EclipseETS/E10-BMS-HW/Master_Board/E10/V3/Documentation/BMS_MasterBoard_E10_3DRender_V2.pdf.jpg

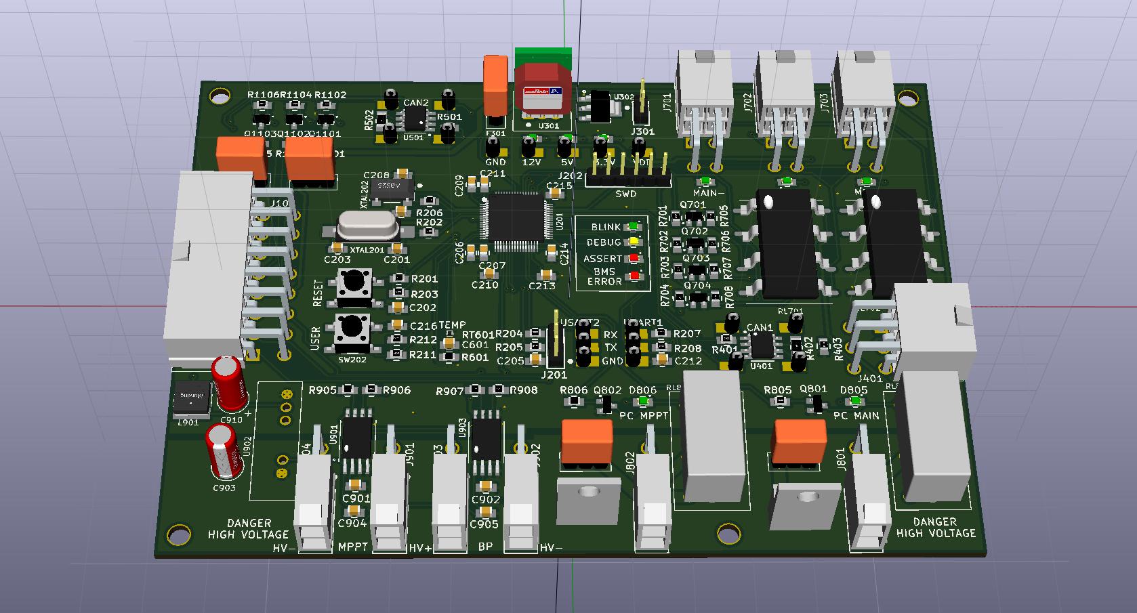
Master_Board/E10/V3/Documentation/BMS_MasterBoard_E10_3DRender_V2.pdf.jpg
