EclipseETS/E10-BMS-HW/Master_Board/E10/V3/Documentation/BMS_MasterBoard_E10_Layout_V2.pdf.JPG

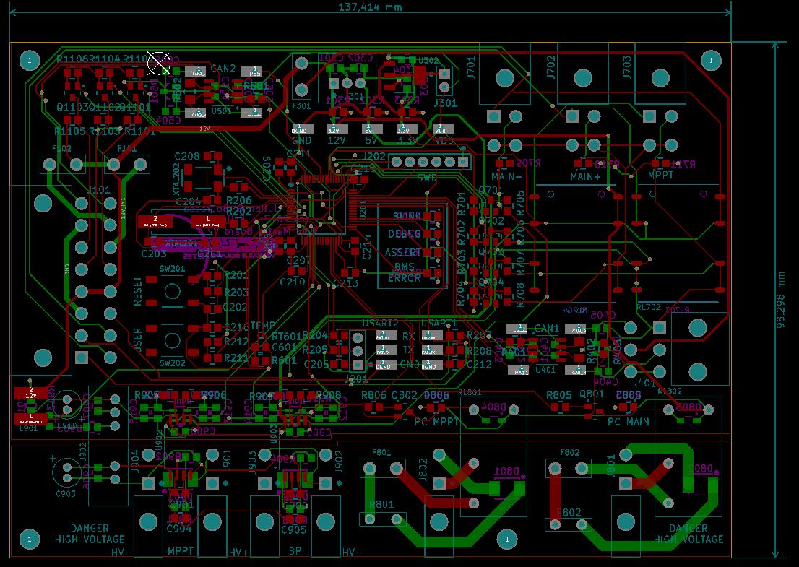
Master_Board/E10/V3/Documentation/BMS_MasterBoard_E10_Layout_V2.pdf.JPG
