EclipseETS/E10-BMS-HW/Master_Board/E10.1/V3/Documentation/bms master block diagram.pdf

## Battery Management System Block Diagram

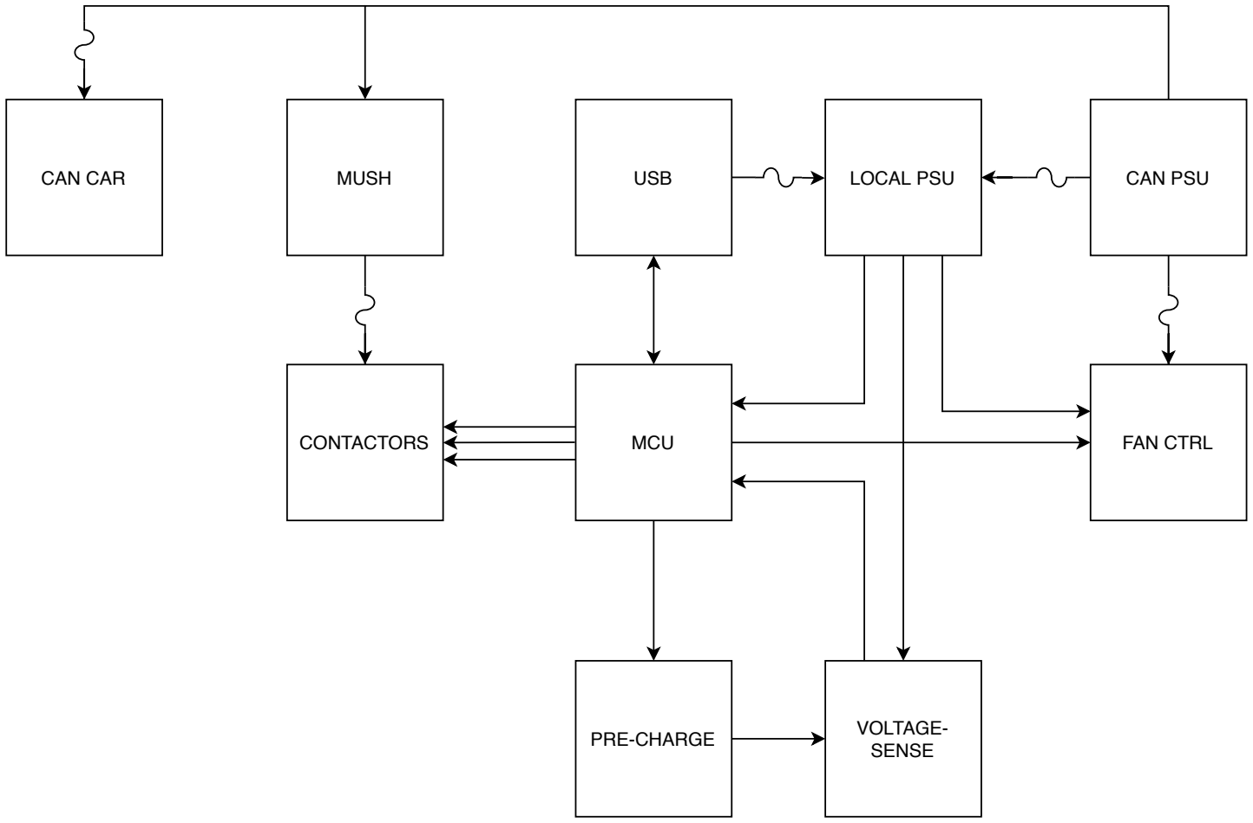
[picture p3: figure]
MCU; FAN CTRL; CAN CAR; MUSH; PRE-CHARGE; LOCAL PSU; CAN PSU; VOLTAGE- SENSE; CONTACTORS; USB
