EclipseETS/E10-BMS-HW/Current_Sense/V1/Current_sense_TOP.png

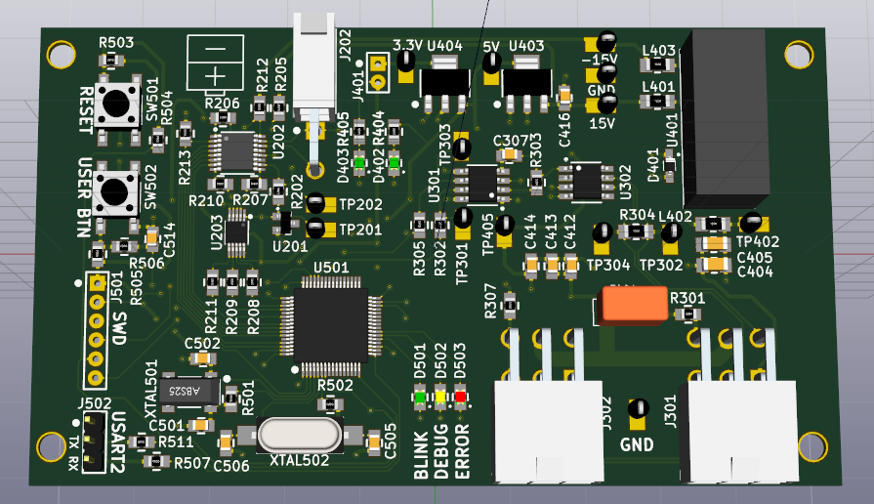
Current_Sense/V1/Current_sense_TOP.png
