EclipseETS/E10-BMS-HW/Current_Sense/V1/BOM/BMS_CurrentSense_BOM.xlsx

Digikey Part Number | Manufacturer | Manufacturer Part Number | Costumer Reference | Project | Qty | Unit Price | Total
732-7826-1-ND | Wurth Electronics Inc. | 885012007027 | Christian | BMS_CurrentSense | 2
732-7848-1-ND | Wurth Electronics Inc. | 885012007053 | Christian | BMS_CurrentSense | 3
732-7624-1-ND | Wurth Electronics Inc. | 885012007027 | Christian | BMS_CurrentSense | 3
732-7625-1-ND | Wurth Electronics Inc. | 885012107015 | Christian | BMS_CurrentSense | 3
732-7628-1-ND | Wurth Electronics Inc. | 885012107018 | Christian | BMS_CurrentSense | 8
732-8062-1-ND | Wurth Electronics Inc. | 885012207080 | Christian | BMS_CurrentSense | 4
732-8074-1-ND | Wurth Electronics Inc. | 885012207092 | Christian | BMS_CurrentSense | 1
732-8080-1-ND | Wurth Electronics Inc. | 885012207098 | Christian | BMS_CurrentSense | 13
732-7677-1-ND | Wurth Electronics Inc. | 885012207102 | Christian | BMS_CurrentSense | 3
445-8046-1-ND | TDK Corporation | C3216X5R1E336M160AC | Christian | BMS_CurrentSense | 10
732-4984-1-ND | Wurth Electronics Inc. | 150080RS75000 | Christian | BMS_CurrentSense | 1
732-4986-1-ND | Wurth Electronics Inc. | 150080VS75000 | Christian | BMS_CurrentSense | 3
732-4987-1-ND | Wurth Electronics Inc. | 150080YS75000 | Christian | BMS_CurrentSense | 1
D1213A-02SOL-7DICT-ND | Diodes Incorporated | D1213A-02SOL-7 | Christian | BMS_CurrentSense | 2
NSR0530HT1GOSCT-ND | ON Semiconductor | NSR0530HT1G | Christian | BMS_CurrentSense | 1
WK0009-ND | Littelfuse Inc. | 56200001009 | Christian | BMS_CurrentSense | 1
732-1937-ND | Wurth Electronics Inc. | 649002227222 | Christian | BMS_CurrentSense | 1
732-1939-ND | Wurth Electronics Inc. | 649006227222 | Christian | BMS_CurrentSense | 2
490-6706-1-ND | Murata Electronics North America | LQM31PN4R7M00L | Christian | BMS_CurrentSense | 3
311-0.0ARCT-ND | Yageo | RC0805JR-070RL | Christian | BMS_CurrentSense | 4
311-100ARCT-ND | Yageo | RC0805JR-07100RL | Christian | BMS_CurrentSense | 9
311-1.0KARCT-ND | Yageo | RC0805JR-071KL | Christian | BMS_CurrentSense | 2
311-22ARCT-ND | Yageo | RC0805JR-0722RL | Christian | BMS_CurrentSense | 3
311-2.2KARCT-ND | Yageo | RC0805JR-072K2L | Christian | BMS_CurrentSense | 1
311-470ARCT-ND | Yageo | RC0805JR-07470RL | Christian | BMS_CurrentSense | 5
311-47KARCT-ND | Yageo | RC0805JR-0747KL | Christian | BMS_CurrentSense | 3
311-4.7KARCT-ND | Yageo | RC0805JR-074K7L | Christian | BMS_CurrentSense | 3
311-120ERCT-ND | Yageo | RC1206JR-07120RL | Christian | BMS_CurrentSense | 1
CKN9112CT-ND | C&K | PTS645SM43SMTR92 LFS | Christian | BMS_CurrentSense | 2
ADC141S626CIMM/NOPBCT-ND | Texas Instruments | ADC141S626CIMM/NOPB | Christian | BMS_CurrentSense | 1
576-2568-1-ND | Microchip Technology | LM4040CYM3-4.1-TR | Christian | BMS_CurrentSense | 1
NCP1117LPST33T3GOSCT-ND | ON Semiconductor | NCP1117LPST33T3G | Christian | BMS_CurrentSense | 2
NCP1117ST50T3GOSCT-ND | ON Semiconductor | NCP1117ST50T3G | Christian | BMS_CurrentSense | 1
296-40483-1-ND | Texas Instruments | PGA281AIPWR | Christian | BMS_CurrentSense | 1
102-2825-ND | CUI Inc. | PQMC3-D12-D15-S | Christian | BMS_CurrentSense | 1
SI8422AB-D-IS-ND | Silicon Labs | SI8422AB-D-IS | Christian | BMS_CurrentSense | 1
296-26344-1-ND | Texas Instruments | SN65HVD232DR | Christian | BMS_CurrentSense | 1
497-15376-ND | STMicroelectronics | STM32F446RET6 | Christian | BMS_CurrentSense | 1
535-13445-2-ND | Abracon LLC | ABLS-8.000MHZ-D-T | Christian | BMS_CurrentSense | 1
535-10240-1-ND | Abracon LLC | ABS25-32.768KHZ-6-T | Christian | BMS_CurrentSense | 1
