EclipseETS/E10-BMS-HW/Slave/V1/BOM/Slave_Digikey.xlsx

Digikey Part Number | Manufacturer Name | Manufacturer Part Number | Costumer Reference | QTY | Circuit | Unit Price | Total | Grand Total
732-7826-1-ND | Wurth Electronics Inc. | 885012007027 | Christian | 2 | BMS_Slave | 0.15 | 0.3 | 331.151
732-7848-1-ND | Wurth Electronics Inc. | 885012007053 | Christian | 7 | BMS_Slave | 0.15 | 1.05
732-7616-1-ND | Wurth Electronics Inc. | 885012107005 | Christian | 1 | BMS_Slave | 0.44 | 0.44
732-7624-1-ND | Wurth Electronics Inc. | 885012007027 | Christian | 41 | BMS_Slave | 0.38 | 15.58
732-7625-1-ND | Wurth Electronics Inc. | 885012107015 | Christian | 13 | BMS_Slave | 0.22 | 2.86
732-7628-1-ND | Wurth Electronics Inc. | 885012107018 | Christian | 3 | BMS_Slave | 0.41 | 1.23
732-7660-1-ND | Wurth Electronics Inc. | 885012207047 | Christian | 8 | BMS_Slave | 0.25 | 2
732-8062-1-ND | Wurth Electronics Inc. | 885012207080 | Christian | 9 | BMS_Slave | 0.15 | 1.35
732-8074-1-ND | Wurth Electronics Inc. | 885012207092 | Christian | 1 | BMS_Slave | 0.15 | 0.15
732-8080-1-ND | Wurth Electronics Inc. | 885012207098 | Christian | 50 | BMS_Slave | 0.09 | 4.5
732-4984-1-ND | Wurth Electronics Inc. | 150080RS75000 | Christian | 10 | BMS_Slave | 0.1991 | 1.991
732-4986-1-ND | Wurth Electronics Inc. | 150080VS75000 | Christian | 12 | BMS_Slave | 0.25 | 3
732-4987-1-ND | Wurth Electronics Inc. | 150080YS75000 | Christian | 1 | BMS_Slave | 0.25 | 0.25
D1213A-02SOL-7DICT-ND | Diodes Incorporated | D1213A-02SOL-7 | Christian | 2 | BMS_Slave | 0.6 | 1.2
MMBZ12VALT1GOSCT-ND | ON Semiconductor | MMBZ12VALT1G | Christian | 10 | BMS_Slave | 0.283 | 2.83
NSR0530HT1GOSCT-ND | ON Semiconductor | NSR0530HT1G | Christian | 16 | BMS_Slave | 0.25 | 4
732-1937-ND | Wurth Electronics Inc. | 649002227222 | Christian | 10 | BMS_Slave | 2.24 | 22.4
732-1939-ND | Wurth Electronics Inc. | 649006227222 | Christian | 2 | BMS_Slave | 1.37 | 2.74
445-9496-1-ND | TDK Corporation | MLZ2012N101LT000 | Christian | 8 | BMS_Slave | 0.2 | 1.6
1727-4692-1-ND | Nexperia USA Inc. | 2N7002P,215 | Christian | 1 | BMS_Slave | 0.22 | 0.22
BSS806NH6327XTSA1CT-ND | Infineon Technologies | BSS806NH6327XTSA1 | Christian | 8 | BMS_Slave | 0.67 | 5.36
CPH6347-TL-WOSCT-ND | ON Semiconductor | MOSFET P-CH 20V 6A CPH6 | Christian | 24 | BMS_Slave | 0.67 | 16.08
A121124CT-ND | TE Connectivity Passive Product | 352210RJT | Christian | 8 | BMS_Slave | 1.22 | 9.76
311-12.1KCRCT-ND | Yageo | RC0805FR-0712K1L | Christian | 10 | BMS_Slave | 0.029 | 0.29
311-324KCRCT-ND | Yageo | RC0805FR-07324KL | Christian | 10 | BMS_Slave | 0.029 | 0.29
311-0.0ARCT-ND | Yageo | RC0805JR-070RL | Christian | 10 | BMS_Slave | 0.029 | 0.29
311-100KARCT-ND | Yageo | RC0805JR-07100KL | Christian | 10 | BMS_Slave | 0.029 | 0.29
311-100ARCT-ND | Yageo | RC0805JR-07100RL | Christian | 60 | BMS_Slave | 0.029 | 1.74
311-1.0KARCT-ND | Yageo | RC0805JR-071KL | Christian | 18 | BMS_Slave | 0.15 | 2.7
311-1.0MARCT-ND | Yageo | RC0805JR-071ML | Christian | 10 | BMS_Slave | 0.029 | 0.29
311-330ARCT-ND | Yageo | RC0805JR-07330RL | Christian | 10 | BMS_Slave | 0.029 | 0.29
311-33KARCT-ND | Yageo | RC0805JR-0733KL | Christian | 10 | BMS_Slave | 0.029 | 0.29
311-470KARCT-ND | Yageo | RC0805JR-07470KL | Christian | 30 | BMS_Slave | 0.029 | 0.87
311-470ARCT-ND | Yageo | RC0805JR-07470RL | Christian | 10 | BMS_Slave | 0.029 | 0.29
311-4.7KARCT-ND | Yageo | RC0805JR-074K7L | Christian | 50 | BMS_Slave | 0.029 | 1.45
311-560KARCT-ND | Yageo | RC0805JR-07560KL | Christian | 10 | BMS_Slave | 0.029 | 0.29
311-6.8KARCT-ND | Yageo | RC0805JR-076K8L | Christian | 10 | BMS_Slave | 0.029 | 0.29
311-120ERCT-ND | Yageo | RC1206JR-07120RL | Christian | 1 | BMS_Slave | 0.15 | 0.15
CKN9112CT-ND | C&K | PTS645SM43SMTR92 LFS | Christian | 2 | BMS_Slave | 0.23 | 0.46
ADC121S021CIMF/NOPBCT-ND | Texas Instruments | ADC121S021CIMF/NOPB | Christian | 8 | BMS_Slave | 4.41 | 35.28
ADCMP350YKSZ-REEL7CT-ND | Analog Devices Inc. | ADCMP350YKSZ-REEL7 | Christian | 8 | BMS_Slave | 1.69 | 13.52
AP2202K-ADJTRG1DICT-ND | Diodes Incorporated | AP2202K-ADJTRG1 | Christian | 8 | BMS_Slave | 0.65 | 5.2
AP3015KTR-G1 | Diodes Incorporated | AP3015KTR-G1 | Christian | 8 | BMS_Slave | 1.13 | 9.04
AZ1117IH-3.3TRG1DICT-ND | Diodes Incorporated | AZ1117IH-3.3TRG1 | Christian | 1 | BMS_Slave | 0.57 | 0.57
160-1361-5-ND | Lite-On Inc. | LTV-816S | Christian | 8 | BMS_Slave | 0.62 | 4.96
811-2196-5-ND | Murata Power Solutions Inc. | OKI-78SR-5/1.5-W36H-C | Christian | 1 | BMS_Slave | 6.25 | 6.25
SI8641AB-B-IS1-ND | Silicon Labs | SI8641AB-B-IS1 | Christian | 8 | BMS_Slave | 2.65 | 21.2
296-26344-1-ND | Texas Instruments | SN65HVD232DR | Christian | 1 | BMS_Slave | 2.78 | 2.78
497-15376-ND | STMicroelectronics | STM32F446RET6 | Christian | 10 | BMS_Slave | 12.01 | 120.1
535-13445-1-ND | Abracon LLC | ABLS-8.000MHZ-D-T | Christian | 1 | BMS_Slave | 0.46 | 0.46
535-10240-1-ND | Abracon LLC | ABS25-32.768KHZ-6-T | Christian | 1 | BMS_Slave | 0.63 | 0.63
