EclipseETS/E10-BMS-HW/Master_Board/E10/V3/BOM/Master_BOM.xlsx

Component | Description | References | Manufacturer | Manufacturer Part Number | Supplier | Supplier Part Number | Footprint | Quantity Per PCB
1 | CAP ALUM 47UF 20% 25V RADIAL | C903 C910 | Wurth Electronics Inc. | 860020472006 | Digikey | 732-8823-1-ND | Radial-Can-5_11_2 | 2
2 | CAP CER 6.8PF 25V C0G/NP0 0805 | C204 C208 | Wurth Electronics Inc. | 885012007027 | Digikey | 732-7826-1-ND | C0805 | 2
3 | CAP CER 22PF 50V C0G/NP0 0805 | C201 C203 C205 C212 C404 C405 C504 C505 | Wurth Electronics Inc. | 885012007053 | Digikey | 732-7848-1-ND | C0805 | 8
4 | CAP CER 22UF 6.3V X5R 0805 | C304 | Wurth Electronics Inc. | 885012107005 | Digikey | 732-7616-1-ND | C0805 | 1
5 | CAP CER 10UF 16V X5R 0805 | C303 | Wurth Electronics Inc. | 885012007027 | Digikey | 732-7624-1-ND | C0805 | 1
6 | CAP CER 1UF 25V X5R 0805 | C206 C209 C402 C502 C601 | Wurth Electronics Inc. | 885012107015 | Digikey | 732-7625-1-ND | C0805 | 5
7 | CAP CER 4.7UF 25V X5R 0805 | C213 C301 C302 | Wurth Electronics Inc. | 885012107018 | Digikey | 732-7628-1-ND | C0805 | 3
8 | CAP CER 0.33UF 25V X7R 0805 | C911 | Wurth Electronics Inc. | 885012207075 | Digikey | 732-7669-1-ND | C0805 | 1
9 | CAP CER 100PF 50V X7R 0805 | C401 C501 C901 C902 C912 C913 C914 C915 | Wurth Electronics Inc. | 885012207080 | Digikey | 732-8062-1-ND | C0805 | 8
10 | CAP CER 10000PF 50V X7R 0805 | C207 | Wurth Electronics Inc. | 885012207092 | Digikey | 732-8074-1-ND | C0805 | 1
11 | CAP CER 0.1UF 50V X7R 0805 | C202 C210 C211 C214 C215 C216 C403 C503 C904 C905 C906 C907 C908 C909 | Wurth Electronics Inc. | 885012207098 | Digikey | 732-8080-1-ND | C0805 | 14
12 | LED RED CLEAR 0805 SMD | D203 D1001 | Wurth Electronics Inc. | 150080RS75000 | Digikey | 732-4984-1-ND | LED_0805_RED | 2
13 | LED GREEN CLEAR 0805 SMD | D201 | Wurth Electronics Inc. | 150080VS75000 | Digikey | 732-4986-1-ND | LED_0805_GREEN | 1
14 | LED GREEN CLEAR 0805 SMD | D301 D302 D303 D701 D702 D703 D805 D806 | Wurth Electronics Inc. | 150080VS75000 | Digikey | 732-4986-1-ND | LED_0805_GREEN | 8
15 | LED YELLOW CLEAR 0805 SMD | D202 | Wurth Electronics Inc. | 150080YS75000 | Digikey | 732-4987-1-ND | LED_0805_YELLOW | 1
16 | TVS DIODE 3.3VWM 10VC SOT23 | D401 D501 | Diodes Incorporated | D1213A-02SOL-7 | Digikey | D1213A-02SOL-7DICT-ND | SOT-23-3 | 2
17 | DIODE SCHOTTKY 200V 3A SMB | D801 D802 D901 D902 | ON Semiconductor | NRVBS3200T3G | Digikey | NRVBS3200T3GOSCT-ND | DO-214AA_SMB | 4
18 | DIODE SCHOTTKY 30V 500MA SOD323 | D803 D804 | ON Semiconductor | NSR0530HT1G | Digikey | NSR0530HT1GOSCT-ND | SOD-323 | 2
19 | DIODE SCHOTTKY 20V 1A 0805 | D903 | AVX Corporation | SD0805S020S1R0 | Digikey | 478-7800-1-ND | Diode_0805 | 1
20 | FUSE BOARD MNT 1A 125VAC RADIAL | F101 F102 | Littelfuse Inc. | 39505000440 | Digikey | WK4341BK-ND | TE5_395 | 2
21 | FUSE HOLDER RADIAL 250V 6.3A PCB | F301 | Littelfuse Inc. | 56200001009 | Digikey | WK0009-ND | TE5_395 | 1
22 | FUSE BOARD MNT 2A 250VAC 450VDC | F801 F802 | Littelfuse Inc. | 80812000440 | Digikey | WK6289-ND | TE5_395 | 2
23 | HEADER MALE DUAL ANGLE W/MNT 2P | J801 J802 J901 J902 J903 J904 | Wurth Electronics Inc. | 649002227222 | Digikey | 732-1937-ND | 649002227222 | 6
24 | HEADER MALE DUAL ANGLE W/MNT 4P | J701 J702 J703 | Wurth Electronics Inc. | 649004227222 | Digikey | 732-1938-ND | 649004227222 | 3
25 | HEADER MALE DUAL ANGLE W/MNT 6P | J401 | Wurth Electronics Inc. | 649006227222 | Digikey | 732-1939-ND | 649006227222 | 1
26 | HEADER MALE DUAL ANGLE W/MNT 16P | J101 | Wurth Electronics Inc. | 649022227222 | Digikey | 732-4777-ND | 649016227222 | 1
27 | Pin Male Single Row Pin Header Strip | J301 | Manufacturer | Manufacturer Part Number | Ebay | Pin Male Single Row Pin Header Strip | Headers_2.54mm_1X2 | 1
28 | Pin Male Single Row Pin Header Strip | J201 | Manufacturer | Manufacturer Part Number | Ebay | Pin Male Single Row Pin Header Strip | Headers_2.54mm_1X3 | 1
29 | Pin Male Single Row Pin Header Strip | J202 | Manufacturer | Manufacturer Part Number | Ebay | Pin Male Single Row Pin Header Strip | Headers_2.54mm_1X6 | 1
30 | FIXED IND 470UH 140MA 5.5 OHM | L901 | Wurth Electronics Inc. | 744052471 | Digikey | 732-3668-1-ND | WE-TPC-SMD | 1
31 | TRANS NPN 30V 0.1A SOT-23 | Q701 Q702 Q703 Q704 Q801 Q802 | ON Semiconductor | BC849BLT1G | Digikey | BC849BLT1GOSCT-ND | SOT-23-3 | 6
32 | MOSFET N-CH 20V 2.3A SOT23 | Q1101 Q1102 Q1103 | Infineon Technologies | BSS806NH6327XTSA1 | Digikey | BSS806NH6327XTSA1CT-ND | SOT-23-3 | 3
33 | RES SMD 0.0 OHM JUMPER 1/8W 0805 | R202 R206 R403 | Yageo | RC0805JR-070RL | Digikey | 311-0.0ARCT-ND | R0805 | 3
34 | RES SMD 100K OHM 5% 1/8W 0805 | R1102 R1104 R1106 | Yageo | RC0805JR-07100KL | Digikey | 311-100KARCT-ND | R0805 | 3
35 | RES SMD 100 OHM 5% 1/8W 0805 | R203 R211 R401 R501 | Yageo | RC0805JR-07100RL | Digikey | 311-100ARCT-ND | R0805 | 4
36 | RES SMD 10K OHM 5% 1/8W 0805 | R701 R702 R703 R704 R805 R806 R902 R904 R905 R906 R907 R908 | Yageo | RC0805JR-0710KL | Digikey | 311-10KARCT-ND | R0805 | 12
37 | RES SMD 15K OHM 5% 1/8W 0805 | R909 R910 R911 R912 | Yageo | RC0805JR-0715KL | Digikey | 311-15KARTR-ND | R0805 | 4
38 | RES SMD 1K OHM 5% 1/8W 0805 | R205 R208 R302 R709 R710 R711 R803 R804 | Yageo | RC0805JR-071KL | Digikey | 311-1.0KARCT-ND | R0805 | 8
39 | RES SMD 1M OHM 5% 1/8W 0805 | R901 R903 | Yageo | RC0805JR-071ML | Digikey | 311-1.0MARCT-ND | R0805 | 2
40 | RES SMD 2.2K OHM 5% 1/8W 0805 | R705 R706 R707 R708 | Yageo | RC0805JR-072K2L | Digikey | 311-2.2KARCT-ND | R0805 | 4
41 | RES SMD 330 OHM 5% 1/8W 0805 | R1001 | Yageo | RC0805JR-07330RL | Digikey | 311-330ARCT-ND | R0805 | 1
42 | RES SMD 33K OHM 5% 1/8W 0805 | R601 | Yageo | RC0805JR-0733KL | Digikey | 311-33KARCT-ND | R0805 | 1
43 | RES SMD 470 OHM 5% 1/8W 0805 | R209 R210 R213 R303 R913 | Yageo | RC0805JR-07470RL | Digikey | 311-470ARCT-ND | R0805 | 5
44 | RES SMD 4.7K OHM 5% 1/8W 0805 | R201 R204 R207 R212 R301 R1101 R1103 R1105 | Yageo | RC0805JR-074K7L | Digikey | 311-4.7KARCT-ND | R0805 | 8
45 | RES SMD 120 OHM 5% 1/4W 1206 | R402 R502 | Yageo | RC1206JR-07120RL | Digikey | 311-120ERCT-ND | R1206 | 2
46 | RES 100 OHM 50W 5% TO220 | R801 R802 | Stackpole Electronics Inc. | TR50JBC100R | Digikey | TR50JBC100R-ND | TR50 | 2
47 | RELAY GEN PURPOSE SPST 10A 12V | RL801 RL802 | Panasonic Electric Works | ALQ312 | Digikey | 255-3556-ND | ALQ312 | 2
48 | RELAY OPTOMOS SP-NO 6A 8-SOP | RL701 RL702 RL703 RL704 | IXYS Integrated Circuits Division | CPC1907B | Digikey | CLA394-ND | CPC1907B | 4
49 | NTC THERMISTOR 47K OHM 1% 0402 | RT601 | Murata Electronics North America | NCP15WB473F03RC | Digikey | 490-4802-1-ND | R0402 | 1
50 | SWITCH TACTILE SPST-NO 0.05A 12V | SW201 SW202 | C&K | PTS645SM43SMTR92 LFS | Digikey | CKN9112CT-ND | PTS645_6X6X4_SMD | 2
51 | Precision Optically Isolated Voltage Sensor | U901 U903 | Broadcom Limited | ACPL-C87A-500E | Digikey | 516-3140-1-ND | SSO-8 | 2
52 | IC REG LDO 3.3V 0.8A SOT223 | U302 | Diodes Incorporated | AZ1117IH-3.3TRG1 | Digikey | AZ1117IH-3.3TRG1DICT-ND | SOT-223-3 | 1
53 | IC OPAMP GP 1.3MHZ RRO SOT23-5 | U904 U905 | STMicroelectronics | LMV321RILT | Digikey | 497-4942-1-ND | SOT-23-5 | 2
54 | DC/DC CONVERTER 5V 1W | U902 | Murata Power Solutions Inc. | NCS1S2405SC | Digikey | 811-2948-ND | NCS1S2405SC | 1
55 | DC/DC CONVERTER 5V 8W | U301 | Murata Power Solutions Inc. | OKI-78SR-5/1.5-W36H-C | Digikey | 811-2196-5-ND | OKI-78SR_Vertical | 1
56 | IC CAN TRANSCEIVER 3.3V 8-SOIC | U401 U501 | Texas Instruments | SN65HVD232DR | Digikey | 296-26344-1-ND | SOIC-8 | 2
57 | IC MCU 32BIT 512KB FLASH 64LQFP | U201 | STMicroelectronics | STM32F446RET6 | Digikey | 497-15376-ND | LQFP-64 | 1
58 | CRYSTAL 8.0000MHZ 18PF SMD | XTAL201 | Abracon LLC | ABLS-8.000MHZ-D-T | Digikey | 535-13445-2-ND | HC49_US | 1
59 | CRYSTAL 32.7680KHZ 6PF SMD | XTAL202 | Abracon LLC | ABS25-32.768KHZ-6-T | Digikey | 535-10240-1-ND | ABS25 | 1
Component Groups: | 59
Component Count: | 176
Fitted Components: | 176
Number of PCBs: | 1
Total components: | 176
Schematic Version: | V2
Schematic Date: | 2017-06-25
BoM Date: | 02/11/2017 12:07:21 AM
Schematic Source: | C:/git/E10-BMS-HW/Master_Board/V2/Master_Board.sch
KiCad Version: | Eeschema 4.0.6
