EclipseETS/E10-BMS-HW/Slave/V1/Slave_bom_montage.pdf

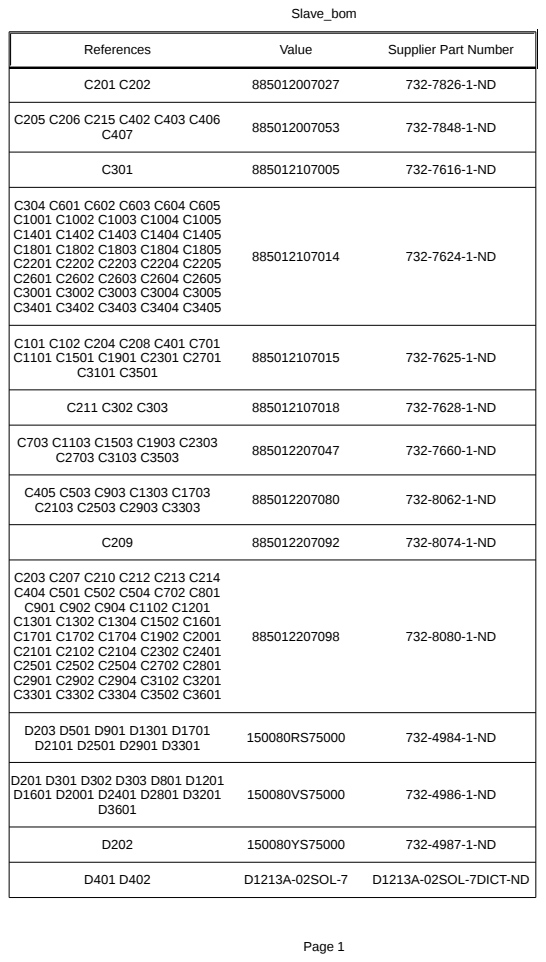
[picture p5: page 1]

MMBZ12VALT1G | MMBZ12VALT1GOSCT-ND
NSR0530HT1G | NSR0530HT1GOSCT-ND
| 39511000440 | WK0009-ND
| 649002227222 | 732-1937-ND
J401 J402 | 649006227222 | 732-1939-ND

J300

J202

J201

| MLZ2012N101LT000 | 445-9496-1-ND
Q101 | 2N7002P,215 | 1727-4692-1-ND
CPH6347-TL-W | CPH6347-TL-WOSCT-ND
| 352210RJT | A121124CT-ND
| RC0805FR-0712K1L | 311-12.1KCRCT-ND
| RC0805FR-07324KL | 311-324KCRCT-ND
R201 R202 R403 R404 | RC0805JR-070RL | 311-0.0ARCT-ND

D802 D1202 D1602 D2002 D2402 D2802 D3202 D3602

D502 D601 D902 D1001 D1302 D1401 D1702 D1801 D2102 D2201 D2502 D2601 D2902 D3001 D3302 D3401

F301 F501 F901 F1301 F1701 F2101 F2501 F2901 F3301

J101 J102 J501 J901 J1301 J1701 J2101 J2501 J2901 J3301

Header_Male_Pin_2.5
4mm_1X2_,_Unshroud
ed

Pin Male Single Row Pin
Header Strip

Header_Male_Pin_2.5
4mm_1X3_,_Unshroud
ed

Pin Male Single Row Pin
Header Strip

Header_Male_Pin_2.5
4mm_1X6_,_Unshroud
ed

Pin Male Single Row Pin
Header Strip

L601 L1001 L1401 L1801 L2201 L2601 L3001 L3401

Q802 Q1202 Q1602 Q2002 Q2402 Q2802 Q3202 Q3602

BSS806NH6327XTSA
1

BSS806NH6327XTSA1CT-ND

Q501 Q502 Q801 Q901 Q902
Q1201 Q1301 Q1302 Q1601 Q1701 Q1702 Q2001 Q2101 Q2102 Q2401 Q2501 Q2502 Q2801 Q2901 Q2902 Q3201 Q3301 Q3302 Q3601

R804 R1204 R1604 R2004 R2404 R2804 R3204 R3604

R604 R1004 R1404 R1804 R2204 R2604 R3004 R3404

R602 R1002 R1402 R1802 R2202 R2602 R3002 R3402

RC0805JR-07100KL | 311-100KARCT-ND
RC0805JR-07100RL | 311-100ARCT-ND
RC0805JR-071KL | 311-1.0KARCT-ND
| RC0805JR-071ML | 311-1.0MARCT-ND
| RC0805JR-07330RL | 311-330ARCT-ND
R102 R103 | RC0805JR-0733KL | 311-33KARCT-ND
RC0805JR-07470KL | 311-470KARCT-ND
R101 R208 R209 R210 R303 | RC0805JR-07470RL | 311-470ARCT-ND
RC0805JR-074K7L | 311-4.7KARCT-ND
| RC0805JR-07560KL | 311-560KARCT-ND
| RC0805JR-076K8L | 311-6.8KARCT-ND
R402 | RC1206JR-07120RL | 311-120ERCT-ND

R805 R1205 R1605 R2005 R2405 R2805 R3205 R3605

R204 R206 R401 R405 R504 R505 R506 R507 R508 R509 R701 R904 R905 R906 R907 R908 R909 R1101 R1304 R1305 R1306 R1307 R1308 R1309 R1501 R1704 R1705 R1706 R1707 R1708 R1709 R1901 R2104 R2105 R2106 R2107 R2108 R2109 R2301 R2504 R2505 R2506 R2507 R2508 R2509 R2701 R2904 R2905 R2906 R2907 R2908 R2909 R3101 R3304 R3305 R3306 R3307 R3308 R3309 R3501

R211 R302 R501 R802 R901 R1202 R1301 R1602 R1701 R2002 R2101 R2402 R2501 R2802 R2901 R3202 R3301 R3602

R601 R1001 R1401 R1801 R2201 R2601 R3001 R3401

R503 R903 R1303 R1703 R2103 R2503 R2903 R3303

R502 R514 R801 R902 R914 R1201 R1302 R1314 R1601 R1702 R1714 R2001 R2102 R2114 R2401 R2502 R2514 R2801 R2902 R2914 R3201 R3302 R3314 R3601

R203 R205 R207 R301 R510 R511 R512 R513 R603 R910 R911 R912 R913 R1003 R1310 R1311 R1312 R1313 R1403 R1710 R1711 R1712 R1713 R1803 R2110 R2111 R2112 R2113 R2203 R2510 R2511 R2512 R2513 R2603 R2910 R2911 R2912 R2913 R3003 R3310 R3311 R3312 R3313 R3403

R803 R1203 R1603 R2003 R2403 R2803 R3203 R3603

R806 R1206 R1606 R2006 R2406 R2806 R3206 R3606

SW201 SW202 | PTS645SM43SMTR92 | CKN9112CT-ND

AP2202K-ADJTRG1

| AP3015KTR-G1 | AP3015KTR-G1
U302 | AZ1117IH-3.3TRG1
| LTV-816S | 160-1361-5-ND
U301 | | 811-2196-5-ND
| SI8641AB-B-IS1 | SI8641AB-B-IS1-ND
U401 | SN65HVD232DR | 296-26344-1-ND
U201 | STM32F446RE | 497-15376-ND
XTAL202 | ABLS-8.000MHZ-D-T | 535-13445-2-ND
XTAL201 | ABS25-32.768KHZ-6-T | 535-10240-1-ND

U701 U1101 U1501 U1901 U2301 U2701 U3101 U3501

ADC121S021CIMF/NO
PB

ADC121S021CIMF/NOPBC
T-ND

U801 U1201 U1601 U2001 U2401 U2801 U3201 U3601

ADCMP350YKSZ-REEL7

ADCMP350YKSZ-REEL7CT-ND

U602 U1002 U1402 U1802 U2202 U2602 U3002 U3402

AP2202K-ADJTRG1DICT-ND

U601 U1001 U1401 U1801 U2201 U2601 U3001 U3401

AZ1117IH-3.3TRG1DICT-ND

U501 U901 U1301 U1701 U2101 U2501 U2901 U3301

OKI-78SR-5/1.5-W36-
C

U502 U902 U1302 U1702 U2102 U2502 U2902 U3302
