EclipseETS/E10-BMS-HW/(threads)

Thread 1 (2017-08-22):

Simuler les filtres pour le Slave

chrisdsa, 2017-08-22:
Low Pass : fc = 5Hz   BP = A determiner

Low Pass => Pour detecter les erreurs

Band pass => Pour obtenir l'impédance des modules en temps réel.

Simuler le tout dans Matlab Simulink

chrisdsa, 2017-08-22:
Moved to E10-BMS-Slave

Closed 2017-08-22.

Thread 3 (2017-11-03):

Souder la quantité minimale de boards du BMS

oclarocque, 2017-11-03:
Une 2e version des boards (master, slave et current sense) a été fabriquée. On devra souder minimalement 1 master, 4 slaves et 1 current sense étant donné la configuration de 13p32s du battery pack d'Éclipse 10.

- [x] Master

- [x] Slave 1

- [x] Slave 2

- [x] Slave 3

- [x] Slave 4

- [x] Current Sense

chrisdsa, 2017-11-15:
Voir la commande Digikey : http://www.digikey.com/short/q3q1j3
Trouver des alternatives aux pieces out of stock

chrisdsa, 2017-11-15:
Reste a modifier la commande

Closed 2019-05-10.

Thread 4 (2017-12-15):

Mush sur le master

jfchenier, 2017-12-15:
Dans la révision B des règlement de la ASC, un nouveau règlement est apparu

8.6.C.4 Operation: To operate the external actuator, it must require only a single simple action such as
‘push’, ‘pull’ or ‘twist’ etc. External actuator must also illuminate the BPS Fault indication including BPS
Fault Dash Indicator.

Cela veux dire que le mush ne peut pas killer la voiture au complet. Christian et moi avons conclu qu'étant donné que nous devons faire une révision 3 du Master nous devripons mettre le mush directement sur l'alimentation des relais. Dans le cas d'un appuie sur le mush les relais s'ouvernt et le power supply switch automatiquement l'allimentation sur la batterie auxiliaire.

P-OMeilleur, 2019-05-10:
Features implémenté sur la V3 du master E10

Closed 2019-05-10.
