EclipseETS/E10-BMS-HW/Master_Board/E10/V3/Documentation/BMS_MasterBoard_E10_Schematic_V2.pdf

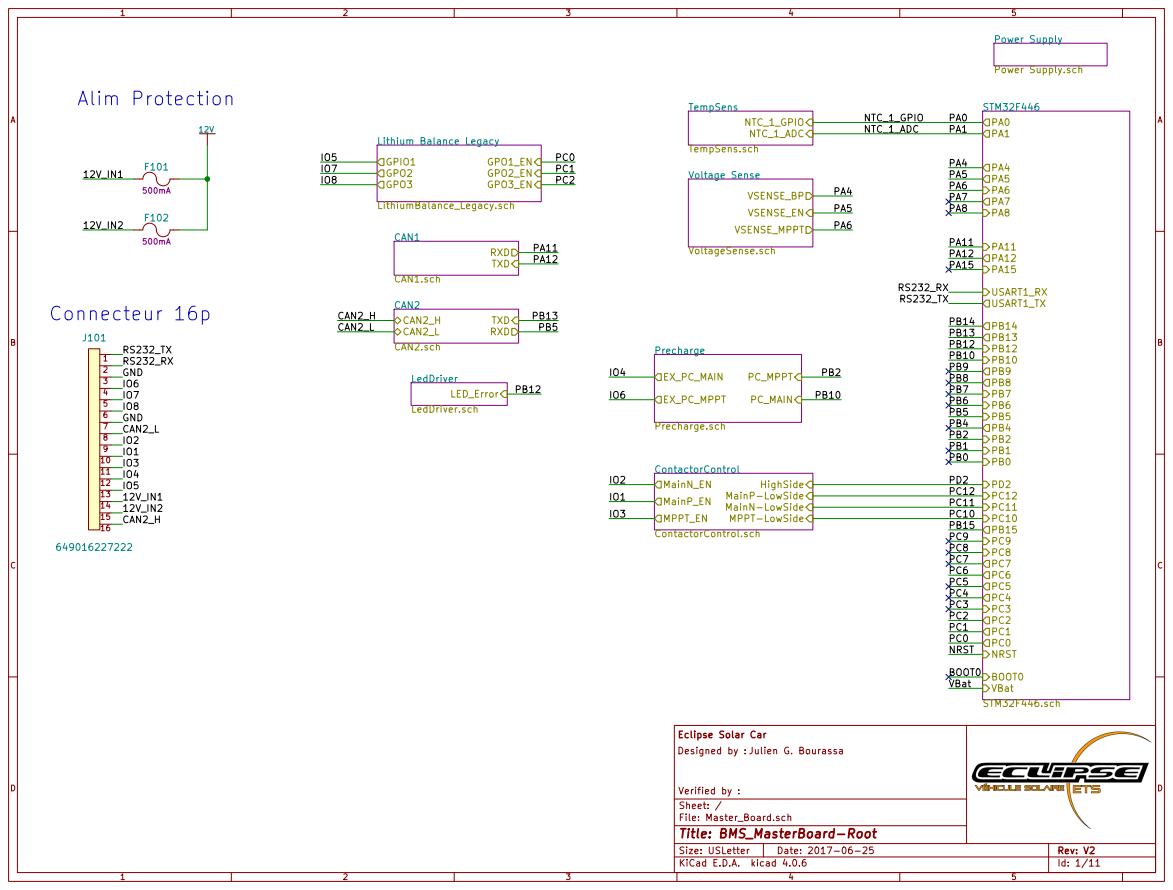
[picture p6: page 1]

File: Master_Board.sch Sheet: / Eclipse Solar Car

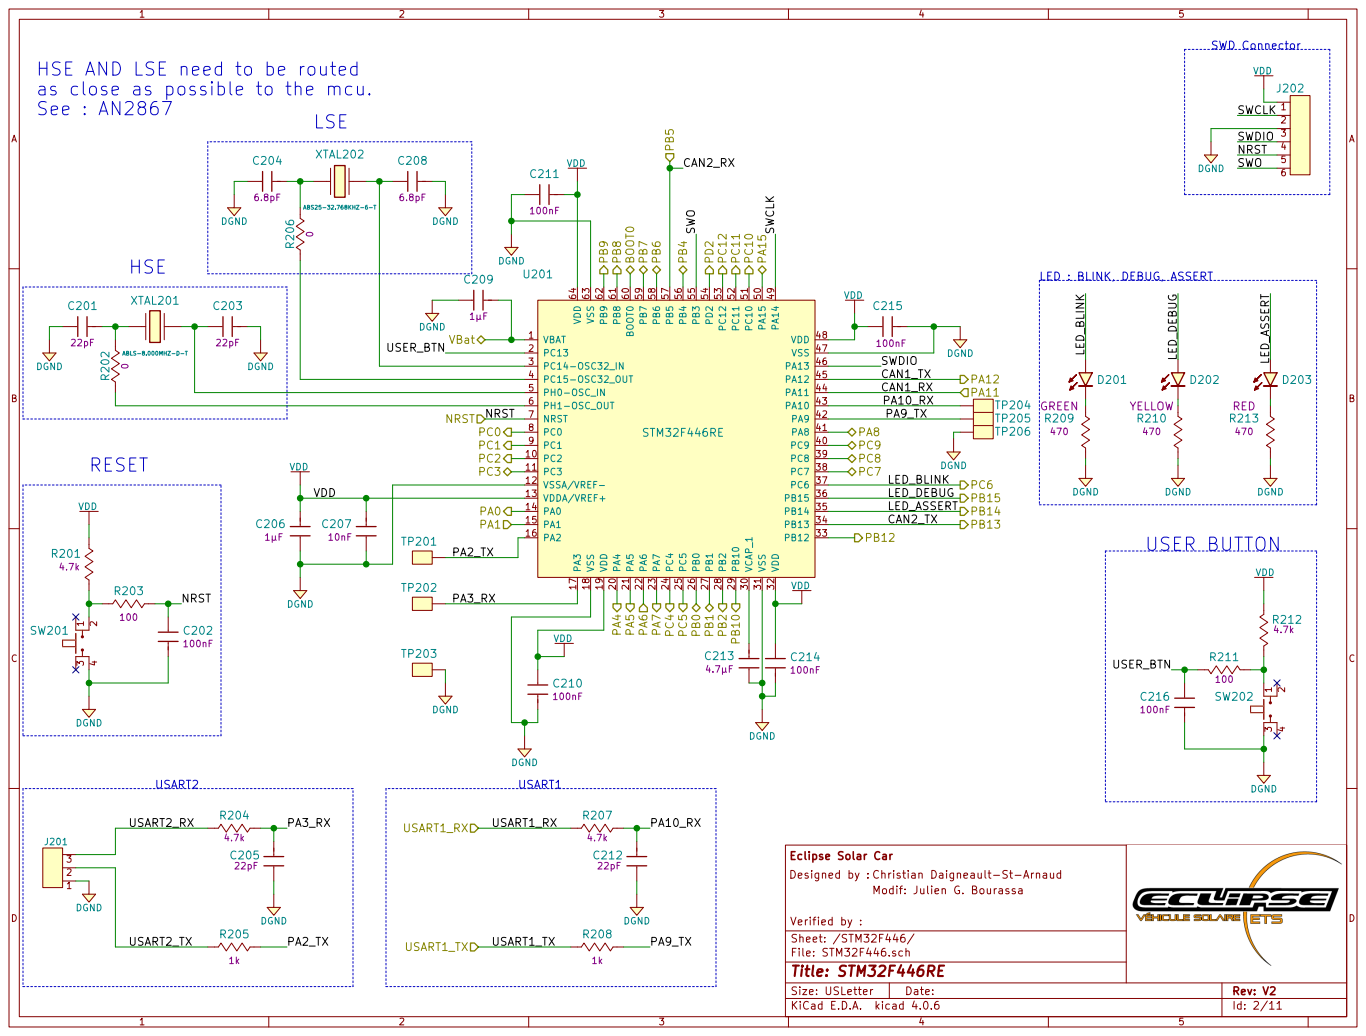
[picture p7: page 2]

HSE AND LSE need to be routed
as close as possible to the mcu.
See : AN2867

LED : BLINK, DEBUG, ASSERT
470 LED_DEBUG

File: STM32F446.sch Sheet: /STM32F446/ Eclipse Solar Car
Christian Daigneault-St-Arnaud Modif: Julien G. Bourassa Designed by :

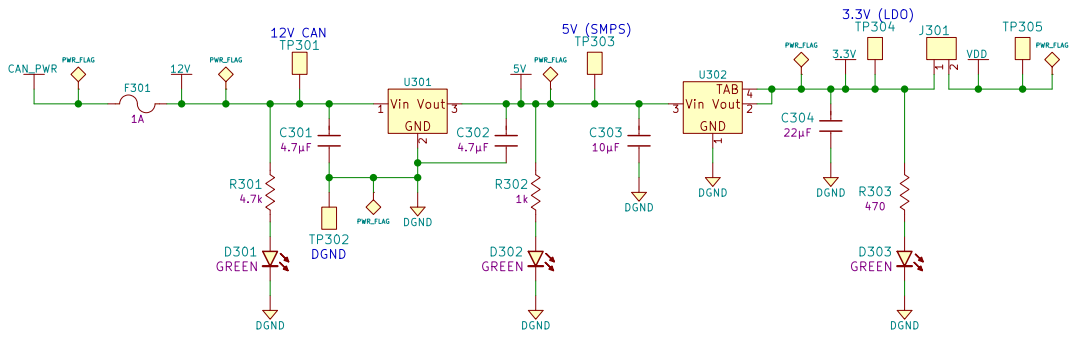
[picture p8: page 3]

Verified by : | Rev: V2

D Date: KiCad E.D.A. kicad 4.0.6 Size: USLetter

Sheet: /Power Supply/
File: Power Supply.sch
Id: 3/11 Title: Power Supply

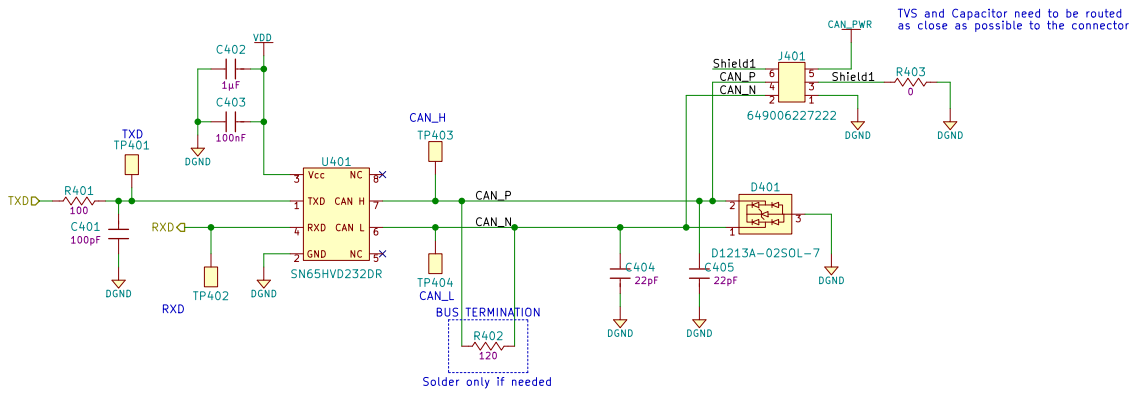
[picture p9: page 4]

TVS and Capacitor need to be routed

as close as possible to the connector TP403 TP404 CAN_L

120 CAN_P

7 | CAN_N | | 2

Solder only if needed

File: CAN1.sch Sheet: /CAN1/ Eclipse Solar Car
Christian Daigneault-St-Arnaud Modif: Julien G. Bourassa Designed by :

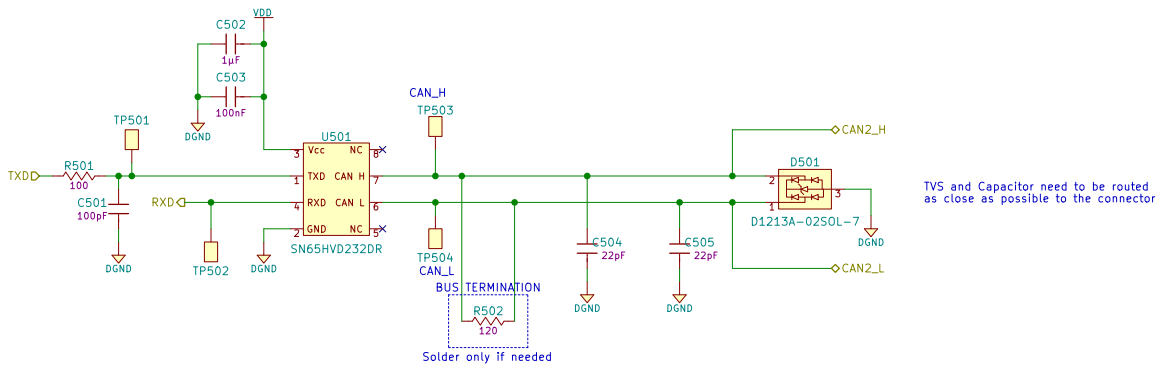
[picture p10: page 5]

CAN_H
as close as possible to the connector TP503 TP504 CAN_L

TVS and Capacitor need to be routed

Solder only if needed

File: CAN2.sch Sheet: /CAN2/ Eclipse Solar Car
Christian Daigneault-St-Arnaud Modif: Julien G. Bourassa Designed by :

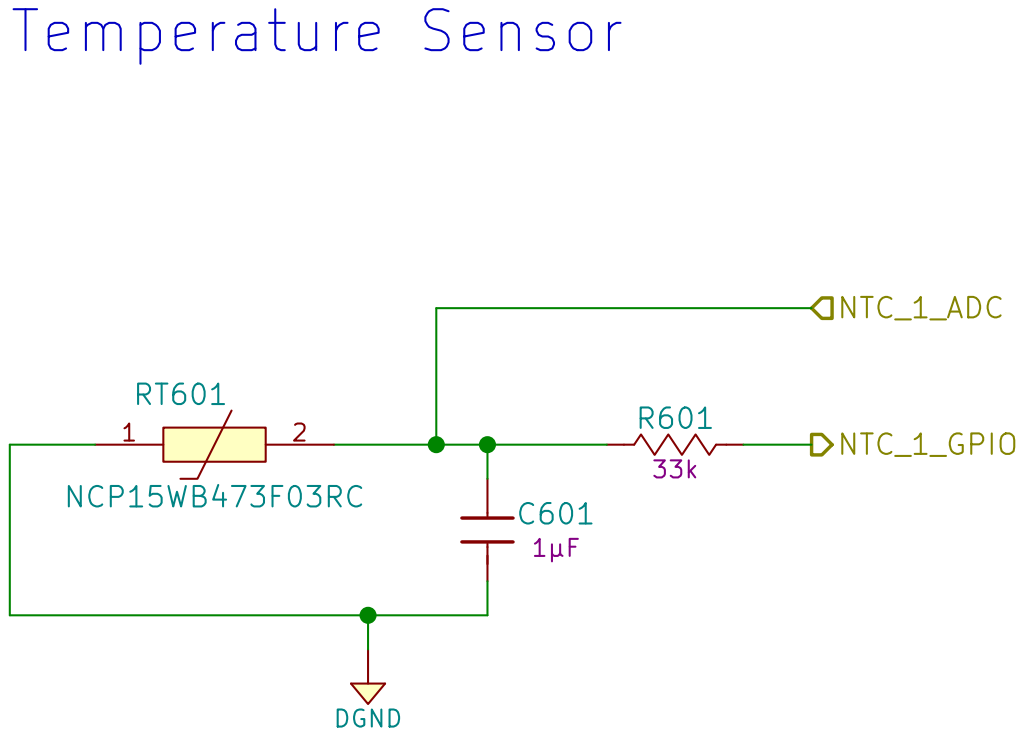
[picture p11: page 6]

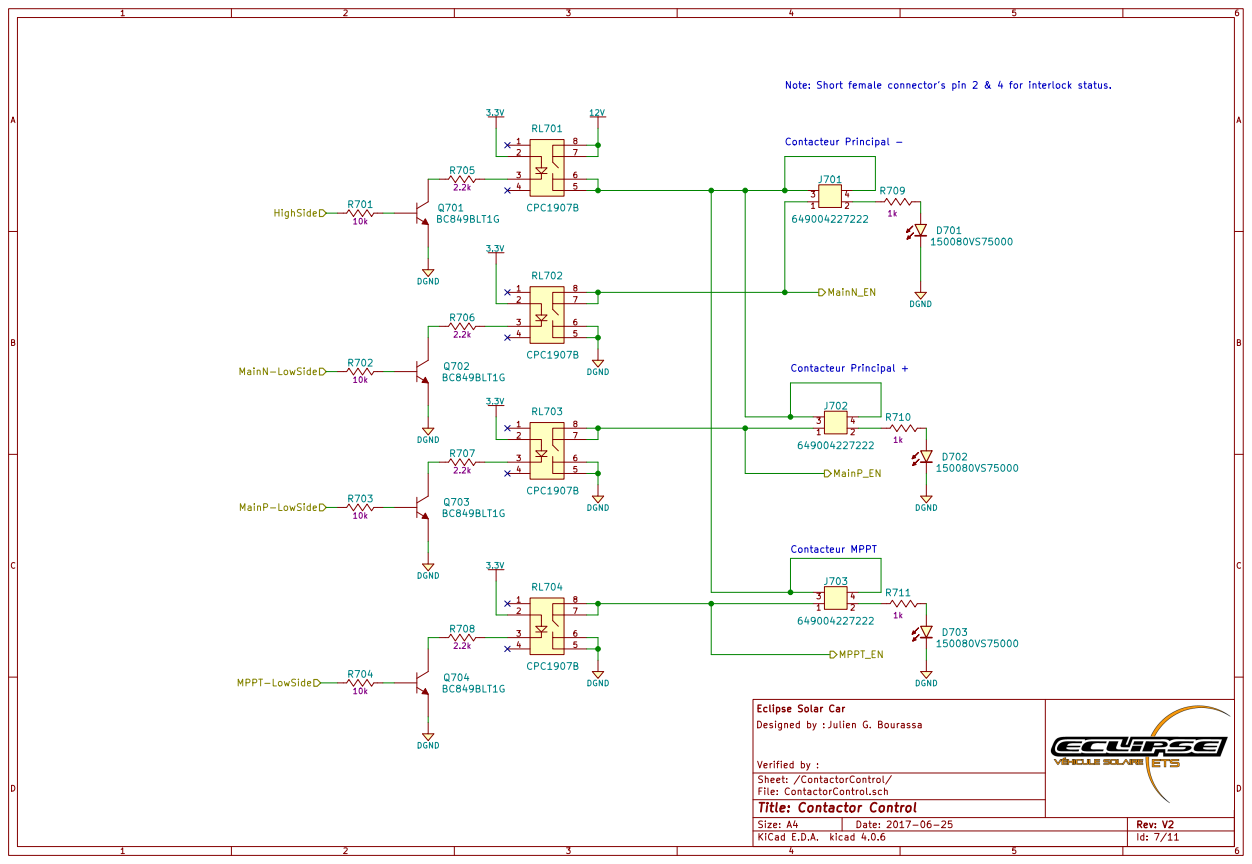
[picture p12: page 7]

Note: Short female connector's pin 2 & 4 for interlock status. 3.3V

Id: 7/11 Title: Contactor Control File: ContactorControl.sch Sheet: /ContactorControl/ Eclipse Solar Car

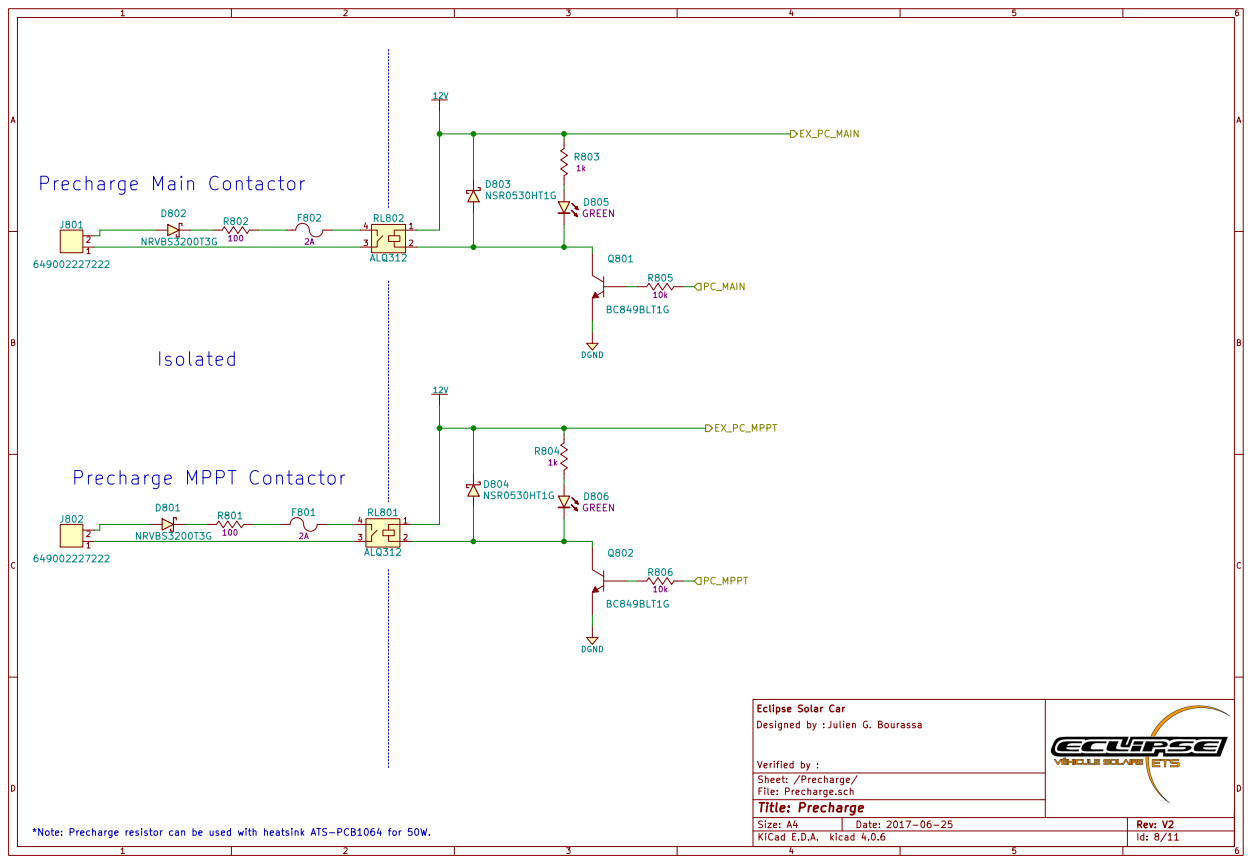
[picture p13: page 8]

*Note: Precharge resistor can be used with heatsink ATS-PCB1064 for 50W.

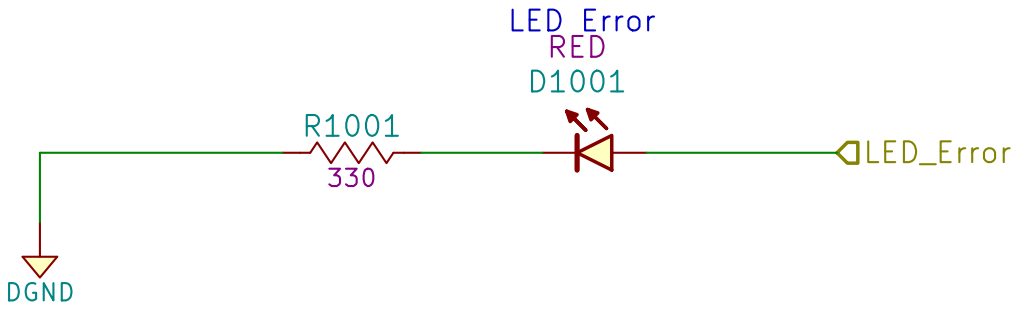
[picture p14: page 9]

Id: 9/11 Title: LED Driver File: LedDriver.sch Sheet: /LedDriver/ Eclipse Solar Car

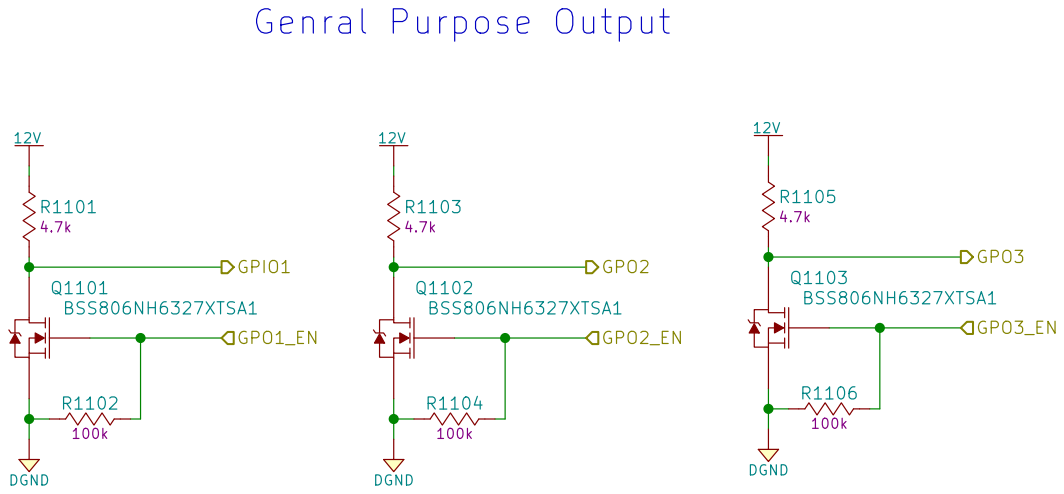
[picture p15: page 10]

Sheet: /Lithium Balance Legacy/
File: LithiumBalance_Legacy.sch
Id: 10/11 Title: BMS_MasterBoard-Root

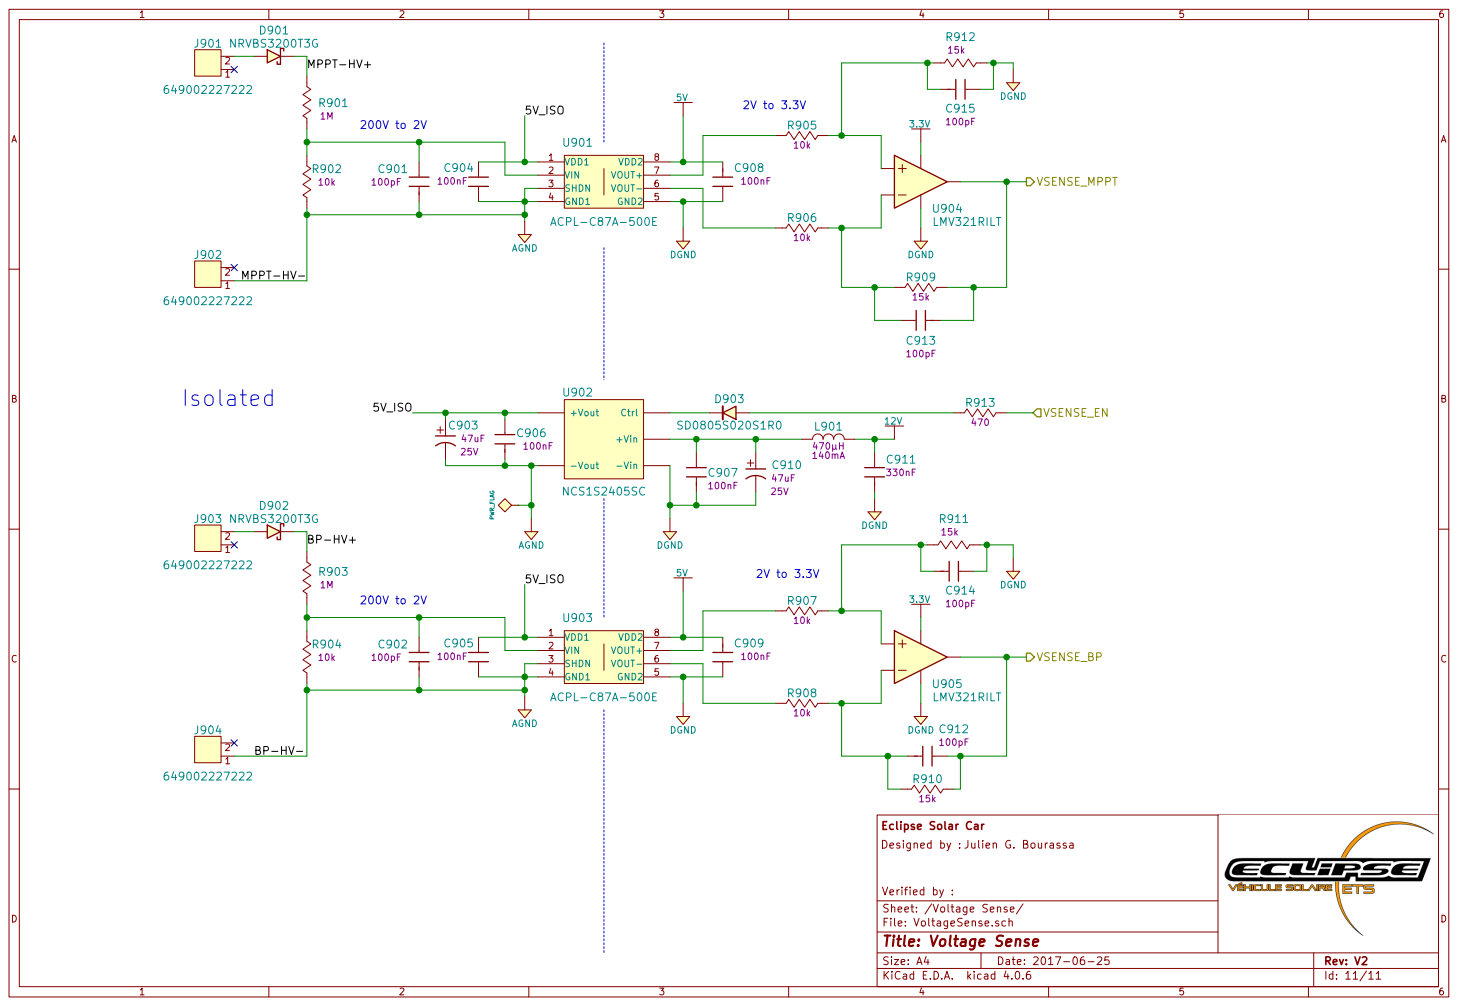
[picture p16: page 11]

Sheet: /Voltage Sense/
File: VoltageSense.sch
Id: 11/11 Title: Voltage Sense
