EclipseETS/E10-BMS-HW/Current_Sense/V1/Isolated_BMS_Slave_Current_Sense.pdf

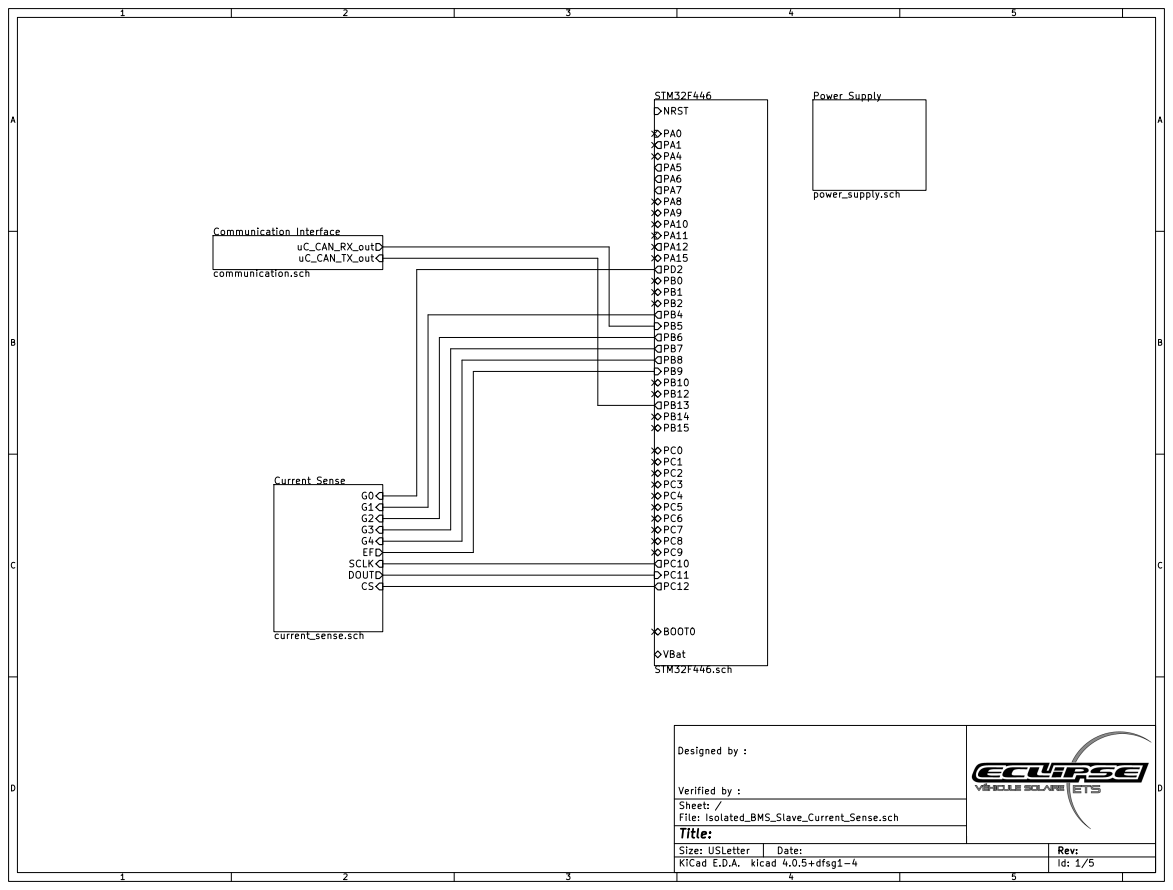
[picture p17: page 1]

File: Isolated_BMS_Slave_Current_Sense.sch Sheet: / Designed by :

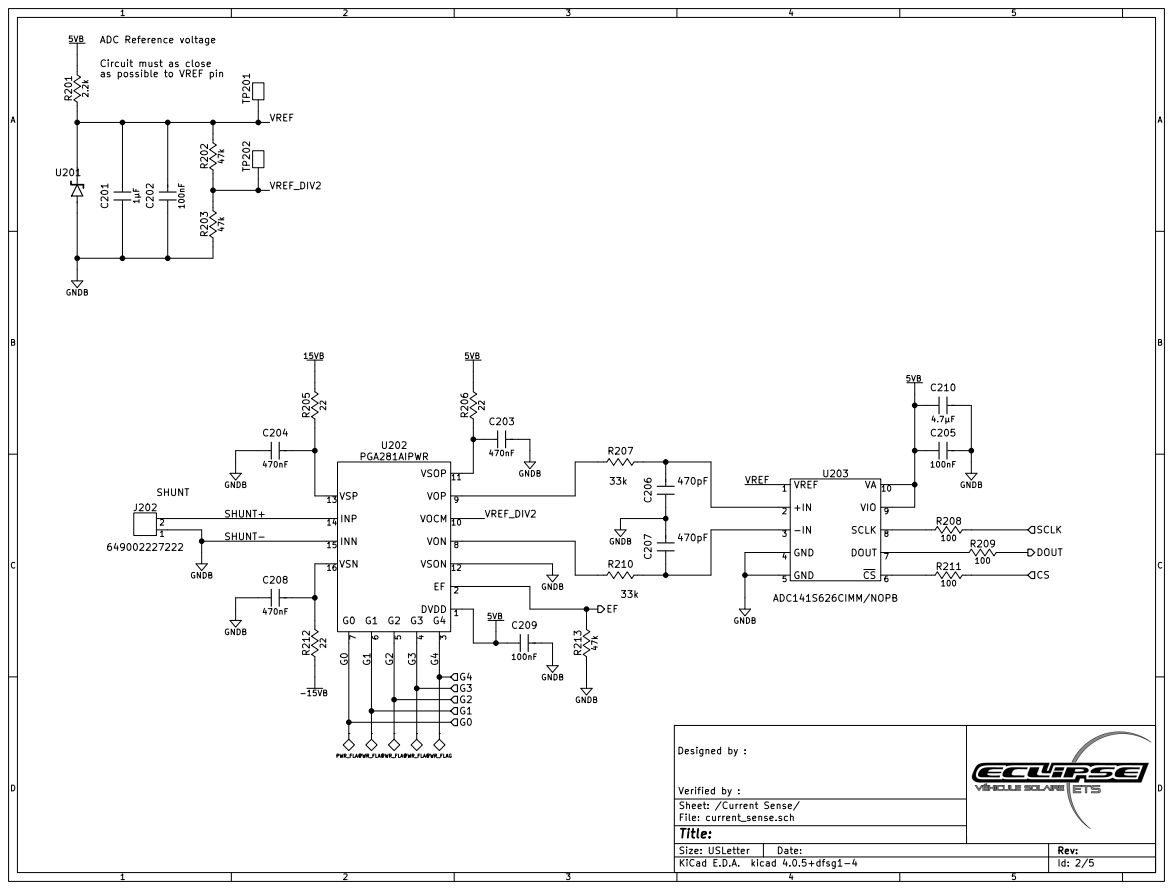
[picture p18: page 2]

Circuit must as close

File: current_sense.sch Sheet: /Current Sense/ Designed by :

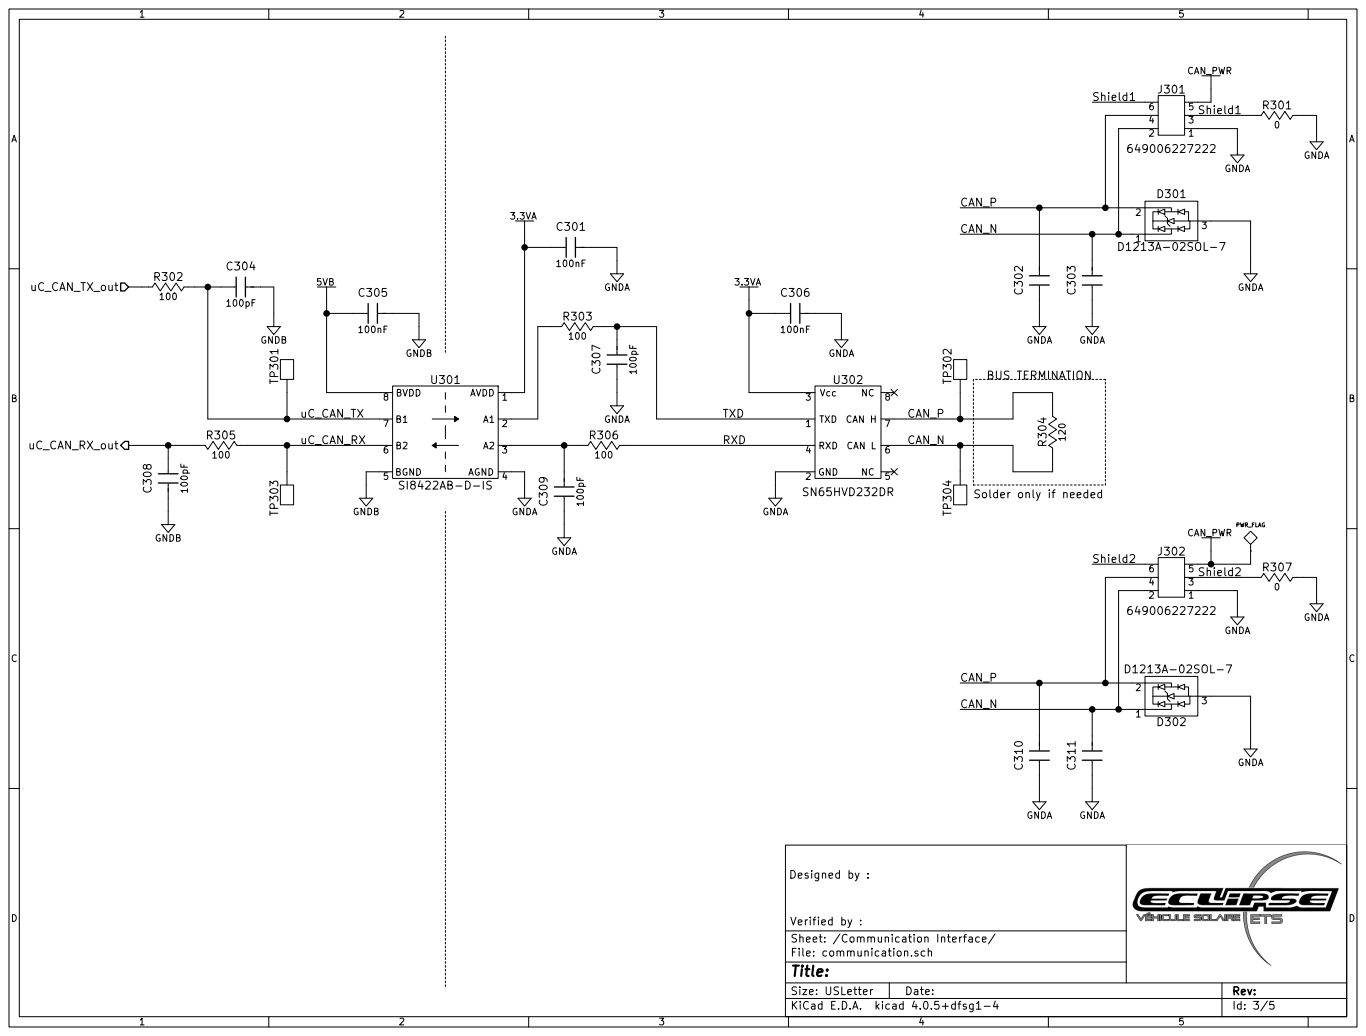
[picture p19: page 3]

Solder only if needed TP302 TP304 TXD

Id: 3/5 Title: File: communication.sch Sheet: /Communication Interface/ Designed by :

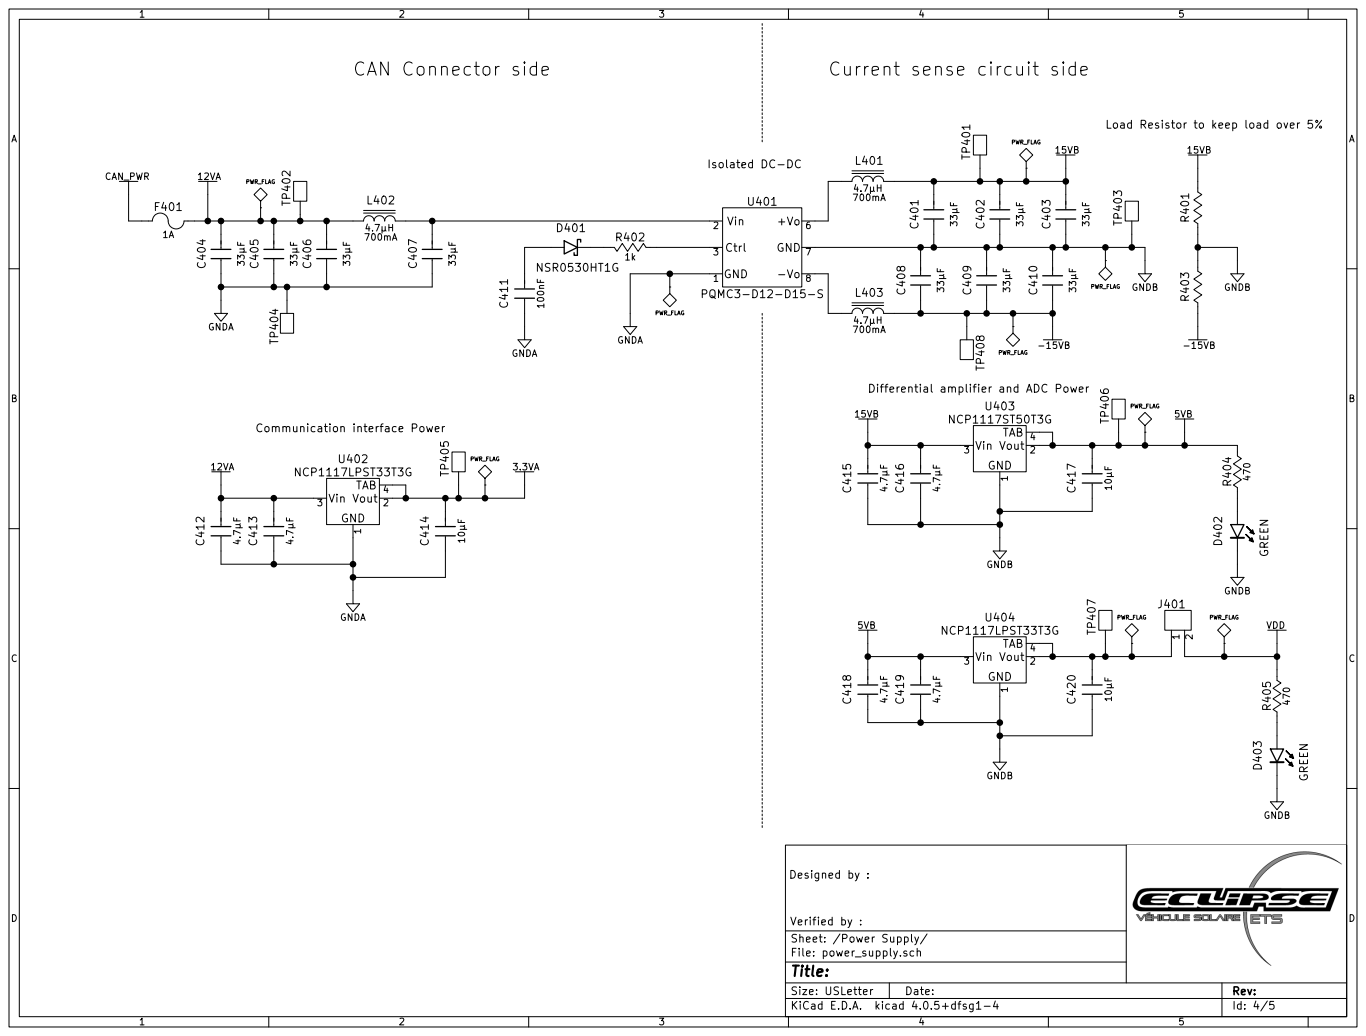
[picture p20: page 4]

-15VB GNDB Load Resistor to keep load over 5% TP401 TP402

Designed by : Verified by : | Rev:

D Date: KiCad E.D.A. kicad 4.0.5+dfsg1-4 Size: USLetter

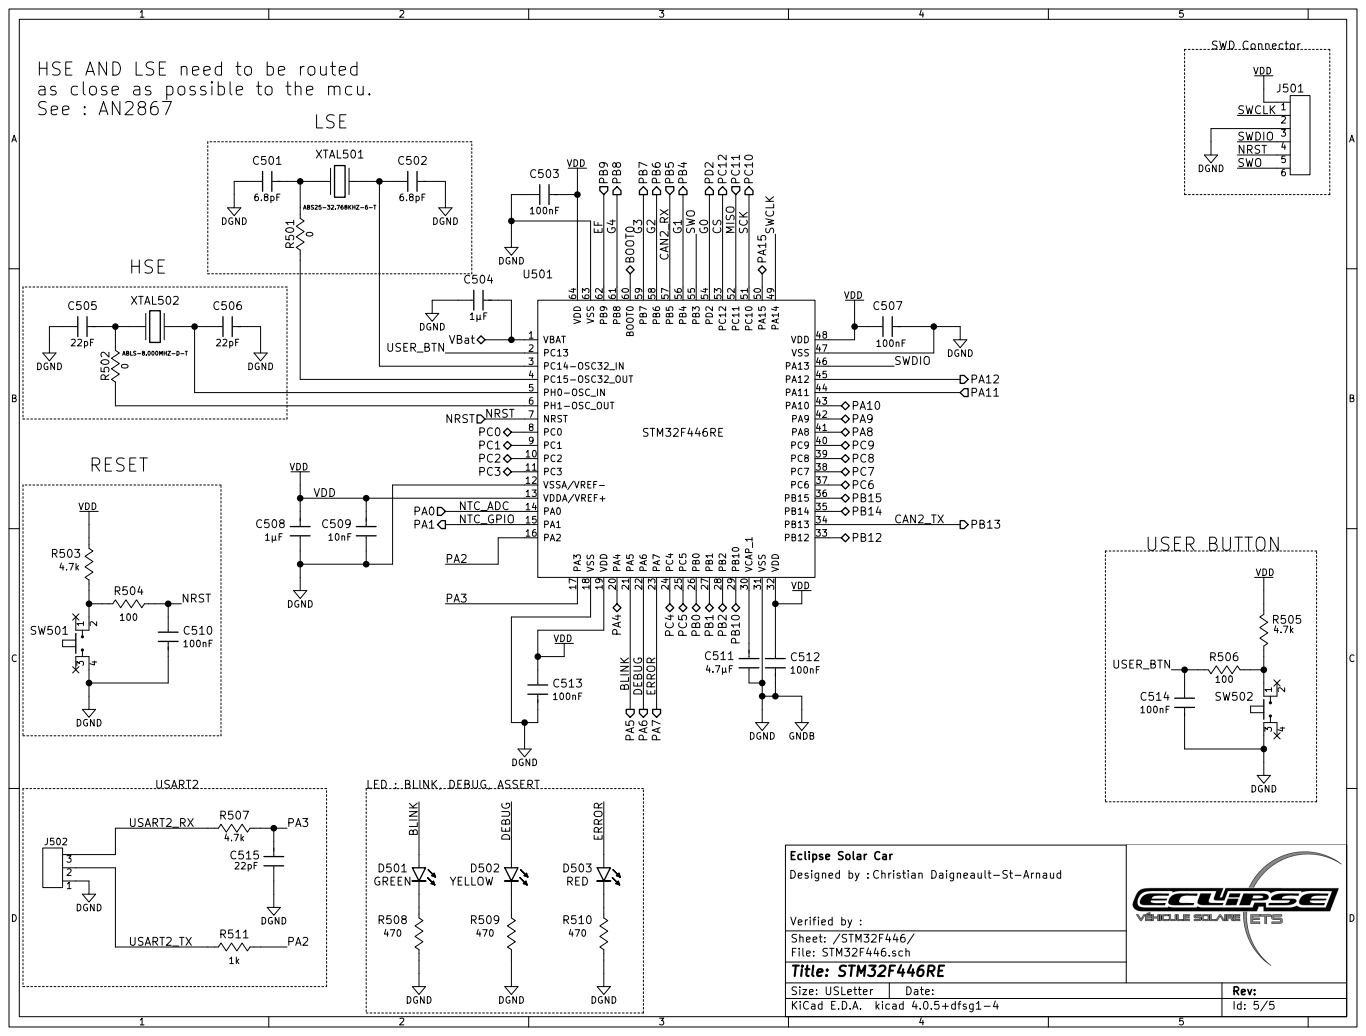
[picture p21: page 5]

HSE AND LSE need to be routed
as close as possible to the mcu.
See : AN2867

LED : BLINK, DEBUG, ASSERT

File: STM32F446.sch Sheet: /STM32F446/ Eclipse Solar Car
