EclipseETS/E10-BMS-HW/Master_Board/E10.1/V3/Documentation/Master_Board.pdf

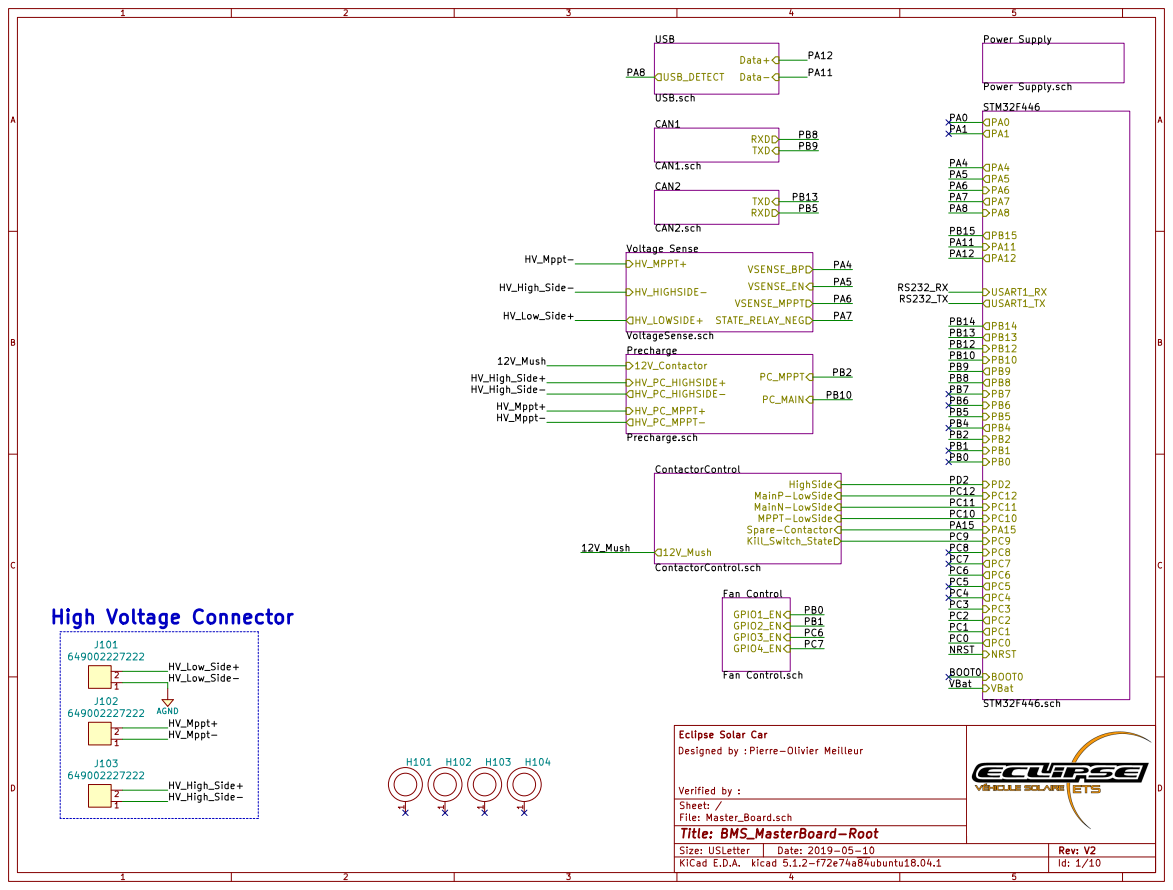
[picture p22: page 1]

File: Master_Board.sch Sheet: / Eclipse Solar Car

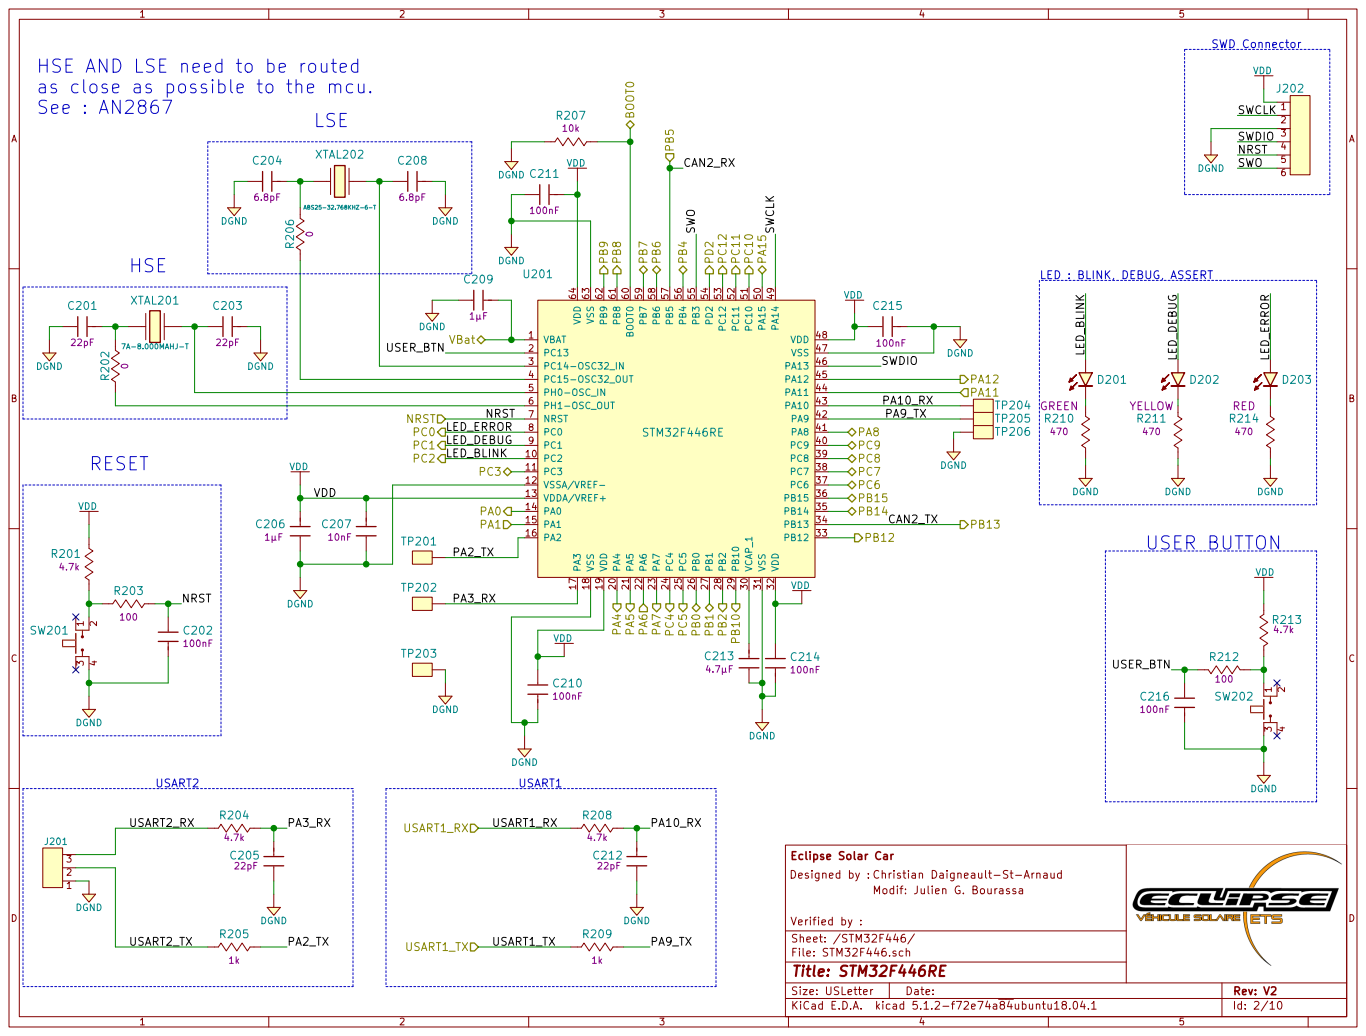
[picture p23: page 2]

HSE AND LSE need to be routed
as close as possible to the mcu.
See : AN2867

LED_ERROR
LED_DEBUG

File: STM32F446.sch Sheet: /STM32F446/ Eclipse Solar Car
Christian Daigneault-St-Arnaud Modif: Julien G. Bourassa Designed by :

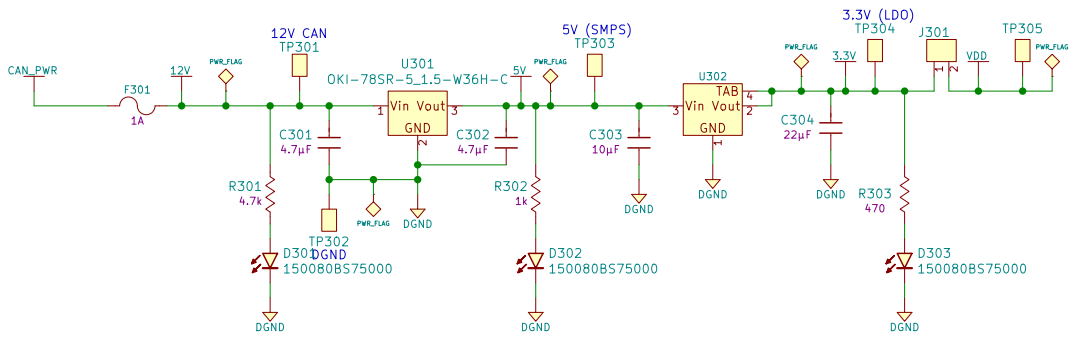
[picture p24: page 3]

Verified by : | Rev: V2

D Date: KiCad E.D.A. kicad 5.1.2-f72e74a84ubuntu18.04.1 Size: USLetter

Sheet: /Power Supply/
File: Power Supply.sch
Id: 3/10 Title: Power Supply

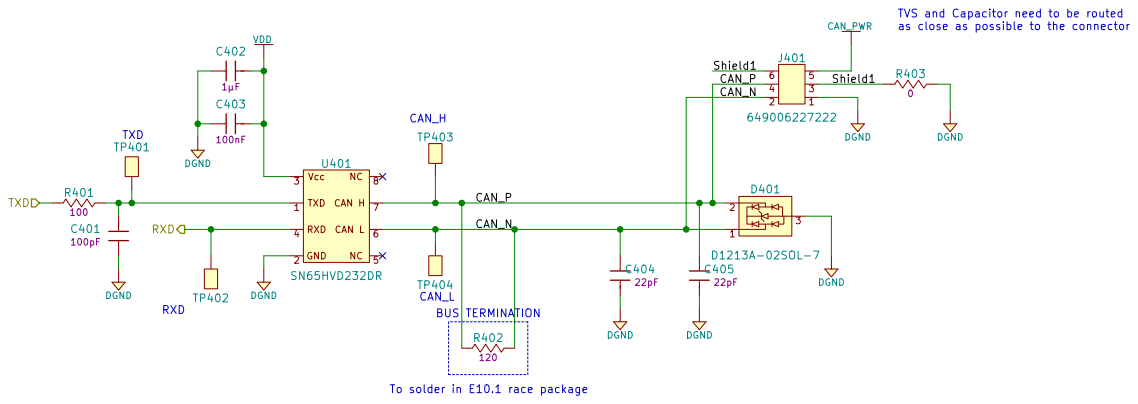
[picture p25: page 4]

as close as possible to the connector TP403 TP404 CAN_L

TVS and Capacitor need to be routed

120 CAN_P

7 | CAN_N | | 2

To solder in E10.1 race package

File: CAN1.sch Sheet: /CAN1/ Eclipse Solar Car
Christian Daigneault-St-Arnaud Modif: Julien G. Bourassa Designed by :

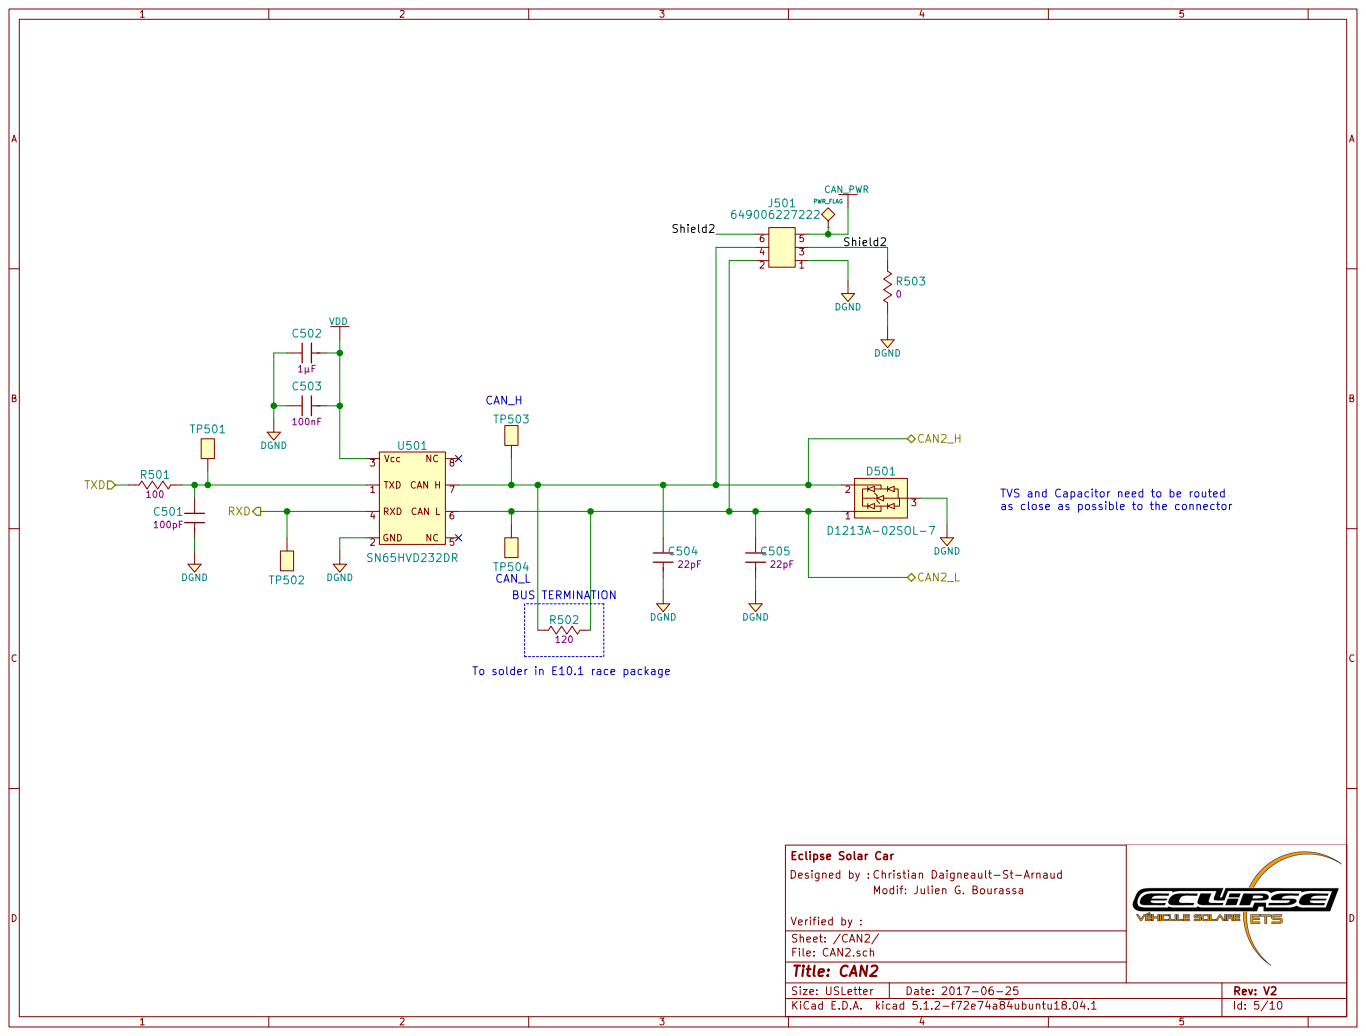
[picture p26: page 5]

CAN_H
as close as possible to the connector TP503 TP504 CAN_L

TVS and Capacitor need to be routed

To solder in E10.1 race package

File: CAN2.sch Sheet: /CAN2/ Eclipse Solar Car
Christian Daigneault-St-Arnaud Modif: Julien G. Bourassa Designed by :

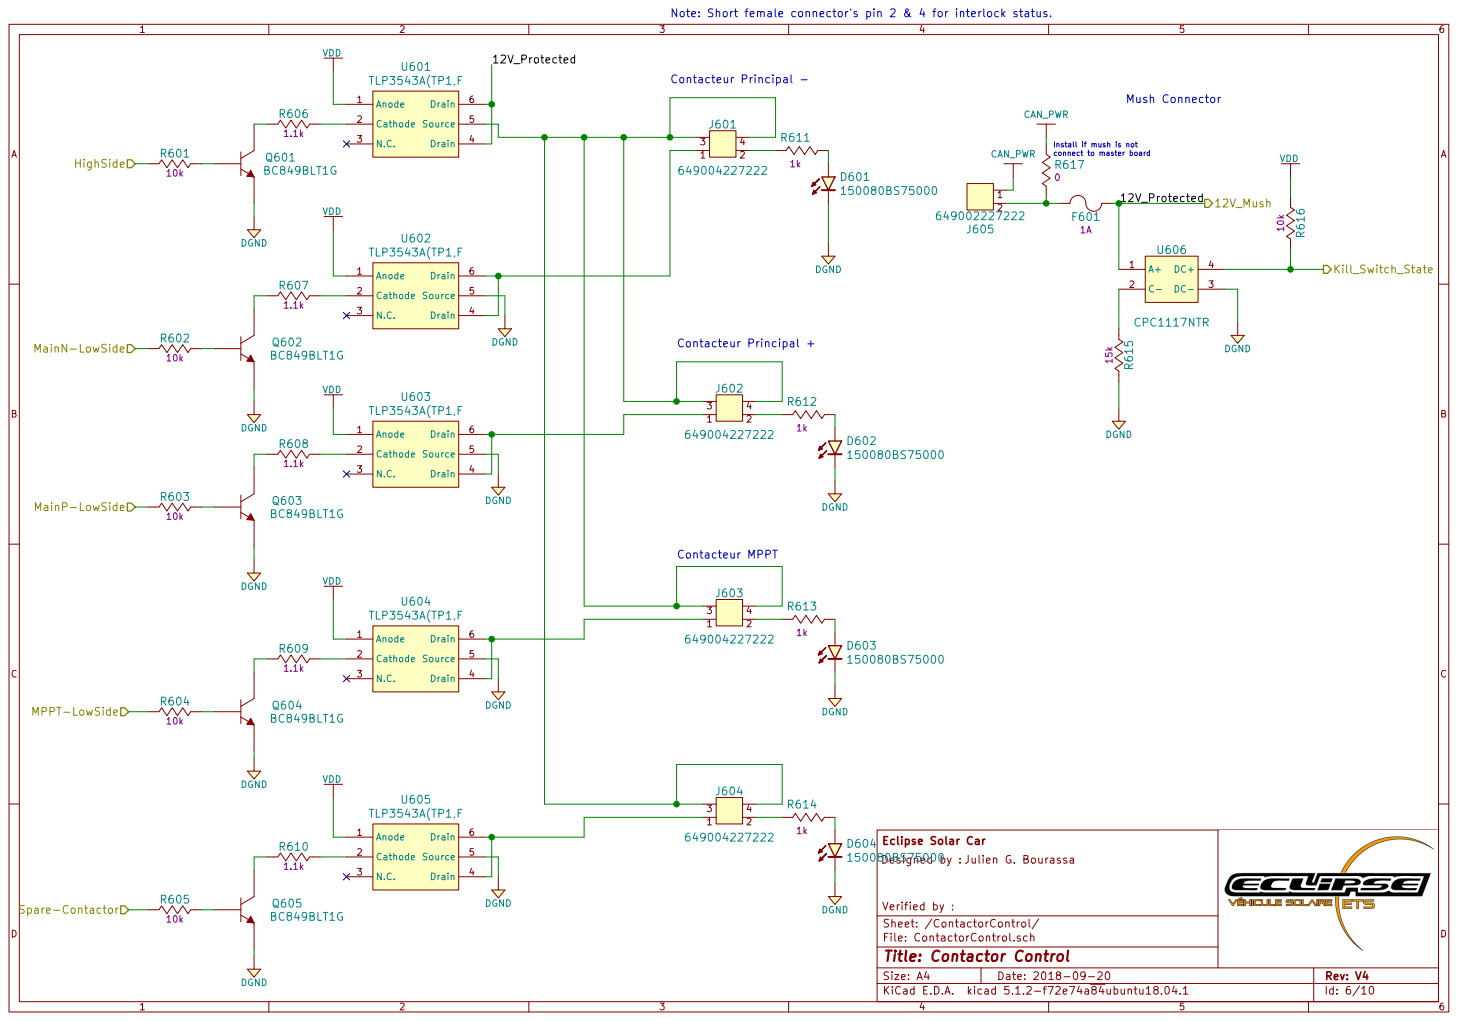
[picture p27: page 6]

Install if mush is not connect to master board

Id: 6/10 Title: Contactor Control File: ContactorControl.sch Sheet: /ContactorControl/ Eclipse Solar Car

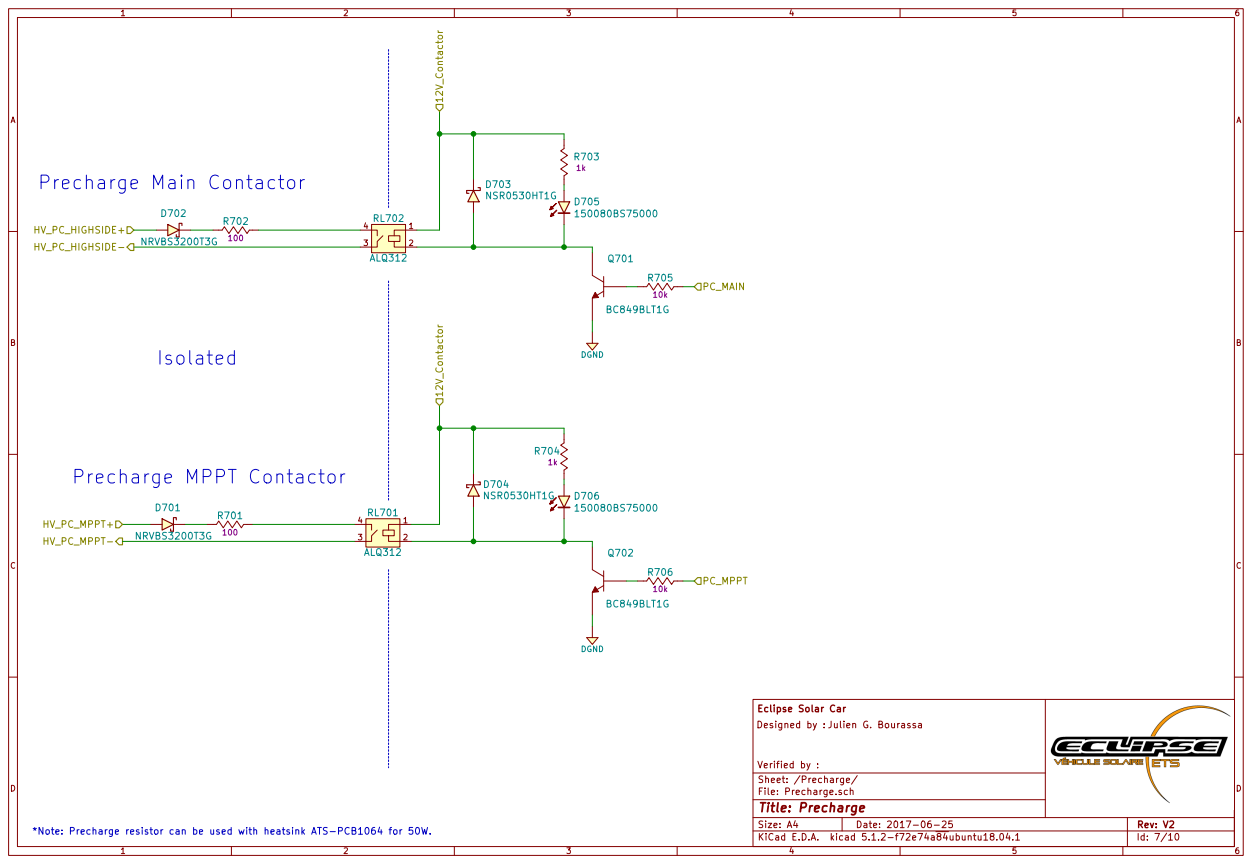
[picture p28: page 7]

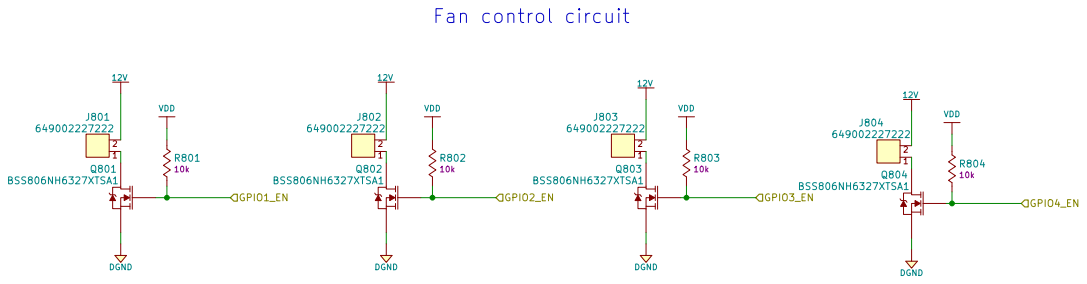
[picture p29: page 8]

Id: 8/10 Title: BMS_MasterBoard_Fan_Control File: Fan Control.sch Sheet: /Fan Control/ Eclipse Solar Car

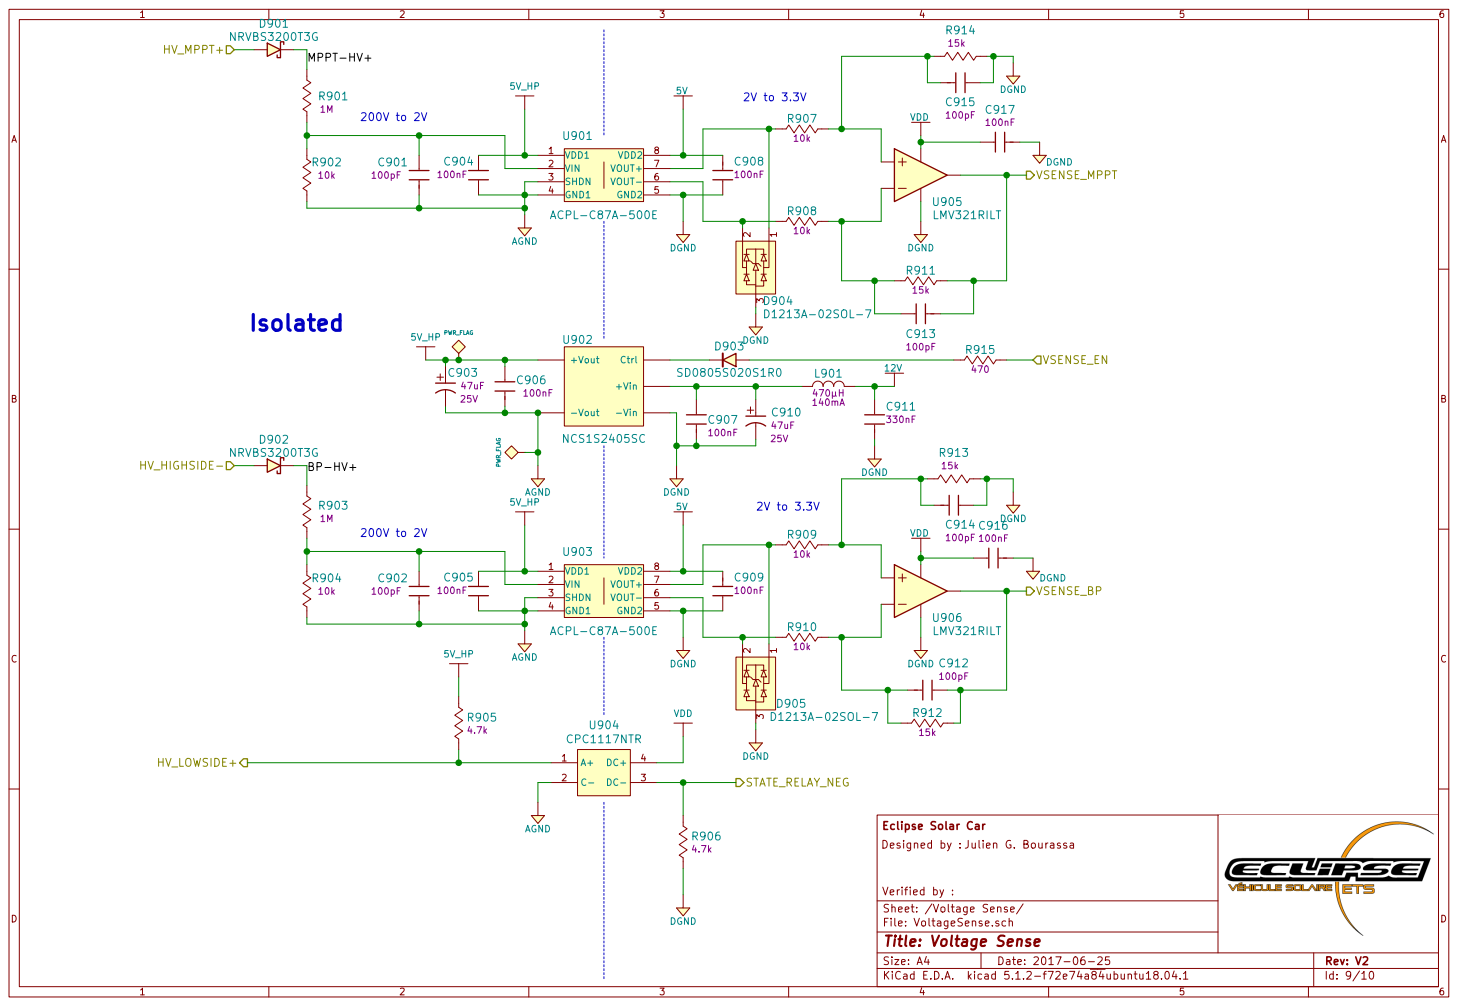
[picture p30: page 9]

Sheet: /Voltage Sense/
File: VoltageSense.sch
Id: 9/10 Title: Voltage Sense

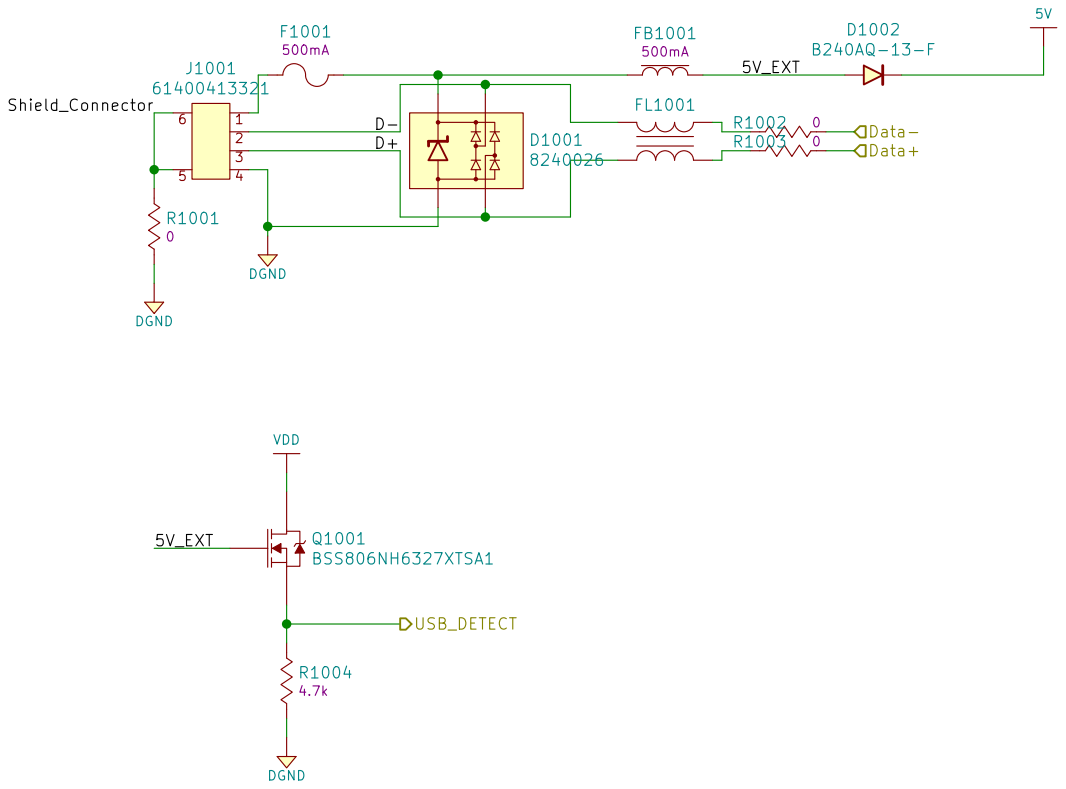
[picture p31: page 10]

Id: 10/10 Title: File: USB.sch Sheet: /USB/ Designed by :
