EclipseETS/E10-BMS-HW/Master_Board/E10/V1/Documentation/BMS_MasterBoard_Schematic_V1.pdf

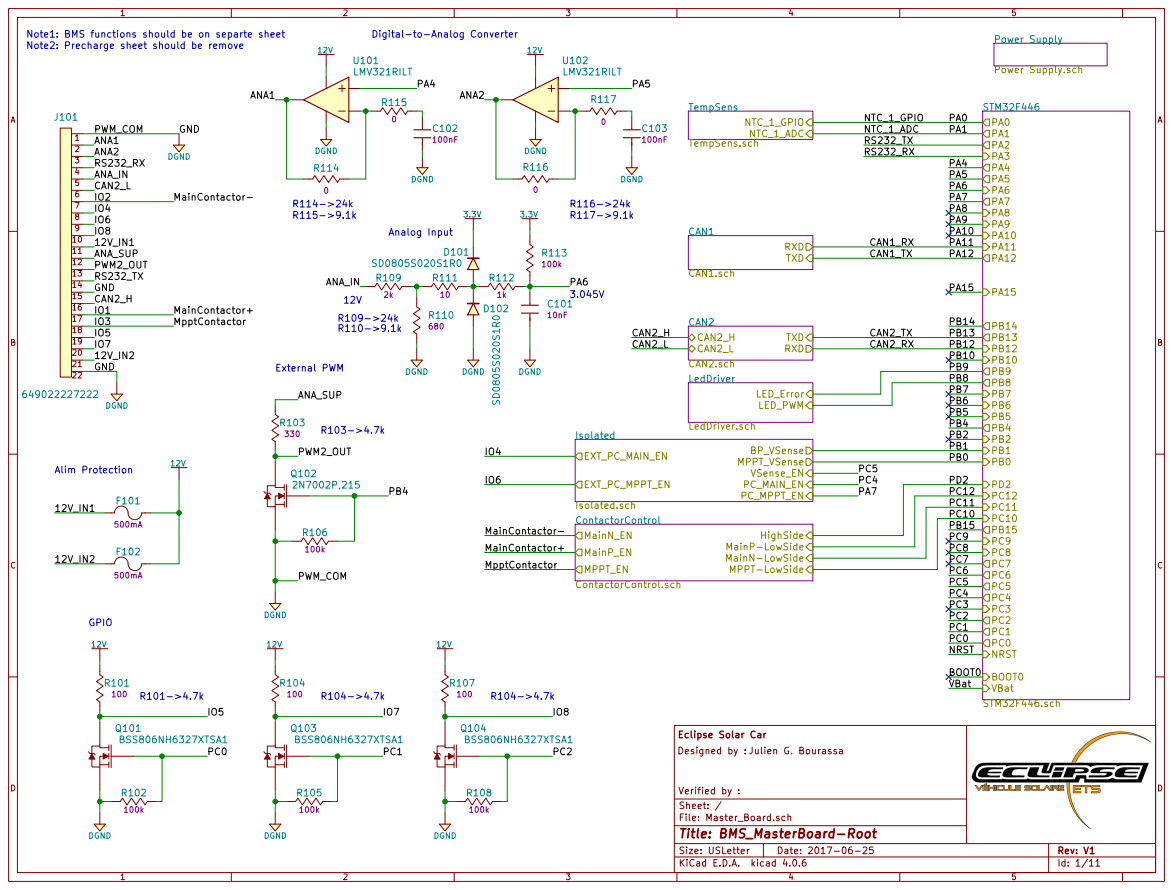
[picture p32: page 1]

Digital-to-Analog Converter

File: Master_Board.sch Sheet: / Eclipse Solar Car

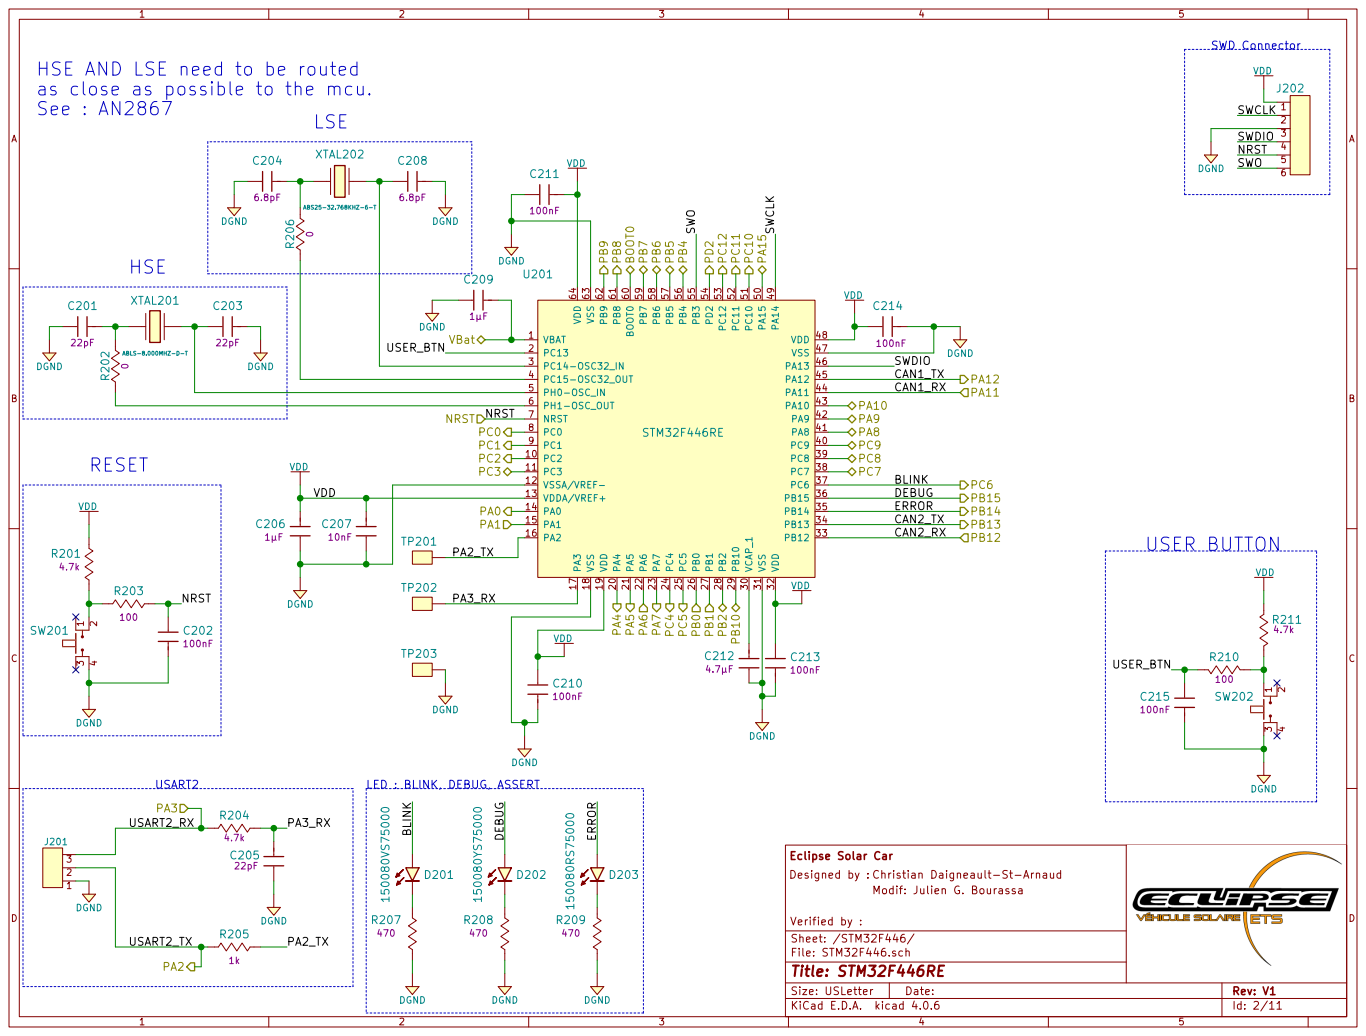
[picture p33: page 2]

HSE AND LSE need to be routed
as close as possible to the mcu.
See : AN2867

LED : BLINK, DEBUG, ASSERT

File: STM32F446.sch Sheet: /STM32F446/ Eclipse Solar Car
Christian Daigneault-St-Arnaud Modif: Julien G. Bourassa Designed by :

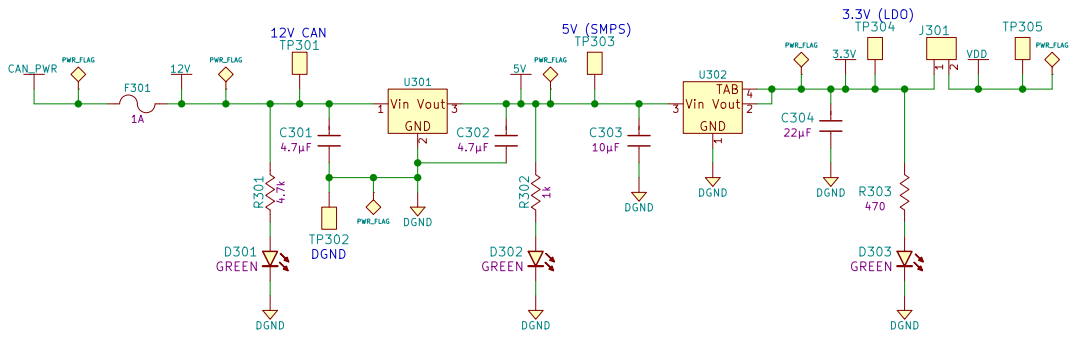
[picture p34: page 3]

Verified by : | Rev: V1

D Date: KiCad E.D.A. kicad 4.0.6 Size: USLetter

Sheet: /Power Supply/
File: Power Supply.sch
Id: 3/11 Title: Power Supply

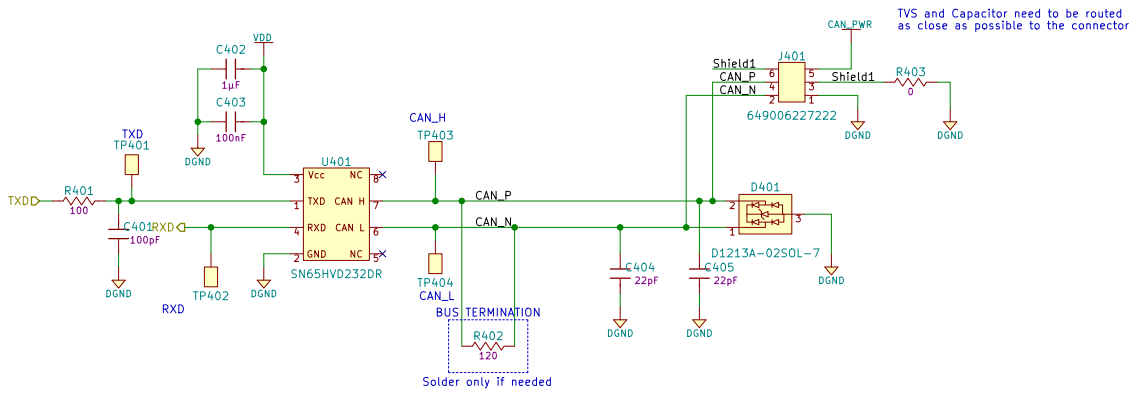
[picture p35: page 4]

TVS and Capacitor need to be routed

as close as possible to the connector TP403 TP404 CAN_L

120 CAN_P

7 | CAN_N | | 2

Solder only if needed

File: CAN1.sch Sheet: /CAN1/ Eclipse Solar Car
Christian Daigneault-St-Arnaud Modif: Julien G. Bourassa Designed by :

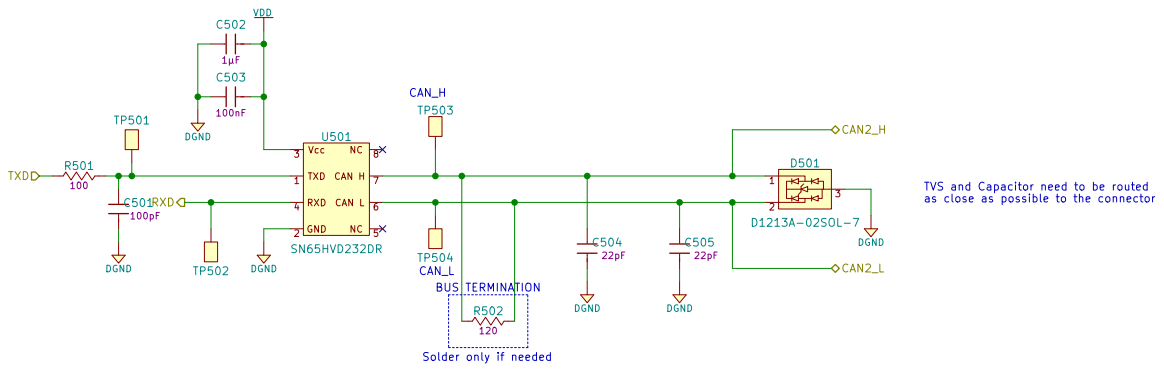
[picture p36: page 5]

CAN_H
as close as possible to the connector TP503 TP504 CAN_L

TVS and Capacitor need to be routed

Solder only if needed

File: CAN2.sch Sheet: /CAN2/ Eclipse Solar Car
Christian Daigneault-St-Arnaud Modif: Julien G. Bourassa Designed by :

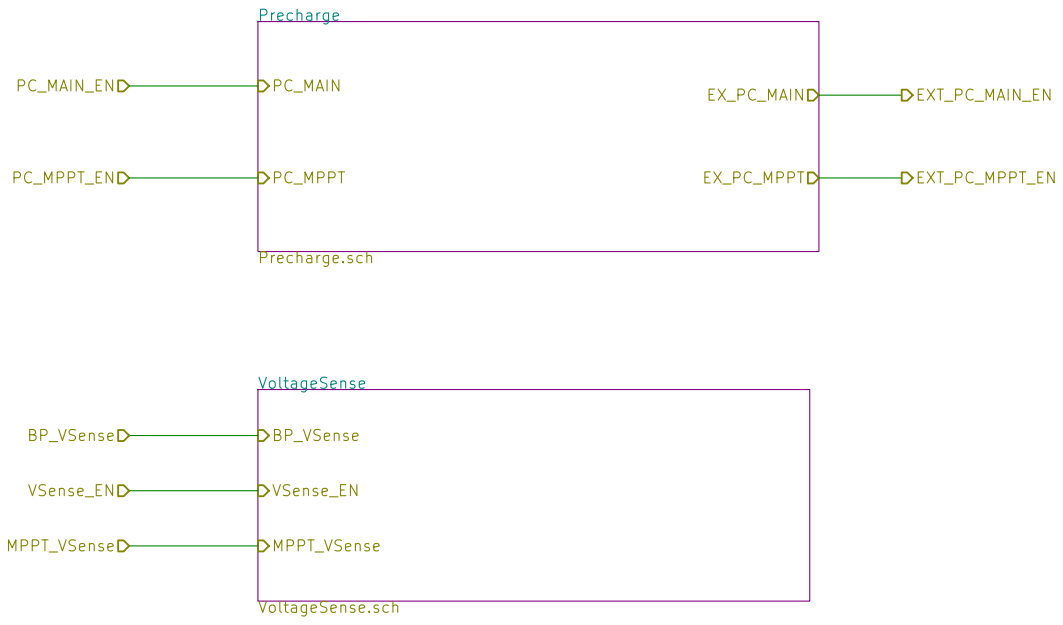
[picture p37: page 6]

File: Isolated.sch Sheet: /Isolated/ Eclipse Solar Car

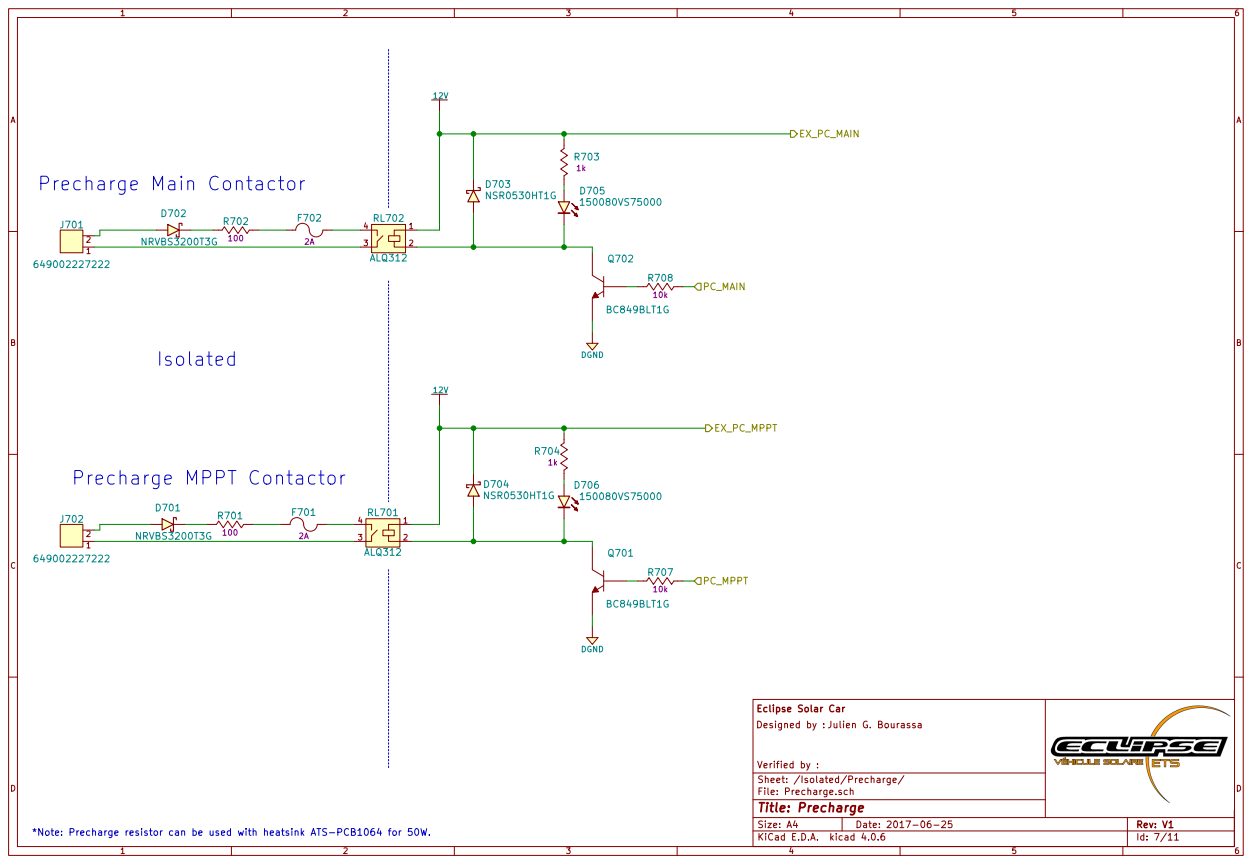
[picture p38: page 7]

*Note: Precharge resistor can be used with heatsink ATS-PCB1064 for 50W.

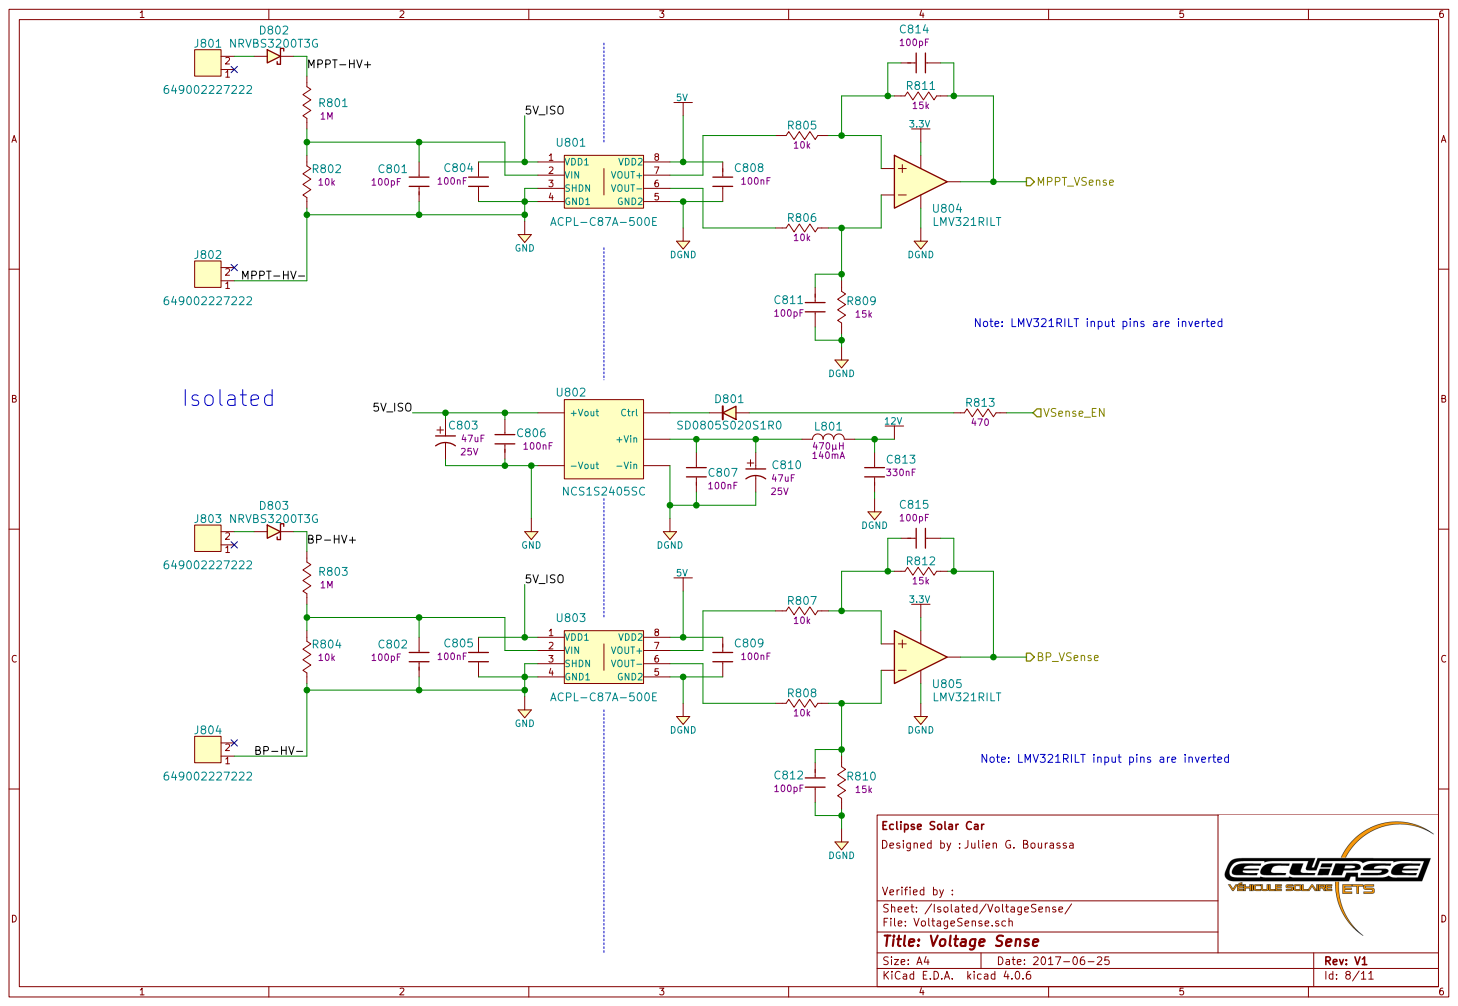
[picture p39: page 8]

Note: LMV321RILT input pins are inverted

Sheet: /Isolated/VoltageSense/
File: VoltageSense.sch
Id: 8/11 Title: Voltage Sense

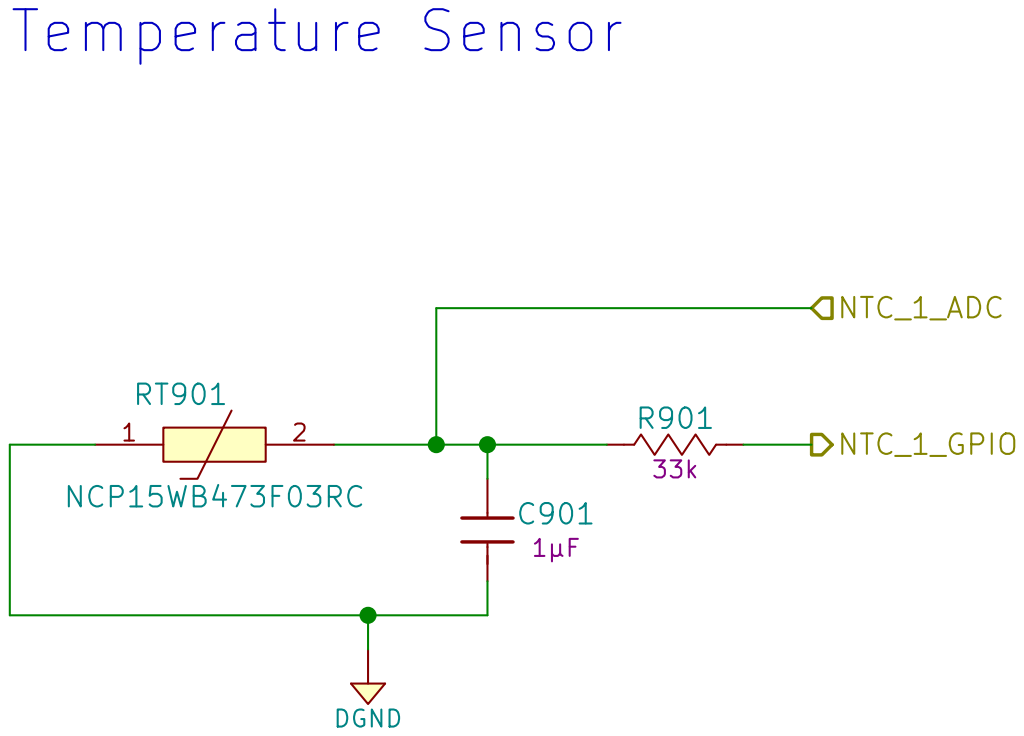
[picture p40: page 9]

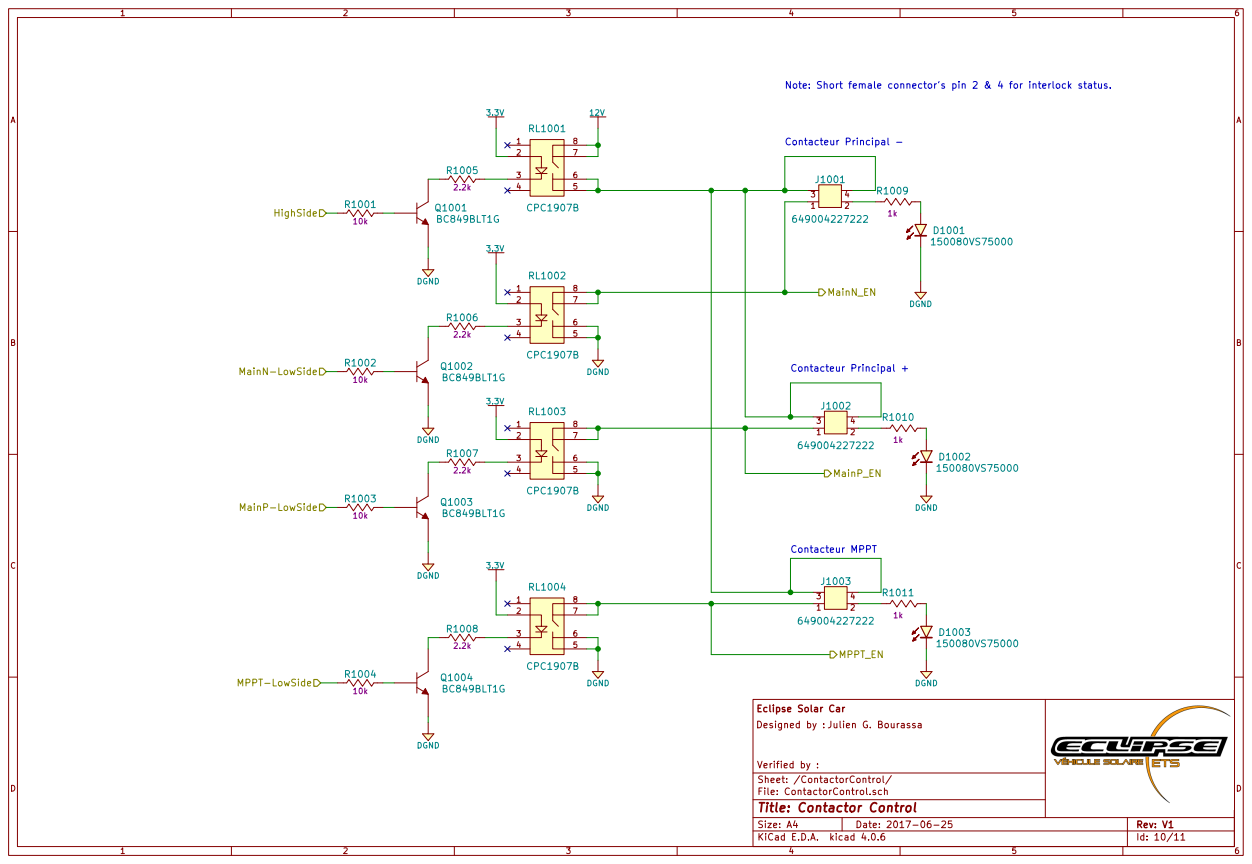
[picture p41: page 10]

Note: Short female connector's pin 2 & 4 for interlock status. 3.3V

Id: 10/11 Title: Contactor Control File: ContactorControl.sch Sheet: /ContactorControl/ Eclipse Solar Car

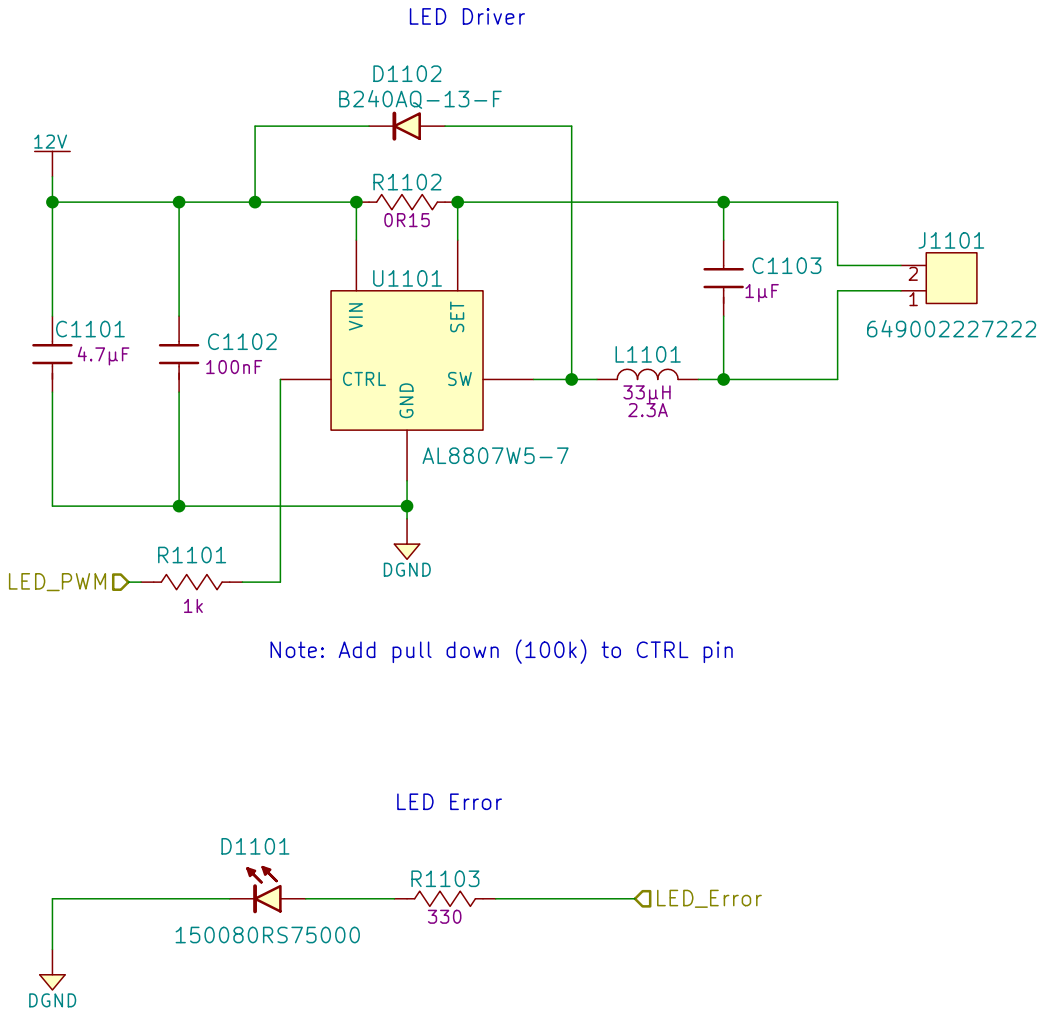
[picture p42: page 11]

Note: Add pull down (100k) to CTRL pin

Id: 11/11 Title: LED Driver File: LedDriver.sch Sheet: /LedDriver/ Eclipse Solar Car
