EclipseETS/E10-BMS-HW/Master_Board/E10.1/V3/Master_Board.kicad_pcb

## KiCad design Master_Board/E10.1/V3/Master_Board.kicad_pcb (2020-02-22)

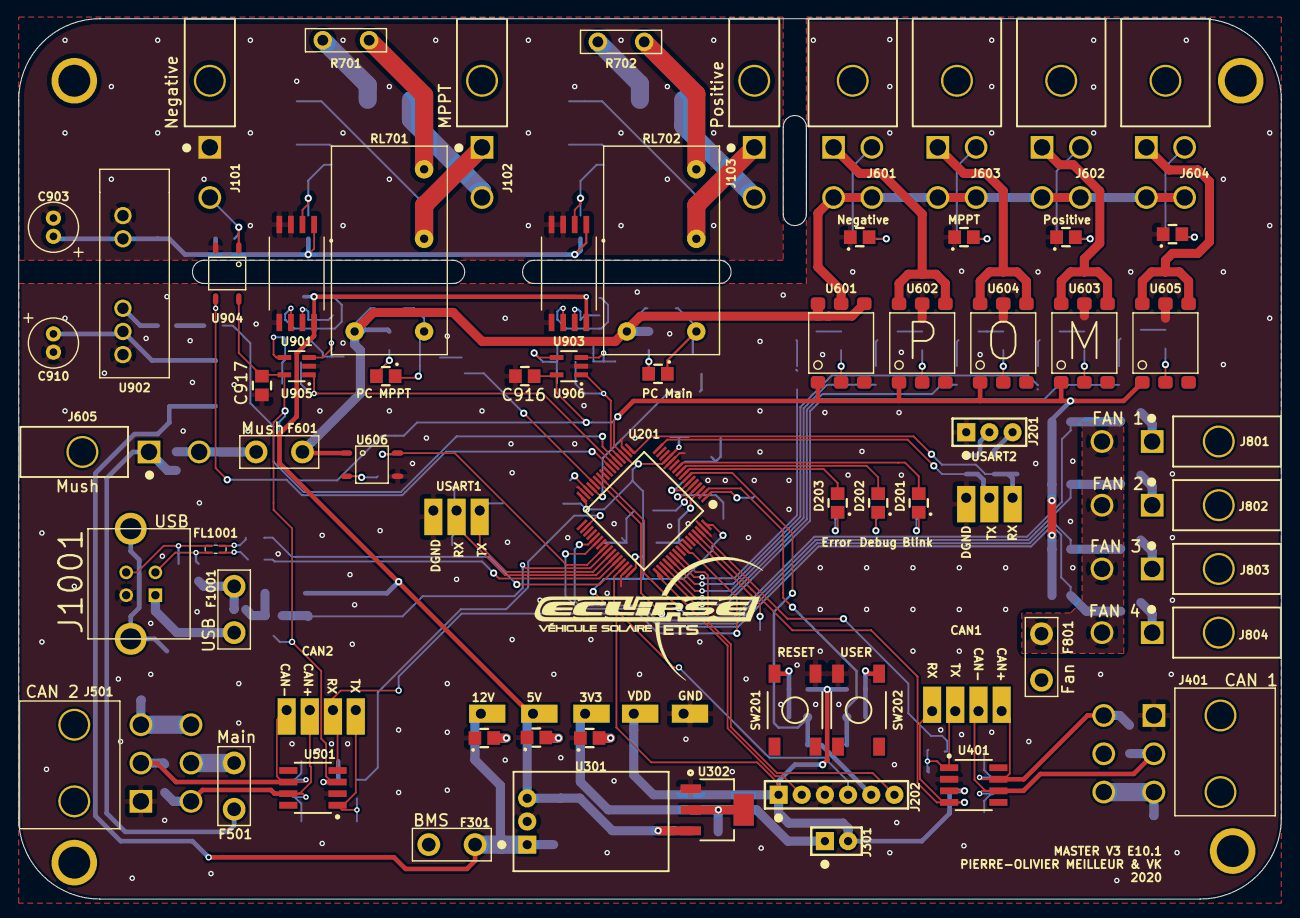
[picture p43: board Master_Board/E10.1/V3/Master_Board.kicad_pcb from above]

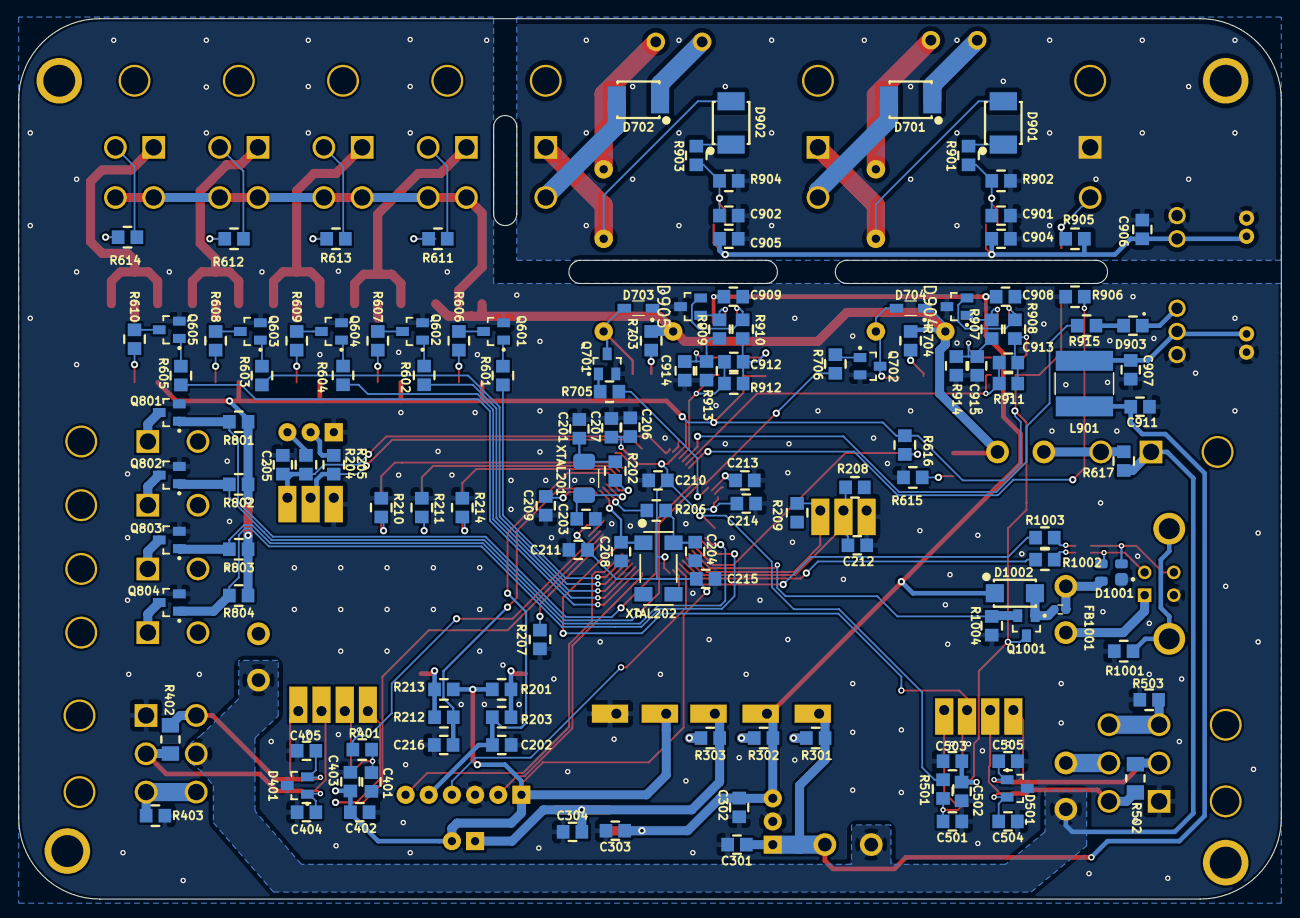
[picture p44: board Master_Board/E10.1/V3/Master_Board.kicad_pcb from below]

Board: 2 copper layers, 138.4 x 96.5 mm, 225 parts (139 on the bottom side), 145 nets.

Parts:
C201, C203, C205, C212, C404, C405, C504, C505: 885012007053; C0805
C202, C210, C211, C214, C215, C216, C403, C503, C904, C905, C906, C907, C908, C909, C916, C917: 885012207098; C0805
C204, C208: 885012007027; C0805
C206, C209, C402, C502: 885012107015; C0805
C207: 885012207092; C0805
C213, C301, C302: 885012107018; C0805
C303: 885012107014; C0805
C304: 885012107005; C0805
C401, C501, C901, C902, C912, C913, C914, C915: 885012207080; C0805
C903, C910: 860020472006; Radial-Can-5_11_2
C911: 885012207075; C0805
D201: 150080VS75000; LED_0805_GREEN
D202: 150080YS75000; LED_0805_YELLOW
D203: 150080RS75000; LED_0805_RED
D301, D302, D303, D601, D602, D603, D604, D705, D706: 150080BS75000; LED_0805_BLUE
D401, D501, D904, D905: D1213A-02SOL-7; SOT-23-3
D701, D702, D901, D902: NRVBS3200T3G; DO-214AA_SMB
D703, D704: NSR0530HT1G; SOD-323
D903: SD0805S020S1R0; Diode_0805
D1001: 8240026; SOT-143-4
D1002: B240AQ-13-F; DO-214AC_SMA
F301, F501, F601, F801: 39511000440; TE5_395
F1001: 39505000440; TE5_395
FB1001: 742792605; FB0603
FL1001: 744230900
H101, H102, H103, H104: Mounting-Hole-M3; Mounting_Hole_3mm
J101, J102, J103, J605, J801, J802, J803, J804: 649002227222
J201: Header_Male_Pin_2.54mm_1X3_,_Unshrouded; Headers_2.54mm_1X3
J202: Header_Male_Pin_2.54mm_1X6_,_Unshrouded; Headers_2.54mm_1X6
J301: Header_Male_Pin_2.54mm_1X2_,_Unshrouded; Headers_2.54mm_1X2
J401, J501: 649006227222
J601, J602, J603, J604: 649004227222
J1001: 61400413321
L901: 744052471; WE-TPC-SMD
Q601, Q602, Q603, Q604, Q605, Q701, Q702: BC849BLT1G; SOT-23-3
Q801, Q802, Q803, Q804, Q1001: BSS806NH6327XTSA1; SOT-23-3
R201, R204, R208, R213, R301, R905, R906, R1004: RC0805JR-074K7L; R0805
R202, R206, R403, R503, R1001, R1002, R1003: RC0805JR-070RL; R0805
R203, R212, R401, R501: RC0805JR-07100RL; R0805
R205, R209, R302, R611, R612, R613, R614, R703, R704: RC0805JR-071KL; R0805
R207, R601, R602, R603, R604, R605, R616, R705, R706, R801, R802, R803, R804, R902, R904, R907, R908, R909, R910: RC0805JR-0710KL; R0805
R210, R211, R214, R303, R915: RC0805JR-07470RL; R0805
R402, R502: RC1206JR-07120RL; R1206
R606, R607, R608, R609, R610: RC0805FR-071K1L; R0805
R615, R911, R912, R913, R914: RC0805JR-0715KL; R0805
R617: 0hms_0.5W; R0805
R701, R702: TR50JBC100R; TR50
R901, R903: RC0805JR-071ML; R0805
RL701, RL702: ALQ312
SW201, SW202: PTS645SM43SMTR92; PTS645_6X6X4_SMD
TP201, TP202, TP203, TP204, TP205, TP206, TP301, TP302, TP303, TP304, TP305, TP401, TP402, TP403, TP404, TP501, TP502, TP503, TP504: Test_Point_THM; Keystone_5001
U201: STM32F446RE; LQFP-64
U301: OKI-78SR-5_1.5-W36H-C; OKI-78SR_Horizontal
U302: AZ1117IH-3.3TRG1; SOT-223-3
U401, U501: SN65HVD232DR; SOIC-8
U601, U602, U603, U604, U605: TLP3543A(TP1,F; 6-SMD
U606, U904: CPC1117NTR; 4-SOP
U901, U903: ACPL-C87A-500E; SSO-8
U902: NCS1S2405SC
U905, U906: LMV321RILT; SOT-23-5
XTAL201: 7A-8.000MAHJ-T; TXC_7A_Series
XTAL202: ABS25-32.768KHZ-6-T; ABS25

Connections:
3.3V: C304.2, J301.1, R303.2, TP304.1, U302.2, U302.4
5V: C302.2, C303.2, C908.2, C909.2, D1002.1, R302.2, TP303.1, U301.3, U302.3, U901.8, U903.8
5V_HP: C903.1, C904.2, C905.2, C906.1, R905.1, U901.1, U902.6, U903.1
12V: C301.2, C911.1, F301.2, L901.2, R301.2, TP301.1, U301.1
/12V_Mush: D703.1, D704.1, F601.2, R703.1, R704.1, RL701.1, RL702.1, U601.4, U601.6, U606.1
/BOOT0: R207.2, U201.60
/CAN1/CAN_N: C404.1, D401.1, J401.2, R402.2, TP404.1, U401.6
/CAN1/CAN_P: C405.1, D401.2, J401.4, R402.1, TP403.1, U401.7
/CAN1/Shield1: J401.3, J401.6, R403.1
/CAN2/CAN2_H: C504.1, D501.2, J501.4, R502.1, TP503.1, U501.7
/CAN2/CAN2_L: C505.1, D501.1, J501.2, R502.2, TP504.1, U501.6
/CAN2/Shield2: J501.3, J501.6, R503.1
/Fan Control/12V_FANS: F801.2, J801.2, J802.2, J803.2, J804.2
/HV_High_Side+: D702.2, J103.2
/HV_High_Side-: D902.2, J103.1, RL702.3
/HV_Low_Side+: J101.2, R905.2, U904.1
/HV_Mppt+: D701.2, J102.2
/HV_Mppt-: D901.2, J102.1, RL701.3
/NRST: C202.1, J202.5, R203.2, U201.7
/PA4: C912.1, R912.2, U201.20, U906.1
/PA5: R915.2, U201.21
/PA6: C913.2, R911.2, U201.22, U905.1
/PA7: R906.1, U201.23, U904.3
/PA8: Q1001.2, R1004.1, U201.41
/PA11: R1002.2, U201.44
/PA12: R1003.2, U201.45
/PA15: R605.1, U201.50
/PB0: Q801.1, R801.2, U201.26
/PB1: Q802.1, R802.2, U201.27
/PB2: R706.2, U201.28
/PB5: TP502.1, U201.57, U501.4
/PB8: TP402.1, U201.61, U401.4
/PB9: R401.1, U201.62
/PB10: R705.2, U201.29
/PB13: R501.1, U201.34
/PC0: D203.2, U201.8
/PC1: D202.2, U201.9
/PC2: D201.2, U201.10
/PC6: Q803.1, R803.2, U201.37
/PC7: Q804.1, R804.2, U201.38
/PC9: R616.2, U201.40, U606.4
/PC10: R604.1, U201.51
/PC11: R602.1, U201.52
/PC12: R603.1, U201.53
/PD2: R601.1, U201.54
/STM32F446/PA2_TX: R205.2, TP201.1, U201.16
/STM32F446/PA3_RX: C205.2, R204.2, TP202.1, U201.17
/STM32F446/PA9_TX: R209.2, TP205.1, U201.42
/STM32F446/PA10_RX: C212.2, R208.2, TP204.1, U201.43
/STM32F446/SWCLK: J202.2, U201.49
/STM32F446/SWDIO: J202.4, U201.46
/STM32F446/SWO: J202.6, U201.55
/STM32F446/USART2_RX: J201.3, R204.1
/STM32F446/USART2_TX: J201.2, R205.1
/STM32F446/USER_BTN: C216.1, R212.2, U201.2
/USB/5V_EXT: D1002.2, FB1001.2, Q1001.1
/USB/D+: D1001.2, FL1001.1, J1001.3
/USB/D-: D1001.3, FL1001.4, J1001.2
/USB/Shield_Connector: J1001.5, J1001.6, R1001.1
/VBat: C209.2, U201.1
/Voltage Sense/BP-HV+: D902.1, R903.1
/Voltage Sense/MPPT-HV+: D901.1, R901.1
AGND: C901.2, C902.2, C903.2, C904.1, C905.1, C906.2, J101.1, R902.2, R904.2, U901.3, U901.4, U902.7, U903.3, U903.4, U904.2
CAN_PWR: F301.1, F501.2, F801.1, J401.5, J605.1, R617.1
DGND: C201.1, C202.2, C203.2, C204.1, C205.1, C206.1, C207.1, C208.2, C209.1, C210.2, C211.1, C212.1, C213.1, C214.2, C215.2, C216.2, C301.1, C302.1, C303.1, C304.1, C401.1, C402.1, C403.1, C404.2, C405.2, C501.2, C502.1, C503.1, C504.2, C505.2, C907.2, C908.1, C909.1, C910.2, C911.2, C914.1, C915.1, C916.2, C917.2, D301.1, D302.1, D303.1, D401.3, D501.3, D601.1, D602.1, D603.1, D604.1, D904.3, D905.3, D1001.1, J201.1, J202.3, J401.1, J501.1, J1001.4, Q601.2, Q602.2, Q603.2, Q604.2, Q605.2, Q701.2, Q702.2, Q801.2, Q802.2, Q803.2, Q804.2, R207.1, R210.1, R211.1, R214.1, R403.2, R503.2, R615.2, R906.2, R913.2, R914.2, R1001.2, R1004.2, SW201.4, SW202.3, TP203.1, TP206.1, TP302.1, U201.12, U201.18, U201.31, U201.47, U201.63, U301.2, U302.1, U401.2, U501.2, U602.5, U603.5, U604.5, U605.5, U606.3, U901.5, U902.1, U903.5, U905.2, U906.2
unnamed: C201.2, R202.2, XTAL201.1
unnamed: C203.1, U201.5, XTAL201.2
unnamed: C204.2, R206.2, XTAL202.4
unnamed: C208.1, U201.3, XTAL202.1
unnamed: C213.2, U201.30
unnamed: C401.2, R401.2, TP401.1, U401.1
unnamed: C501.1, R501.2, TP501.1, U501.1
unnamed: C901.1, R901.2, R902.1, U901.2
unnamed: C902.1, R903.2, R904.1, U903.2
unnamed: C907.1, C910.1, L901.1, U902.2
unnamed: C912.2, R910.2, R912.1, U906.4
unnamed: C913.1, R908.2, R911.1, U905.4
unnamed: C914.2, R909.2, R913.1, U906.3
unnamed: C915.2, R907.2, R914.1, U905.3
unnamed: D201.1, R210.2
unnamed: D202.1, R211.2
unnamed: D203.1, R214.2
unnamed: D301.2, R301.1
unnamed: D302.2, R302.1
unnamed: D303.2, R303.1
unnamed: D601.2, R611.2
unnamed: D602.2, R612.2
unnamed: D603.2, R613.2
unnamed: D604.2, R614.2
unnamed: D701.1, R701.1
unnamed: D702.1, R702.1
unnamed: D703.2, D705.1, Q701.3, RL702.2
unnamed: D704.2, D706.1, Q702.3, RL701.2
unnamed: D705.2, R703.2
unnamed: D706.2, R704.2
unnamed: D903.1, U902.3
unnamed: D903.2, R915.1
unnamed: D904.1, R907.1, U901.7
unnamed: D904.2, R908.1, U901.6
unnamed: D905.1, R909.1, U903.7
unnamed: D905.2, R910.1, U903.6
unnamed: D1001.4, F1001.2, FB1001.1
unnamed: F501.1, J501.5
unnamed: F601.1, J605.2, R617.2
unnamed: F1001.1, J1001.1
unnamed: FL1001.2, R1003.1
unnamed: FL1001.3, R1002.1
unnamed: J601.1, U602.4, U602.6
unnamed: J601.2, R611.1
unnamed: J601.3, J601.4, J602.3, J602.4, J603.3, J603.4, J604.3, J604.4, U601.5
unnamed: J602.1, U603.4, U603.6
unnamed: J602.2, R612.1
unnamed: J603.1, U604.4, U604.6
unnamed: J603.2, R613.1
unnamed: J604.1, U605.4, U605.6
unnamed: J604.2, R614.1
unnamed: J801.1, Q801.3
unnamed: J802.1, Q802.3
unnamed: J803.1, Q803.3
unnamed: J804.1, Q804.3
unnamed: Q601.1, R601.2
unnamed: Q601.3, R606.1
unnamed: Q602.1, R602.2
unnamed: Q602.3, R607.1
unnamed: Q603.1, R603.2
unnamed: Q603.3, R608.1
unnamed: Q604.1, R604.2
unnamed: Q604.3, R609.1
unnamed: Q605.1, R605.2
unnamed: Q605.3, R610.1
unnamed: Q701.1, R705.1
unnamed: Q702.1, R706.1
unnamed: R201.1, R203.1, SW201.2
unnamed: R202.1, U201.6
unnamed: R206.1, U201.4
unnamed: R212.1, R213.1, SW202.1
unnamed: R606.2, U601.2
unnamed: R607.2, U602.2
unnamed: R608.2, U603.2
unnamed: R609.2, U604.2
unnamed: R610.2, U605.2
unnamed: R615.1, U606.2
unnamed: R701.2, RL701.4
unnamed: R702.2, RL702.4
VDD: C206.2, C207.2, C210.1, C211.2, C214.1, C215.1, C402.2, C403.2, C502.2, C503.2, C916.1, C917.1, J202.1, J301.2, Q1001.3, R201.2, R213.2, R616.1, R801.1, R802.1, R803.1, R804.1, TP305.1, U201.13, U201.19, U201.32, U201.48, U201.64, U401.3, U501.3, U601.1, U602.1, U603.1, U604.1, U605.1, U904.4, U905.5, U906.5
