EclipseETS/E10-BMS-HW/Slave/V1/Slave.kicad_pcb

## KiCad design Slave/V1/Slave.kicad_pcb (2019-04-20)

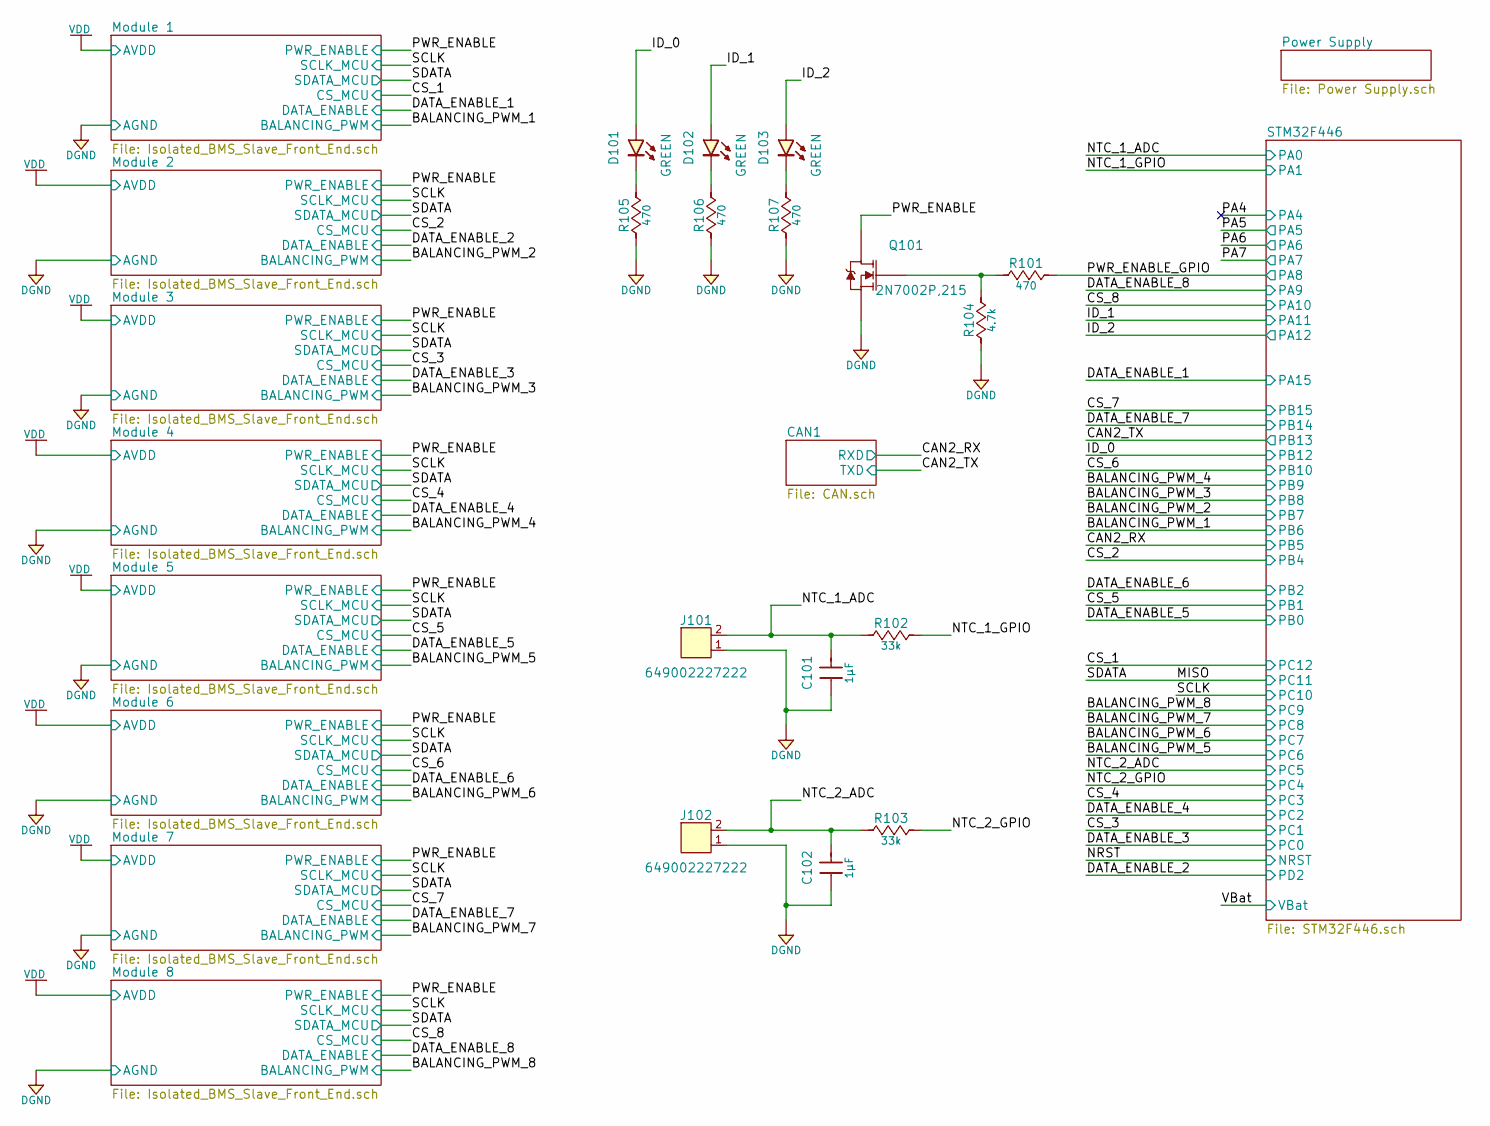
[picture p45: schematic Slave.sch]

Parts:
C101, C102: 885012107015; C0805; Tolerance (%) ±20%; Voltage Rated (Volt) 25V; Manufacturer Part Number 885012107015
D101, D102, D103: 150080VS75000; LED_0805_GREEN; Voltage - Forward (Vf) 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 2V; Manufacturer Part Number 150080VS75000
J101, J102: 649002227222; Manufacturer Part Number 649002227222
Q101: 2N7002P,215; SOT-23-3; Manufacturer Part Number 2N7002P,215
R101, R105, R106, R107: RC0805JR-07470RL; R0805; Tolerance (%) ±5%; Manufacturer Part Number RC0805JR-07470RL
R102, R103: RC0805JR-0733KL; R0805; Tolerance (%) ±5%; Manufacturer Part Number RC0805JR-0733KL
R104: RC0805JR-074K7L; R0805; Tolerance (%) ±5%; Manufacturer Part Number RC0805JR-074K7L

Connections:
/ID_0: D101.2 (Anode); also elsewhere on the board
/ID_1: D102.2 (Anode); also elsewhere on the board
/ID_2: D103.2 (Anode); also elsewhere on the board
/NTC_1_ADC: C101.2, J101.2, R102.1; also elsewhere on the board
/NTC_1_GPIO: R102.2; also elsewhere on the board
/NTC_2_ADC: C102.2, J102.2, R103.1; also elsewhere on the board
/NTC_2_GPIO: R103.2; also elsewhere on the board
/PWR_ENABLE: Q101.3 (D); also elsewhere on the board
/PWR_ENABLE_GPIO: R101.2; also elsewhere on the board
DGND: C101.1, C102.1, J101.1, J102.1, Q101.2 (S), R104.1, R105.1, R106.1, R107.1; also elsewhere on the board
unnamed: D101.1 (Cathode), R105.2
unnamed: D102.1 (Cathode), R106.2
unnamed: D103.1 (Cathode), R107.2
unnamed: Q101.1 (G), R101.1, R104.2

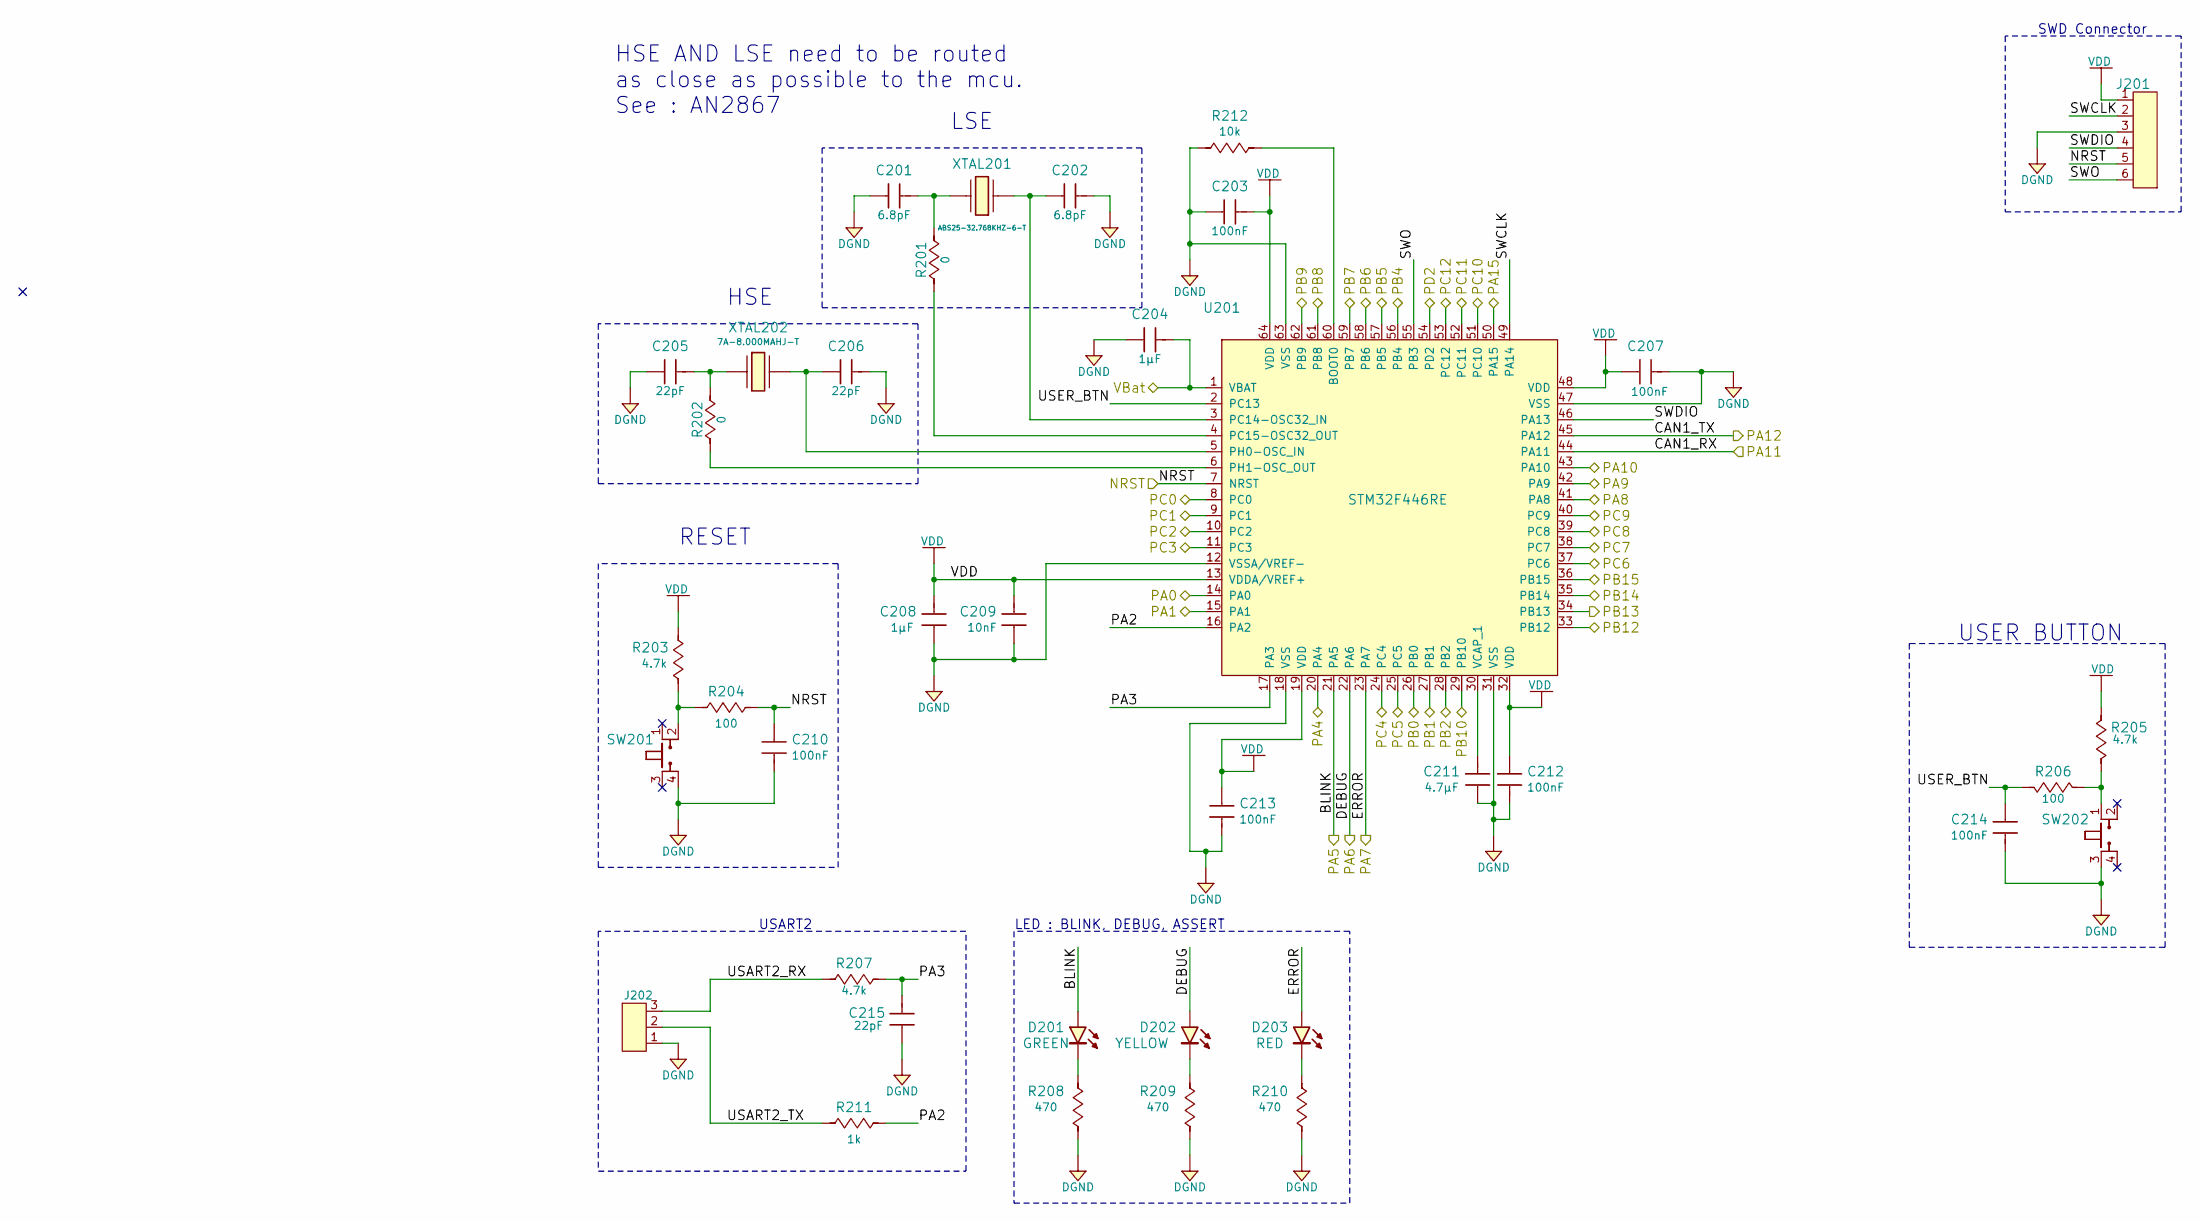
[picture p46: schematic STM32F446.sch, STM32F446RE]

Parts:
C201, C202: 885012007027; C0805; Tolerance (%) ±0.5pF; Voltage Rated (Volt) 25V; Manufacturer Part Number 885012007027
C203, C207, C210, C212, C213, C214: 885012207098; C0805; Tolerance (%) ±10%; Voltage Rated (Volt) 50V; Manufacturer Part Number 885012207098
C204, C208: 885012107015; C0805; Tolerance (%) ±20%; Voltage Rated (Volt) 25V; Manufacturer Part Number 885012107015
C205, C206, C215: 885012007053; C0805; Tolerance (%) ±5%; Voltage Rated (Volt) 50V; Manufacturer Part Number 885012007053
C209: 885012207092; C0805; Tolerance (%) ±10%; Voltage Rated (Volt) 50V; Manufacturer Part Number 885012207092
C211: 885012107018; C0805; Tolerance (%) ±20%; Voltage Rated (Volt) 25V; Manufacturer Part Number 885012107018
D201: 150080VS75000; LED_0805_GREEN; Voltage - Forward (Vf) 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 2V; Manufacturer Part Number 150080VS75000
D202: 150080YS75000; LED_0805_YELLOW; Voltage - Forward (Vf) 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 2V; Manufacturer Part Number 150080YS75000
D203: 150080RS75000; LED_0805_RED; Voltage - Forward (Vf) 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 2V; Manufacturer Part Number 150080RS75000
J201: Header_Male_Pin_2.54mm_1X6_,_Unshrouded; Headers_2.54mm_1X6; Manufacturer Part Number Manufacturer Part Number
J202: Header_Male_Pin_2.54mm_1X3_,_Unshrouded; Headers_2.54mm_1X3; Manufacturer Part Number Manufacturer Part Number
R201, R202: RC0805JR-070RL; R0805; Tolerance (%) 0; Manufacturer Part Number RC0805JR-070RL
R203, R205, R207: RC0805JR-074K7L; R0805; Tolerance (%) ±5%; Manufacturer Part Number RC0805JR-074K7L
R204, R206: RC0805JR-07100RL; R0805; Tolerance (%) ±5%; Manufacturer Part Number RC0805JR-07100RL
R208, R209, R210: RC0805JR-07470RL; R0805; Tolerance (%) ±5%; Manufacturer Part Number RC0805JR-07470RL
R211: RC0805JR-071KL; R0805; Tolerance (%) ±5%; Manufacturer Part Number RC0805JR-071KL
R212: RC0805JR-0710KL; R0805; Tolerance (%) ±5%; Manufacturer Part Number RC0805JR-0710KL
SW201, SW202: PTS645SM43SMTR92; PTS645_6X6X4_SMD; Manufacturer Part Number PTS645SM43SMTR92 LFS
U201: STM32F446RE; LQFP-64; Manufacturer Part Number STM32F446RET6
XTAL201: ABS25-32.768KHZ-6-T; ABS25; Manufacturer Part Number ABS25-32.768KHZ-6-T
XTAL202: 7A-8.000MAHJ-T; TXC_7A_Series; Manufacturer Part Number ABLS-8.000MHZ-D-T

Connections:
/BALANCING_PWM_1: U201.58 (PB6); also elsewhere on the board
/BALANCING_PWM_2: U201.59 (PB7); also elsewhere on the board
/BALANCING_PWM_3: U201.61 (PB8); also elsewhere on the board
/BALANCING_PWM_4: U201.62 (PB9); also elsewhere on the board
/BALANCING_PWM_5: U201.37 (PC6); also elsewhere on the board
/BALANCING_PWM_6: U201.38 (PC7); also elsewhere on the board
/BALANCING_PWM_7: U201.39 (PC8); also elsewhere on the board
/BALANCING_PWM_8: U201.40 (PC9); also elsewhere on the board
/CAN2_RX: U201.57 (PB5); also elsewhere on the board
/CAN2_TX: U201.34 (PB13); also elsewhere on the board
/CS_1: U201.53 (PC12); also elsewhere on the board
/CS_2: U201.56 (PB4); also elsewhere on the board
/CS_3: U201.9 (PC1); also elsewhere on the board
/CS_4: U201.11 (PC3); also elsewhere on the board
/CS_5: U201.27 (PB1); also elsewhere on the board
/CS_6: U201.29 (PB10); also elsewhere on the board
/CS_7: U201.36 (PB15); also elsewhere on the board
/CS_8: U201.43 (PA10); also elsewhere on the board
/DATA_ENABLE_1: U201.50 (PA15); also elsewhere on the board
/DATA_ENABLE_2: U201.54 (PD2); also elsewhere on the board
/DATA_ENABLE_3: U201.8 (PC0); also elsewhere on the board
/DATA_ENABLE_4: U201.10 (PC2); also elsewhere on the board
/DATA_ENABLE_5: U201.26 (PB0); also elsewhere on the board
/DATA_ENABLE_6: U201.28 (PB2); also elsewhere on the board
/DATA_ENABLE_7: U201.35 (PB14); also elsewhere on the board
/DATA_ENABLE_8: U201.42 (PA9); also elsewhere on the board
/ID_0: U201.33 (PB12); also elsewhere on the board
/ID_1: U201.44 (PA11); also elsewhere on the board
/ID_2: U201.45 (PA12); also elsewhere on the board
/MISO: U201.52 (PC11); also elsewhere on the board
/NRST: C210.1, J201.5, R204.2, U201.7 (NRST)
/NTC_1_ADC: U201.14 (PA0); also elsewhere on the board
/NTC_1_GPIO: U201.15 (PA1); also elsewhere on the board
/NTC_2_ADC: U201.25 (PC5); also elsewhere on the board
/NTC_2_GPIO: U201.24 (PC4); also elsewhere on the board
/PA5: D201.2 (Anode), U201.21 (PA5)
/PA6: D202.2 (Anode), U201.22 (PA6)
/PA7: D203.2 (Anode), U201.23 (PA7)
/PWR_ENABLE_GPIO: U201.41 (PA8); also elsewhere on the board
/SCLK: U201.51 (PC10); also elsewhere on the board
/STM32F446/PA2: R211.2, U201.16 (PA2)
/STM32F446/PA3: C215.2, R207.2, U201.17 (PA3)
/STM32F446/SWCLK: J201.2, U201.49 (PA14)
/STM32F446/SWDIO: J201.4, U201.46 (PA13)
/STM32F446/SWO: J201.6, U201.55 (PB3)
/STM32F446/USART2_RX: J202.3, R207.1
/STM32F446/USART2_TX: J202.2, R211.1
/STM32F446/USER_BTN: C214.1, R206.2, U201.2 (PC13)
/VBat: C204.2, U201.1 (VBAT)
DGND: C201.1, C202.2, C203.1, C204.1, C205.1, C206.2, C207.2, C208.1, C209.1, C210.2, C211.1, C212.2, C213.2, C214.2, C215.1, J201.3, J202.1, R208.1, R209.1, R210.1, R212.1, SW201.4, SW202.3, U201.12 (VSSA/VREF-), U201.18 (VSS), U201.31 (VSS), U201.47 (VSS), U201.63 (VSS); also elsewhere on the board
unnamed: C201.2, R201.2, XTAL201.4
unnamed: C202.1, U201.3 (PC14-OSC32_IN), XTAL201.1
unnamed: C205.2, R202.2, XTAL202.1
unnamed: C206.1, U201.5 (PH0-OSC_IN), XTAL202.2
unnamed: C211.2, U201.30 (VCAP_1)
unnamed: D201.1 (Cathode), R208.2
unnamed: D202.1 (Cathode), R209.2
unnamed: D203.1 (Cathode), R210.2
unnamed: R201.1, U201.4 (PC15-OSC32_OUT)
unnamed: R202.1, U201.6 (PH1-OSC_OUT)
unnamed: R203.1, R204.1, SW201.2
unnamed: R205.1, R206.1, SW202.1
unnamed: R212.2, U201.60 (BOOT0)
VDD: C203.2, C207.1, C208.2, C209.2, C212.1, C213.1, J201.1, R203.2, R205.2, U201.13 (VDDA/VREF+), U201.19 (VDD), U201.32 (VDD), U201.48 (VDD), U201.64 (VDD); also elsewhere on the board

Notes on the sheet:
RESET
HSE
LSE
HSE AND LSE need to be routed as close as possible to the mcu. See : AN2867
LED : BLINK, DEBUG, ASSERT
USART2
USER BUTTON
SWD Connector

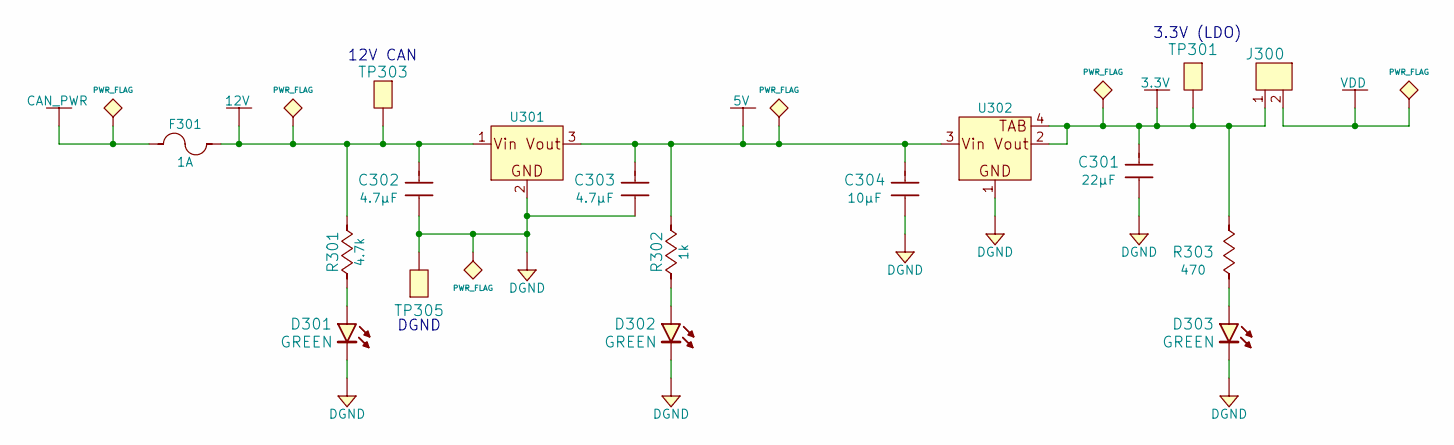
[picture p47: schematic Power Supply.sch]

Parts:
C301: 885012107005; C0805; Tolerance (%) ±20%; Voltage Rated (Volt) 6.3V; Manufacturer Part Number 885012107005
C302, C303: 885012107018; C0805; Tolerance (%) ±20%; Voltage Rated (Volt) 25V; Manufacturer Part Number 885012107018
C304: 885012107014; C0805; Tolerance (%) ±20%; Voltage Rated (Volt) 16V; Manufacturer Part Number 885012007027
D301, D302, D303: 150080VS75000; LED_0805_GREEN; Voltage - Forward (Vf) 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 2V; Manufacturer Part Number 150080VS75000
F301: 39511000440; TE5_395; Current Rating (A) 1A; Voltage Rating - AC 125V; Manufacturer Part Number 56200001009
J300: Header_Male_Pin_2.54mm_1X2_,_Unshrouded; Headers_2.54mm_1X2; Manufacturer Part Number Manufacturer Part Number
R301: RC0805JR-074K7L; R0805; Tolerance (%) ±5%; Manufacturer Part Number RC0805JR-074K7L
R302: RC0805JR-071KL; R0805; Tolerance (%) ±5%; Manufacturer Part Number RC0805JR-071KL
R303: RC0805JR-07470RL; R0805; Tolerance (%) ±5%; Manufacturer Part Number RC0805JR-07470RL
TP301, TP303, TP305: Test_Point_THM; Keystone_5001; Manufacturer Part Number 5001
U301: OKI-78SR-5/1.5-W36-C; OKI-78SR_Horizontal; Voltage - Input (Min) 7V; Voltage - Input (Max) 36V; Manufacturer Part Number OKI-78SR-5/1.5-W36H-C
U302: AZ1117IH-3.3TRG1; SOT-223-3; Voltage - Output 3.3V; Voltage - Dropout (Typi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 1.2V @ 800mA; Manufacturer Part Number AZ1117IH-3.3TRG1

Connections:
3.3V: C301.2, J300.1, R303.2, TP301.1, U302.2 (Vout), U302.4 (Vout_(TAB))
5V: C303.2, C304.2, R302.2, U301.3 (Vout), U302.3 (Vin)
12V: C302.2, F301.2, R301.2, TP303.1, U301.1 (Vin)
CAN_PWR: F301.1; also elsewhere on the board
DGND: C301.1, C302.1, C303.1, C304.1, D301.1 (Cathode), D302.1 (Cathode), D303.1 (Cathode), TP305.1, U301.2 (GND), U302.1 (GND); also elsewhere on the board
unnamed: D301.2 (Anode), R301.1
unnamed: D302.2 (Anode), R302.1
unnamed: D303.2 (Anode), R303.1
VDD: J300.2; also elsewhere on the board

Notes on the sheet:
12V CAN
DGND
3.3V (LDO)

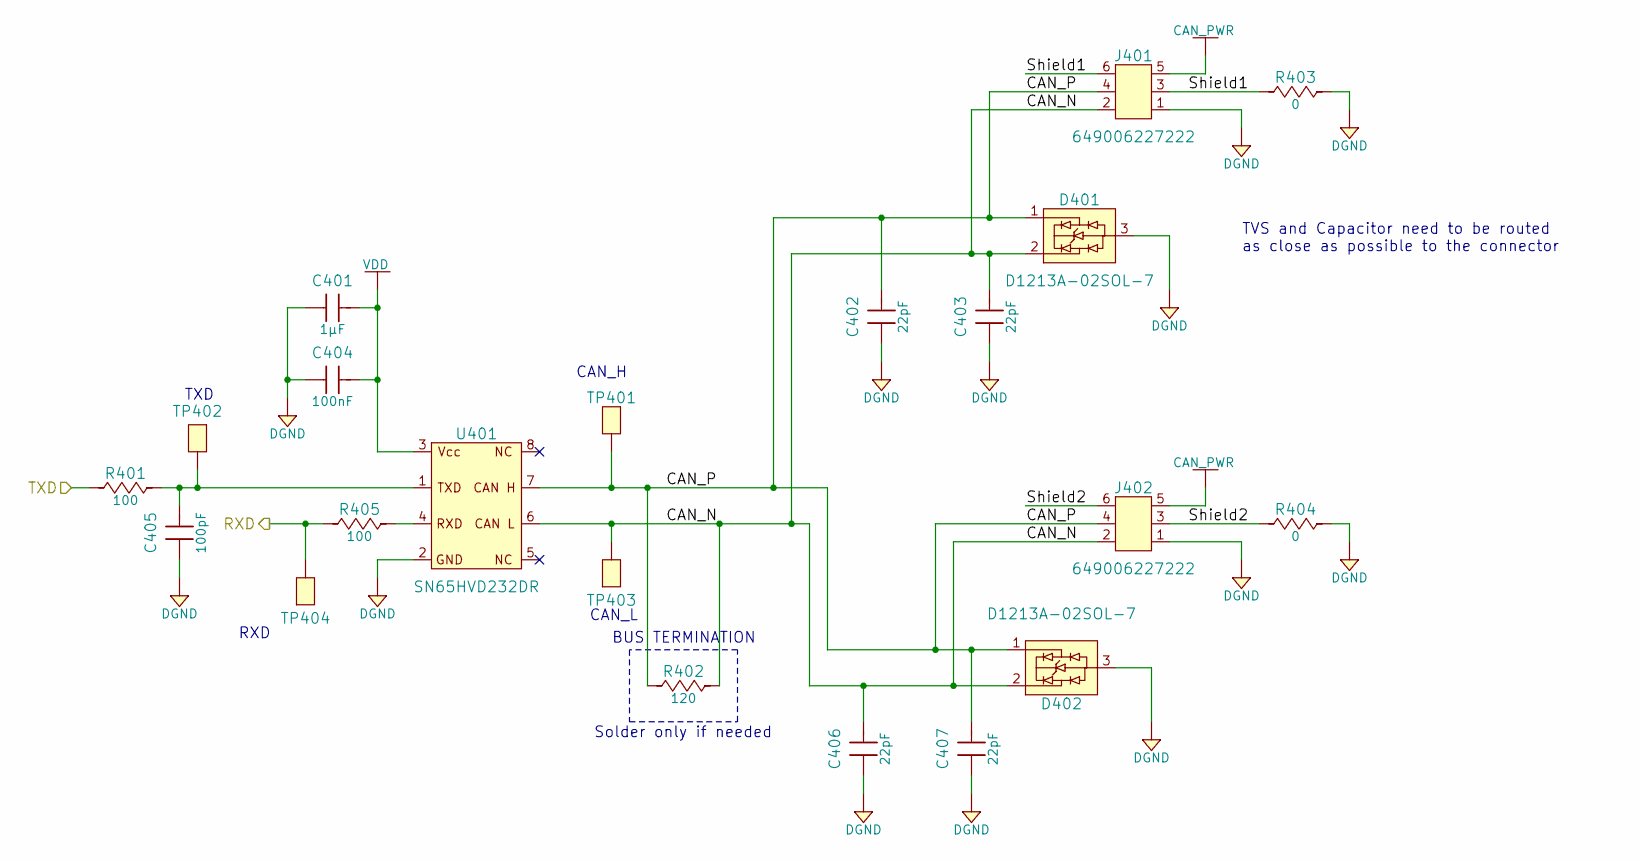
[picture p48: schematic CAN.sch, Can Bus Template]

Parts:
C401: 885012107015; C0805; Tolerance (%) ±20%; Voltage Rated (Volt) 25V; Manufacturer Part Number 885012107015
C402, C403, C406, C407: 885012007053; C0805; Tolerance (%) ±5%; Voltage Rated (Volt) 50V; Manufacturer Part Number 885012007053
C404: 885012207098; C0805; Tolerance (%) ±10%; Voltage Rated (Volt) 50V; Manufacturer Part Number 885012207098
C405: 885012207080; C0805; Tolerance (%) ±10%; Voltage Rated (Volt) 50V; Manufacturer Part Number 885012207080
D401, D402: D1213A-02SOL-7; SOT-23-3; Manufacturer Part Number D1213A-02SOL-7
J401, J402: 649006227222; Manufacturer Part Number 649006227222
R401, R405: RC0805JR-07100RL; R0805; Tolerance (%) ±5%; Manufacturer Part Number RC0805JR-07100RL
R402: RC1206JR-07120RL; R1206; Tolerance (%) ±5%; Manufacturer Part Number RC1206JR-07120RL
R403, R404: RC0805JR-070RL; R0805; Tolerance (%) 0; Manufacturer Part Number RC0805JR-070RL
TP401, TP402, TP403, TP404: Test_Point_THM; Keystone_5001; Manufacturer Part Number 5001
U401: SN65HVD232DR; SOIC-8; Manufacturer Part Number SN65HVD232DR

Connections:
/CAN1/CAN_N: C403.2, C406.2, D401.2 (CH2), D402.2 (CH2), J401.2, J402.2, R402.2, TP403.1, U401.6 (CAN_L)
/CAN1/CAN_P: C402.2, C407.2, D401.1 (CH1), D402.1 (CH1), J401.4, J402.4, R402.1, TP401.1, U401.7 (CAN_H)
/CAN1/Shield1: J401.3, J401.6, R403.1
/CAN1/Shield2: J402.3, J402.6, R404.1
/CAN2_RX: R405.1, TP404.1; also elsewhere on the board
/CAN2_TX: R401.1; also elsewhere on the board
CAN_PWR: J401.5, J402.5; also elsewhere on the board
DGND: C401.1, C402.1, C403.1, C404.1, C405.1, C406.1, C407.1, D401.3 (GND), D402.3 (GND), J401.1, J402.1, R403.2, R404.2, U401.2 (GND); also elsewhere on the board
unnamed: C405.2, R401.2, TP402.1, U401.1 (TXD)
unnamed: R405.2, U401.4 (RXD)
VDD: C401.2, C404.2, U401.3 (Vcc); also elsewhere on the board

Notes on the sheet:
BUS TERMINATION
Solder only if needed
TVS and Capacitor need to be routed as close as possible to the connector
CAN_L
CAN_H
TXD
RXD
