EclipseETS/E10-BMS-HW/Slave/V1/Slave.kicad_pcb

## KiCad design Slave/V1/Slave.kicad_pcb (continued)

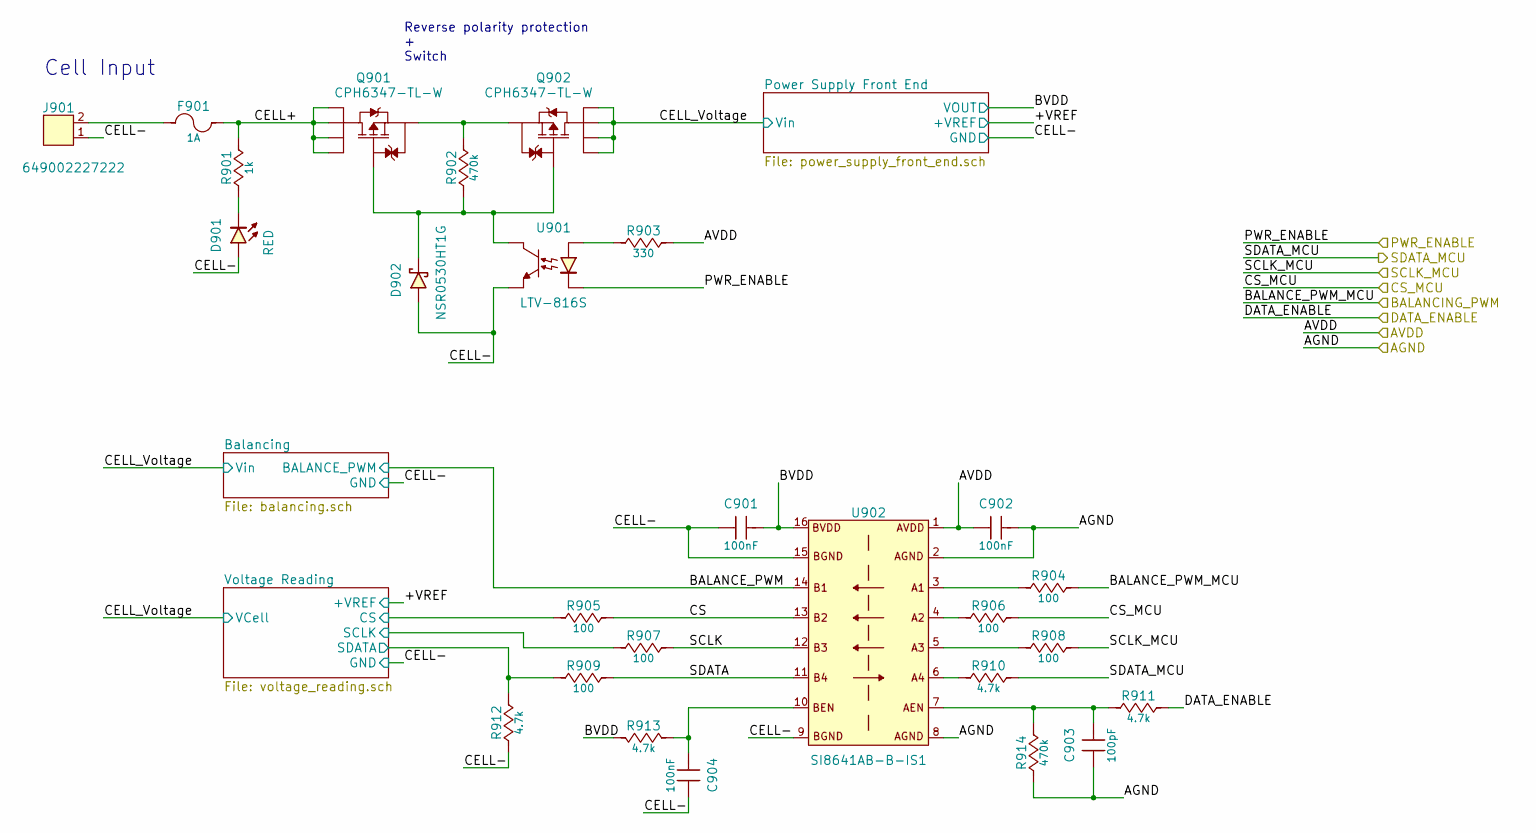
[picture p49: schematic Isolated_BMS_Slave_Front_End.sch, Isolated BMS Slave Front End]

Parts:
C501, C502, C504: 885012207098; C0805; Tolerance (%) ±10%; Voltage Rated (Volt) 50V; Manufacturer Part Number 885012207098
C503: 885012207080; C0805; Tolerance (%) ±10%; Voltage Rated (Volt) 50V; Manufacturer Part Number 885012207080
D501: 150080RS75000; LED_0805_RED; Voltage - Forward (Vf) 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 2V; Manufacturer Part Number 150080RS75000
D502: NSR0530HT1G; SOD-323; Manufacturer Part Number NSR0530HT1G
F501: 39511000440; TE5_395; Current Rating (A) 1A; Voltage Rating - AC 125V; Manufacturer Part Number 56200001009
J501: 649002227222; Manufacturer Part Number 649002227222
Q501, Q502: CPH6347-TL-W; TSOT-23-6; Manufacturer Part Number MOSFET P-CH 20V 6A CPH6
R501: RC0805JR-071KL; R0805; Tolerance (%) ±5%; Manufacturer Part Number RC0805JR-071KL
R502, R514: RC0805JR-07470KL; R0805; Tolerance (%) ±5%; Manufacturer Part Number RC0805JR-07470KL
R503: RC0805JR-07330RL; R0805; Tolerance (%) ±5%; Manufacturer Part Number RC0805JR-07330RL
R504, R505, R506, R507, R508, R509: RC0805JR-07100RL; R0805; Tolerance (%) ±5%; Manufacturer Part Number RC0805JR-07100RL
R510, R511, R512, R513: RC0805JR-074K7L; R0805; Tolerance (%) ±5%; Manufacturer Part Number RC0805JR-074K7L
U501: LTV-816S; 4-SMD; Manufacturer Part Number LTV-816S
U502: SI8641AB-B-IS1; SOIC-16; Manufacturer Part Number SI8641AB-B-IS1

Connections:
/BALANCING_PWM_1: R504.2; also elsewhere on the board
/CS_1: R506.2; also elsewhere on the board
/DATA_ENABLE_1: R511.2; also elsewhere on the board
/MISO: R510.2; also elsewhere on the board
/Module 1/BALANCE_PWM: U502.14 (B1); also elsewhere on the board
/Module 1/BVDD: C501.2, R513.2, U502.16 (BVDD); also elsewhere on the board
/Module 1/CELL+: F501.2, Q501.1 (D), Q501.2 (D), Q501.5 (D), Q501.6 (D), R501.2
/Module 1/CELL-: C501.1, C504.1, D501.2 (Anode), D502.2 (Anode), J501.1, R512.1, U501.3 (E), U502.9 (BGND), U502.15 (BGND); also elsewhere on the board
/Module 1/CELL_Voltage: Q502.1 (D), Q502.2 (D), Q502.5 (D), Q502.6 (D); also elsewhere on the board
/Module 1/CS: R505.2, U502.13 (B2)
/Module 1/SCLK: R507.2, U502.12 (B3)
/Module 1/SDATA: R509.2, U502.11 (B4)
/Module 1/Voltage Reading/CS: R505.1; also elsewhere on the board
/Module 1/Voltage Reading/SCLK: R507.1; also elsewhere on the board
/Module 1/Voltage Reading/SDATA: R509.1, R512.2; also elsewhere on the board
/PWR_ENABLE: U501.2 (Cathode); also elsewhere on the board
/SCLK: R508.2; also elsewhere on the board
DGND: C502.2, C503.1, R514.1, U502.2 (AGND), U502.8 (AGND); also elsewhere on the board
unnamed: C503.2, R511.1, R514.2, U502.7 (AEN)
unnamed: C504.2, R513.1, U502.10 (BEN)
unnamed: D501.1 (Cathode), R501.1
unnamed: D502.1 (Cathode), Q501.3 (G), Q502.3 (G), R502.1, U501.4 (C)
unnamed: F501.1, J501.2
unnamed: Q501.4 (S), Q502.4 (S), R502.2
unnamed: R503.1, U501.1 (Anode)
unnamed: R504.1, U502.3 (A1)
unnamed: R506.1, U502.4 (A2)
unnamed: R508.1, U502.5 (A3)
unnamed: R510.1, U502.6 (A4)
VDD: C502.1, R503.2, U502.1 (AVDD); also elsewhere on the board

Parts of its further copies:
C901, C902, C904, C1301, C1302, C1304, C1701, C1702, C1704, C2101, C2102, C2104, C2501, C2502, C2504, C2901, C2902, C2904, C3301, C3302, C3304: 885012207098; C0805; Tolerance (%) ±10%; Voltage Rated (Volt) 50V; Manufacturer Part Number 885012207098
C903, C1303, C1703, C2103, C2503, C2903, C3303: 885012207080; C0805; Tolerance (%) ±10%; Voltage Rated (Volt) 50V; Manufacturer Part Number 885012207080
D901, D1301, D1701, D2101, D2501, D2901, D3301: 150080RS75000; LED_0805_RED; Voltage - Forward (Vf) 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 2V; Manufacturer Part Number 150080RS75000
D902, D1302, D1702, D2102, D2502, D2902, D3302: NSR0530HT1G; SOD-323; Manufacturer Part Number NSR0530HT1G
F901, F1301, F1701, F2101, F2501, F2901, F3301: 39511000440; TE5_395; Current Rating (A) 1A; Voltage Rating - AC 125V; Manufacturer Part Number 56200001009
J901, J1301, J1701, J2101, J2501, J2901, J3301: 649002227222; Manufacturer Part Number 649002227222
Q901, Q902, Q1301, Q1302, Q1701, Q1702, Q2101, Q2102, Q2501, Q2502, Q2901, Q2902, Q3301, Q3302: CPH6347-TL-W; TSOT-23-6; Manufacturer Part Number MOSFET P-CH 20V 6A CPH6
R901, R1301, R1701, R2101, R2501, R2901, R3301: RC0805JR-071KL; R0805; Tolerance (%) ±5%; Manufacturer Part Number RC0805JR-071KL
R902, R914, R1302, R1314, R1702, R1714, R2102, R2114, R2502, R2514, R2902, R2914, R3302, R3314: RC0805JR-07470KL; R0805; Tolerance (%) ±5%; Manufacturer Part Number RC0805JR-07470KL
R903, R1303, R1703, R2103, R2503, R2903, R3303: RC0805JR-07330RL; R0805; Tolerance (%) ±5%; Manufacturer Part Number RC0805JR-07330RL
R904, R905, R906, R907, R908, R909, R1304, R1305, R1306, R1307, R1308, R1309, R1704, R1705, R1706, R1707, R1708, R1709, R2104, R2105, R2106, R2107, R2108, R2109, R2504, R2505, R2506, R2507, R2508, R2509, R2904, R2905, R2906, R2907, R2908, R2909, R3304, R3305, R3306, R3307, R3308, R3309: RC0805JR-07100RL; R0805; Tolerance (%) ±5%; Manufacturer Part Number RC0805JR-07100RL
R910, R911, R912, R913, R1310, R1311, R1312, R1313, R1710, R1711, R1712, R1713, R2110, R2111, R2112, R2113, R2510, R2511, R2512, R2513, R2910, R2911, R2912, R2913, R3310, R3311, R3312, R3313: RC0805JR-074K7L; R0805; Tolerance (%) ±5%; Manufacturer Part Number RC0805JR-074K7L
U901, U1301, U1701, U2101, U2501, U2901, U3301: LTV-816S; 4-SMD; Manufacturer Part Number LTV-816S
U902, U1302, U1702, U2102, U2502, U2902, U3302: SI8641AB-B-IS1; SOIC-16; Manufacturer Part Number SI8641AB-B-IS1

Connections of its further copies:
/BALANCING_PWM_2: R904.2; also elsewhere on the board
/BALANCING_PWM_3: R1304.2; also elsewhere on the board
/BALANCING_PWM_4: R1704.2; also elsewhere on the board
/BALANCING_PWM_5: R2104.2; also elsewhere on the board
/BALANCING_PWM_6: R2504.2; also elsewhere on the board
/BALANCING_PWM_7: R2904.2; also elsewhere on the board
/BALANCING_PWM_8: R3304.2; also elsewhere on the board
/CS_2: R906.2; also elsewhere on the board
/CS_3: R1306.2; also elsewhere on the board
/CS_4: R1706.2; also elsewhere on the board
/CS_5: R2106.2; also elsewhere on the board
/CS_6: R2506.2; also elsewhere on the board
/CS_7: R2906.2; also elsewhere on the board
/CS_8: R3306.2; also elsewhere on the board
/DATA_ENABLE_2: R911.2; also elsewhere on the board
/DATA_ENABLE_3: R1311.2; also elsewhere on the board
/DATA_ENABLE_4: R1711.2; also elsewhere on the board
/DATA_ENABLE_5: R2111.2; also elsewhere on the board
/DATA_ENABLE_6: R2511.2; also elsewhere on the board
/DATA_ENABLE_7: R2911.2; also elsewhere on the board
/DATA_ENABLE_8: R3311.2; also elsewhere on the board
/MISO: R910.2, R1310.2, R1710.2, R2110.2, R2510.2, R2910.2, R3310.2; also elsewhere on the board
/Module 2/BALANCE_PWM: U902.14 (B1); also elsewhere on the board
/Module 2/BVDD: C901.2, R913.2, U902.16 (BVDD); also elsewhere on the board
/Module 2/CELL+: F901.2, Q901.1 (D), Q901.2 (D), Q901.5 (D), Q901.6 (D), R901.2
/Module 2/CELL-: C901.1, C904.1, D901.2 (Anode), D902.2 (Anode), J901.1, R912.1, U901.3 (E), U902.9 (BGND), U902.15 (BGND); also elsewhere on the board
/Module 2/CELL_Voltage: Q902.1 (D), Q902.2 (D), Q902.5 (D), Q902.6 (D); also elsewhere on the board
/Module 2/CS: R905.2, U902.13 (B2)
/Module 2/SCLK: R907.2, U902.12 (B3)
/Module 2/SDATA: R909.2, U902.11 (B4)
/Module 2/Voltage Reading/CS: R905.1; also elsewhere on the board
/Module 2/Voltage Reading/SCLK: R907.1; also elsewhere on the board
/Module 2/Voltage Reading/SDATA: R909.1, R912.2; also elsewhere on the board
/Module 3/BALANCE_PWM: U1302.14 (B1); also elsewhere on the board
/Module 3/BVDD: C1301.2, R1313.2, U1302.16 (BVDD); also elsewhere on the board
/Module 3/CELL+: F1301.2, Q1301.1 (D), Q1301.2 (D), Q1301.5 (D), Q1301.6 (D), R1301.2
/Module 3/CELL-: C1301.1, C1304.1, D1301.2 (Anode), D1302.2 (Anode), J1301.1, R1312.1, U1301.3 (E), U1302.9 (BGND), U1302.15 (BGND); also elsewhere on the board
/Module 3/CELL_Voltage: Q1302.1 (D), Q1302.2 (D), Q1302.5 (D), Q1302.6 (D); also elsewhere on the board
/Module 3/CS: R1305.2, U1302.13 (B2)
/Module 3/SCLK: R1307.2, U1302.12 (B3)
/Module 3/SDATA: R1309.2, U1302.11 (B4)
/Module 3/Voltage Reading/CS: R1305.1; also elsewhere on the board
/Module 3/Voltage Reading/SCLK: R1307.1; also elsewhere on the board
/Module 3/Voltage Reading/SDATA: R1309.1, R1312.2; also elsewhere on the board
/Module 4/BALANCE_PWM: U1702.14 (B1); also elsewhere on the board
/Module 4/BVDD: C1701.2, R1713.2, U1702.16 (BVDD); also elsewhere on the board
/Module 4/CELL+: F1701.2, Q1701.1 (D), Q1701.2 (D), Q1701.5 (D), Q1701.6 (D), R1701.2
/Module 4/CELL-: C1701.1, C1704.1, D1701.2 (Anode), D1702.2 (Anode), J1701.1, R1712.1, U1701.3 (E), U1702.9 (BGND), U1702.15 (BGND); also elsewhere on the board
/Module 4/CELL_Voltage: Q1702.1 (D), Q1702.2 (D), Q1702.5 (D), Q1702.6 (D); also elsewhere on the board
/Module 4/CS: R1705.2, U1702.13 (B2)
/Module 4/SCLK: R1707.2, U1702.12 (B3)
/Module 4/SDATA: R1709.2, U1702.11 (B4)
/Module 4/Voltage Reading/CS: R1705.1; also elsewhere on the board
/Module 4/Voltage Reading/SCLK: R1707.1; also elsewhere on the board
/Module 4/Voltage Reading/SDATA: R1709.1, R1712.2; also elsewhere on the board
/Module 5/BALANCE_PWM: U2102.14 (B1); also elsewhere on the board
/Module 5/BVDD: C2101.2, R2113.2, U2102.16 (BVDD); also elsewhere on the board
/Module 5/CELL+: F2101.2, Q2101.1 (D), Q2101.2 (D), Q2101.5 (D), Q2101.6 (D), R2101.2
/Module 5/CELL-: C2101.1, C2104.1, D2101.2 (Anode), D2102.2 (Anode), J2101.1, R2112.1, U2101.3 (E), U2102.9 (BGND), U2102.15 (BGND); also elsewhere on the board
/Module 5/CELL_Voltage: Q2102.1 (D), Q2102.2 (D), Q2102.5 (D), Q2102.6 (D); also elsewhere on the board
/Module 5/CS: R2105.2, U2102.13 (B2)
/Module 5/SCLK: R2107.2, U2102.12 (B3)
/Module 5/SDATA: R2109.2, U2102.11 (B4)
/Module 5/Voltage Reading/CS: R2105.1; also elsewhere on the board
/Module 5/Voltage Reading/SCLK: R2107.1; also elsewhere on the board
/Module 5/Voltage Reading/SDATA: R2109.1, R2112.2; also elsewhere on the board
/Module 6/BALANCE_PWM: U2502.14 (B1); also elsewhere on the board
/Module 6/BVDD: C2501.2, R2513.2, U2502.16 (BVDD); also elsewhere on the board
/Module 6/CELL+: F2501.2, Q2501.1 (D), Q2501.2 (D), Q2501.5 (D), Q2501.6 (D), R2501.2
/Module 6/CELL-: C2501.1, C2504.1, D2501.2 (Anode), D2502.2 (Anode), J2501.1, R2512.1, U2501.3 (E), U2502.9 (BGND), U2502.15 (BGND); also elsewhere on the board
/Module 6/CELL_Voltage: Q2502.1 (D), Q2502.2 (D), Q2502.5 (D), Q2502.6 (D); also elsewhere on the board
/Module 6/CS: R2505.2, U2502.13 (B2)
/Module 6/SCLK: R2507.2, U2502.12 (B3)
/Module 6/SDATA: R2509.2, U2502.11 (B4)
/Module 6/Voltage Reading/CS: R2505.1; also elsewhere on the board
/Module 6/Voltage Reading/SCLK: R2507.1; also elsewhere on the board
/Module 6/Voltage Reading/SDATA: R2509.1, R2512.2; also elsewhere on the board
/Module 7/BALANCE_PWM: U2902.14 (B1); also elsewhere on the board
/Module 7/BVDD: C2901.2, R2913.2, U2902.16 (BVDD); also elsewhere on the board
/Module 7/CELL+: F2901.2, Q2901.1 (D), Q2901.2 (D), Q2901.5 (D), Q2901.6 (D), R2901.2
/Module 7/CELL-: C2901.1, C2904.1, D2901.2 (Anode), D2902.2 (Anode), J2901.1, R2912.1, U2901.3 (E), U2902.9 (BGND), U2902.15 (BGND); also elsewhere on the board
/Module 7/CELL_Voltage: Q2902.1 (D), Q2902.2 (D), Q2902.5 (D), Q2902.6 (D); also elsewhere on the board
/Module 7/CS: R2905.2, U2902.13 (B2)
/Module 7/SCLK: R2907.2, U2902.12 (B3)
/Module 7/SDATA: R2909.2, U2902.11 (B4)
/Module 7/Voltage Reading/CS: R2905.1; also elsewhere on the board
/Module 7/Voltage Reading/SCLK: R2907.1; also elsewhere on the board
/Module 7/Voltage Reading/SDATA: R2909.1, R2912.2; also elsewhere on the board
/Module 8/BALANCE_PWM: U3302.14 (B1); also elsewhere on the board
/Module 8/BVDD: C3301.2, R3313.2, U3302.16 (BVDD); also elsewhere on the board
/Module 8/CELL+: F3301.2, Q3301.1 (D), Q3301.2 (D), Q3301.5 (D), Q3301.6 (D), R3301.2
/Module 8/CELL-: C3301.1, C3304.1, D3301.2 (Anode), D3302.2 (Anode), J3301.1, R3312.1, U3301.3 (E), U3302.9 (BGND), U3302.15 (BGND); also elsewhere on the board
/Module 8/CELL_Voltage: Q3302.1 (D), Q3302.2 (D), Q3302.5 (D), Q3302.6 (D); also elsewhere on the board
/Module 8/CS: R3305.2, U3302.13 (B2)
/Module 8/SCLK: R3307.2, U3302.12 (B3)
/Module 8/SDATA: R3309.2, U3302.11 (B4)
/Module 8/Voltage Reading/CS: R3305.1; also elsewhere on the board
/Module 8/Voltage Reading/SCLK: R3307.1; also elsewhere on the board
/Module 8/Voltage Reading/SDATA: R3309.1, R3312.2; also elsewhere on the board
/PWR_ENABLE: U901.2 (Cathode), U1301.2 (Cathode), U1701.2 (Cathode), U2101.2 (Cathode), U2501.2 (Cathode), U2901.2 (Cathode), U3301.2 (Cathode); also elsewhere on the board
/SCLK: R908.2, R1308.2, R1708.2, R2108.2, R2508.2, R2908.2, R3308.2; also elsewhere on the board
DGND: C902.2, C903.1, C1302.2, C1303.1, C1702.2, C1703.1, C2102.2, C2103.1, C2502.2, C2503.1, C2902.2, C2903.1, C3302.2, C3303.1, R914.1, R1314.1, R1714.1, R2114.1, R2514.1, R2914.1, R3314.1, U902.2 (AGND), U902.8 (AGND), U1302.2 (AGND), U1302.8 (AGND), U1702.2 (AGND), U1702.8 (AGND), U2102.2 (AGND), U2102.8 (AGND), U2502.2 (AGND), U2502.8 (AGND), U2902.2 (AGND), U2902.8 (AGND), U3302.2 (AGND), U3302.8 (AGND); also elsewhere on the board
unnamed: C903.2, R911.1, R914.2, U902.7 (AEN)
unnamed: C904.2, R913.1, U902.10 (BEN)
unnamed: C1303.2, R1311.1, R1314.2, U1302.7 (AEN)
unnamed: C1304.2, R1313.1, U1302.10 (BEN)
unnamed: C1703.2, R1711.1, R1714.2, U1702.7 (AEN)
unnamed: C1704.2, R1713.1, U1702.10 (BEN)
unnamed: C2103.2, R2111.1, R2114.2, U2102.7 (AEN)
unnamed: C2104.2, R2113.1, U2102.10 (BEN)
unnamed: C2503.2, R2511.1, R2514.2, U2502.7 (AEN)
unnamed: C2504.2, R2513.1, U2502.10 (BEN)
unnamed: C2903.2, R2911.1, R2914.2, U2902.7 (AEN)
unnamed: C2904.2, R2913.1, U2902.10 (BEN)
unnamed: C3303.2, R3311.1, R3314.2, U3302.7 (AEN)
unnamed: C3304.2, R3313.1, U3302.10 (BEN)
unnamed: D901.1 (Cathode), R901.1
unnamed: D902.1 (Cathode), Q901.3 (G), Q902.3 (G), R902.1, U901.4 (C)
unnamed: D1301.1 (Cathode), R1301.1
unnamed: D1302.1 (Cathode), Q1301.3 (G), Q1302.3 (G), R1302.1, U1301.4 (C)
unnamed: D1701.1 (Cathode), R1701.1
unnamed: D1702.1 (Cathode), Q1701.3 (G), Q1702.3 (G), R1702.1, U1701.4 (C)
unnamed: D2101.1 (Cathode), R2101.1
unnamed: D2102.1 (Cathode), Q2101.3 (G), Q2102.3 (G), R2102.1, U2101.4 (C)
unnamed: D2501.1 (Cathode), R2501.1
unnamed: D2502.1 (Cathode), Q2501.3 (G), Q2502.3 (G), R2502.1, U2501.4 (C)
unnamed: D2901.1 (Cathode), R2901.1
unnamed: D2902.1 (Cathode), Q2901.3 (G), Q2902.3 (G), R2902.1, U2901.4 (C)
unnamed: D3301.1 (Cathode), R3301.1
unnamed: D3302.1 (Cathode), Q3301.3 (G), Q3302.3 (G), R3302.1, U3301.4 (C)
unnamed: F901.1, J901.2
unnamed: F1301.1, J1301.2
unnamed: F1701.1, J1701.2
unnamed: F2101.1, J2101.2
unnamed: F2501.1, J2501.2
unnamed: F2901.1, J2901.2
unnamed: F3301.1, J3301.2
unnamed: Q901.4 (S), Q902.4 (S), R902.2
unnamed: Q1301.4 (S), Q1302.4 (S), R1302.2
unnamed: Q1701.4 (S), Q1702.4 (S), R1702.2
unnamed: Q2101.4 (S), Q2102.4 (S), R2102.2
unnamed: Q2501.4 (S), Q2502.4 (S), R2502.2
unnamed: Q2901.4 (S), Q2902.4 (S), R2902.2
unnamed: Q3301.4 (S), Q3302.4 (S), R3302.2
unnamed: R903.1, U901.1 (Anode)
unnamed: R904.1, U902.3 (A1)
unnamed: R906.1, U902.4 (A2)
unnamed: R908.1, U902.5 (A3)
unnamed: R910.1, U902.6 (A4)
unnamed: R1303.1, U1301.1 (Anode)
unnamed: R1304.1, U1302.3 (A1)
unnamed: R1306.1, U1302.4 (A2)
unnamed: R1308.1, U1302.5 (A3)
unnamed: R1310.1, U1302.6 (A4)
unnamed: R1703.1, U1701.1 (Anode)
unnamed: R1704.1, U1702.3 (A1)
unnamed: R1706.1, U1702.4 (A2)
unnamed: R1708.1, U1702.5 (A3)
unnamed: R1710.1, U1702.6 (A4)
unnamed: R2103.1, U2101.1 (Anode)
unnamed: R2104.1, U2102.3 (A1)
unnamed: R2106.1, U2102.4 (A2)
unnamed: R2108.1, U2102.5 (A3)
unnamed: R2110.1, U2102.6 (A4)
unnamed: R2503.1, U2501.1 (Anode)
unnamed: R2504.1, U2502.3 (A1)
unnamed: R2506.1, U2502.4 (A2)
unnamed: R2508.1, U2502.5 (A3)
unnamed: R2510.1, U2502.6 (A4)
unnamed: R2903.1, U2901.1 (Anode)
unnamed: R2904.1, U2902.3 (A1)
unnamed: R2906.1, U2902.4 (A2)
unnamed: R2908.1, U2902.5 (A3)
unnamed: R2910.1, U2902.6 (A4)
unnamed: R3303.1, U3301.1 (Anode)
unnamed: R3304.1, U3302.3 (A1)
unnamed: R3306.1, U3302.4 (A2)
unnamed: R3308.1, U3302.5 (A3)
unnamed: R3310.1, U3302.6 (A4)
VDD: C902.1, C1302.1, C1702.1, C2102.1, C2502.1, C2902.1, C3302.1, R903.2, R1303.2, R1703.2, R2103.2, R2503.2, R2903.2, R3303.2, U902.1 (AVDD), U1302.1 (AVDD), U1702.1 (AVDD), U2102.1 (AVDD), U2502.1 (AVDD), U2902.1 (AVDD), U3302.1 (AVDD); also elsewhere on the board

Notes on the sheet:
Cell Input
Reverse polarity protection + Switch

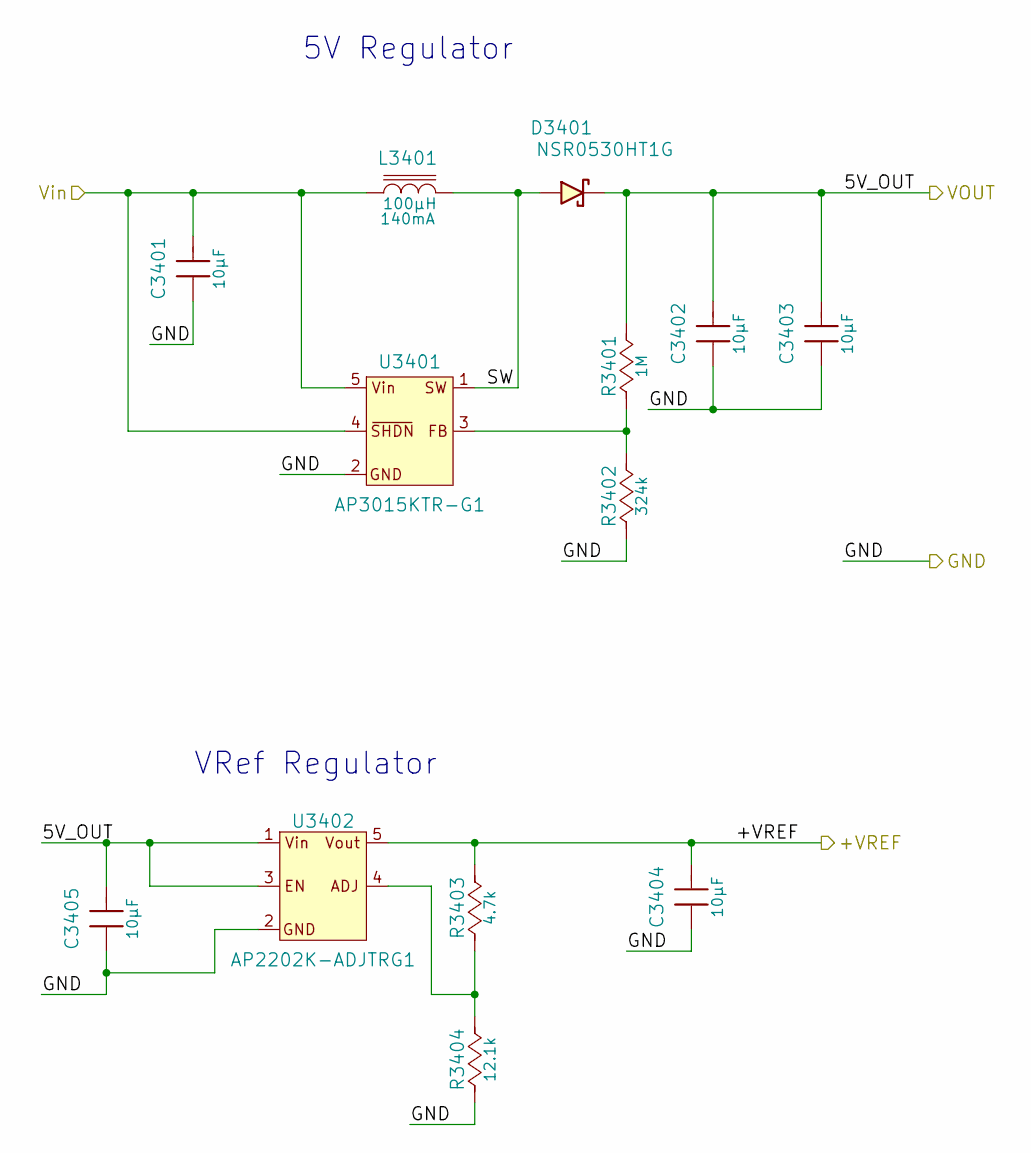
[picture p50: schematic power_supply_front_end.sch, Isolated BMS Slave Front End]

Parts:
C601, C602, C603, C604, C605: 885012107014; C0805; Tolerance (%) ±20%; Voltage Rated (Volt) 16V; Manufacturer Part Number 885012007027
D601: NSR0530HT1G; SOD-323; Manufacturer Part Number NSR0530HT1G
L601: MLZ2012N101LT000; I0805; Current Rating (Ampere) 140mA; Manufacturer Part Number MLZ2012N101LT000
R601: RC0805JR-071ML; R0805; Tolerance (%) ±5%; Manufacturer Part Number RC0805JR-071ML
R602: RC0805FR-07324KL; R0805; Tolerance (%) ±1%; Manufacturer Part Number RC0805FR-07324KL
R603: RC0805JR-074K7L; R0805; Tolerance (%) ±5%; Manufacturer Part Number RC0805JR-074K7L
R604: RC0805FR-0712K1L; R0805; Tolerance (%) ±1%; Manufacturer Part Number RC0805FR-0712K1L
U601: AP3015KTR-G1; SOT-23-5; Voltage - Input (Min) 1.2V; Voltage - Input (Max) 12V; Manufacturer Part Number AP3015KTR-G1
U602: AP2202K-ADJTRG1; SOT-23-5; Voltage - Output 2.3 V ~ 13.2 V; Voltage - Dropout (Typi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 0.165V @ 150mA; Manufacturer Part Number AP2202K-ADJTRG1

Connections:
/Module 1/+VREF: C604.2, R603.2, U602.5 (Vout); also elsewhere on the board
/Module 1/BVDD: C602.2, C603.2, C605.2, D601.1 (Cathode), R601.2, U602.1 (Vin), U602.3 (EN); also elsewhere on the board
/Module 1/CELL-: C601.1, C602.1, C603.1, C604.1, C605.1, R602.1, R604.1, U601.2 (GND), U602.2 (GND); also elsewhere on the board
/Module 1/CELL_Voltage: C601.2, L601.1, U601.4 (SHDN), U601.5 (Vin); also elsewhere on the board
/Module 1/Power Supply Front End/SW: D601.2 (Anode), L601.2, U601.1 (SW)
unnamed: R601.1, R602.2, U601.3 (FB)
unnamed: R603.1, R604.2, U602.4 (ADJ)

Parts of its further copies:
C1001, C1002, C1003, C1004, C1005, C1401, C1402, C1403, C1404, C1405, C1801, C1802, C1803, C1804, C1805, C2201, C2202, C2203, C2204, C2205, C2601, C2602, C2603, C2604, C2605, C3001, C3002, C3003, C3004, C3005, C3401, C3402, C3403, C3404, C3405: 885012107014; C0805; Tolerance (%) ±20%; Voltage Rated (Volt) 16V; Manufacturer Part Number 885012007027
D1001, D1401, D1801, D2201, D2601, D3001, D3401: NSR0530HT1G; SOD-323; Manufacturer Part Number NSR0530HT1G
L1001, L1401, L1801, L2201, L2601, L3001, L3401: MLZ2012N101LT000; I0805; Current Rating (Ampere) 140mA; Manufacturer Part Number MLZ2012N101LT000
R1001, R1401, R1801, R2201, R2601, R3001, R3401: RC0805JR-071ML; R0805; Tolerance (%) ±5%; Manufacturer Part Number RC0805JR-071ML
R1002, R1402, R1802, R2202, R2602, R3002, R3402: RC0805FR-07324KL; R0805; Tolerance (%) ±1%; Manufacturer Part Number RC0805FR-07324KL
R1003, R1403, R1803, R2203, R2603, R3003, R3403: RC0805JR-074K7L; R0805; Tolerance (%) ±5%; Manufacturer Part Number RC0805JR-074K7L
R1004, R1404, R1804, R2204, R2604, R3004, R3404: RC0805FR-0712K1L; R0805; Tolerance (%) ±1%; Manufacturer Part Number RC0805FR-0712K1L
U1001, U1401, U1801, U2201, U2601, U3001, U3401: AP3015KTR-G1; SOT-23-5; Voltage - Input (Min) 1.2V; Voltage - Input (Max) 12V; Manufacturer Part Number AP3015KTR-G1
U1002, U1402, U1802, U2202, U2602, U3002, U3402: AP2202K-ADJTRG1; SOT-23-5; Voltage - Output 2.3 V ~ 13.2 V; Voltage - Dropout (Typi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 0.165V @ 150mA; Manufacturer Part Number AP2202K-ADJTRG1

Connections of its further copies:
/Module 2/+VREF: C1004.2, R1003.2, U1002.5 (Vout); also elsewhere on the board
/Module 2/BVDD: C1002.2, C1003.2, C1005.2, D1001.1 (Cathode), R1001.2, U1002.1 (Vin), U1002.3 (EN); also elsewhere on the board
/Module 2/CELL-: C1001.1, C1002.1, C1003.1, C1004.1, C1005.1, R1002.1, R1004.1, U1001.2 (GND), U1002.2 (GND); also elsewhere on the board
/Module 2/CELL_Voltage: C1001.2, L1001.1, U1001.4 (SHDN), U1001.5 (Vin); also elsewhere on the board
/Module 2/Power Supply Front End/SW: D1001.2 (Anode), L1001.2, U1001.1 (SW)
/Module 3/+VREF: C1404.2, R1403.2, U1402.5 (Vout); also elsewhere on the board
/Module 3/BVDD: C1402.2, C1403.2, C1405.2, D1401.1 (Cathode), R1401.2, U1402.1 (Vin), U1402.3 (EN); also elsewhere on the board
/Module 3/CELL-: C1401.1, C1402.1, C1403.1, C1404.1, C1405.1, R1402.1, R1404.1, U1401.2 (GND), U1402.2 (GND); also elsewhere on the board
/Module 3/CELL_Voltage: C1401.2, L1401.1, U1401.4 (SHDN), U1401.5 (Vin); also elsewhere on the board
/Module 3/Power Supply Front End/SW: D1401.2 (Anode), L1401.2, U1401.1 (SW)
/Module 4/+VREF: C1804.2, R1803.2, U1802.5 (Vout); also elsewhere on the board
/Module 4/BVDD: C1802.2, C1803.2, C1805.2, D1801.1 (Cathode), R1801.2, U1802.1 (Vin), U1802.3 (EN); also elsewhere on the board
/Module 4/CELL-: C1801.1, C1802.1, C1803.1, C1804.1, C1805.1, R1802.1, R1804.1, U1801.2 (GND), U1802.2 (GND); also elsewhere on the board
/Module 4/CELL_Voltage: C1801.2, L1801.1, U1801.4 (SHDN), U1801.5 (Vin); also elsewhere on the board
/Module 4/Power Supply Front End/SW: D1801.2 (Anode), L1801.2, U1801.1 (SW)
/Module 5/+VREF: C2204.2, R2203.2, U2202.5 (Vout); also elsewhere on the board
/Module 5/BVDD: C2202.2, C2203.2, C2205.2, D2201.1 (Cathode), R2201.2, U2202.1 (Vin), U2202.3 (EN); also elsewhere on the board
/Module 5/CELL-: C2201.1, C2202.1, C2203.1, C2204.1, C2205.1, R2202.1, R2204.1, U2201.2 (GND), U2202.2 (GND); also elsewhere on the board
/Module 5/CELL_Voltage: C2201.2, L2201.1, U2201.4 (SHDN), U2201.5 (Vin); also elsewhere on the board
/Module 5/Power Supply Front End/SW: D2201.2 (Anode), L2201.2, U2201.1 (SW)
/Module 6/+VREF: C2604.2, R2603.2, U2602.5 (Vout); also elsewhere on the board
/Module 6/BVDD: C2602.2, C2603.2, C2605.2, D2601.1 (Cathode), R2601.2, U2602.1 (Vin), U2602.3 (EN); also elsewhere on the board
/Module 6/CELL-: C2601.1, C2602.1, C2603.1, C2604.1, C2605.1, R2602.1, R2604.1, U2601.2 (GND), U2602.2 (GND); also elsewhere on the board
/Module 6/CELL_Voltage: C2601.2, L2601.1, U2601.4 (SHDN), U2601.5 (Vin); also elsewhere on the board
/Module 6/Power Supply Front End/SW: D2601.2 (Anode), L2601.2, U2601.1 (SW)
/Module 7/+VREF: C3004.2, R3003.2, U3002.5 (Vout); also elsewhere on the board
/Module 7/BVDD: C3002.2, C3003.2, C3005.2, D3001.1 (Cathode), R3001.2, U3002.1 (Vin), U3002.3 (EN); also elsewhere on the board
/Module 7/CELL-: C3001.1, C3002.1, C3003.1, C3004.1, C3005.1, R3002.1, R3004.1, U3001.2 (GND), U3002.2 (GND); also elsewhere on the board
/Module 7/CELL_Voltage: C3001.2, L3001.1, U3001.4 (SHDN), U3001.5 (Vin); also elsewhere on the board
/Module 7/Power Supply Front End/SW: D3001.2 (Anode), L3001.2, U3001.1 (SW)
/Module 8/+VREF: C3404.2, R3403.2, U3402.5 (Vout); also elsewhere on the board
/Module 8/BVDD: C3402.2, C3403.2, C3405.2, D3401.1 (Cathode), R3401.2, U3402.1 (Vin), U3402.3 (EN); also elsewhere on the board
/Module 8/CELL-: C3401.1, C3402.1, C3403.1, C3404.1, C3405.1, R3402.1, R3404.1, U3401.2 (GND), U3402.2 (GND); also elsewhere on the board
/Module 8/CELL_Voltage: C3401.2, L3401.1, U3401.4 (SHDN), U3401.5 (Vin); also elsewhere on the board
/Module 8/Power Supply Front End/SW: D3401.2 (Anode), L3401.2, U3401.1 (SW)
unnamed: R1001.1, R1002.2, U1001.3 (FB)
unnamed: R1003.1, R1004.2, U1002.4 (ADJ)
unnamed: R1401.1, R1402.2, U1401.3 (FB)
unnamed: R1403.1, R1404.2, U1402.4 (ADJ)
unnamed: R1801.1, R1802.2, U1801.3 (FB)
unnamed: R1803.1, R1804.2, U1802.4 (ADJ)
unnamed: R2201.1, R2202.2, U2201.3 (FB)
unnamed: R2203.1, R2204.2, U2202.4 (ADJ)
unnamed: R2601.1, R2602.2, U2601.3 (FB)
unnamed: R2603.1, R2604.2, U2602.4 (ADJ)
unnamed: R3001.1, R3002.2, U3001.3 (FB)
unnamed: R3003.1, R3004.2, U3002.4 (ADJ)
unnamed: R3401.1, R3402.2, U3401.3 (FB)
unnamed: R3403.1, R3404.2, U3402.4 (ADJ)

Notes on the sheet:
5V Regulator
VRef Regulator

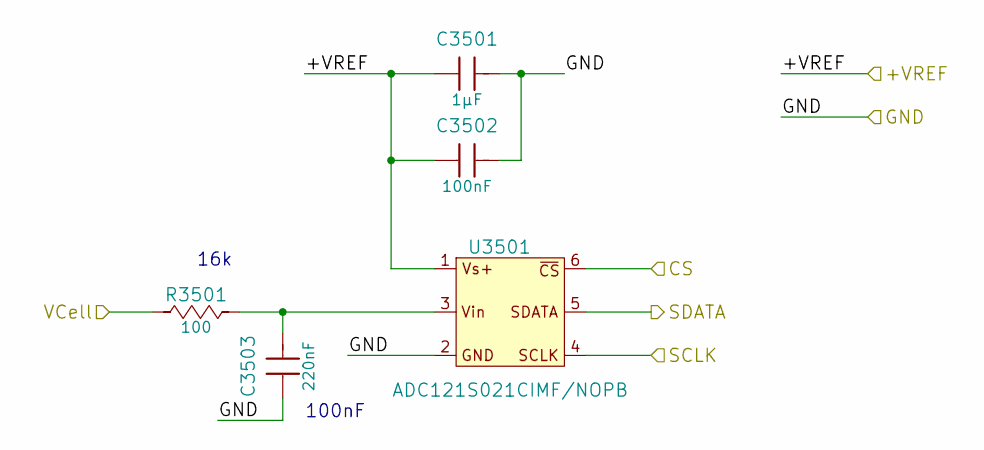
[picture p51: schematic voltage_reading.sch, Isolated BMS Slave Front End]

Parts:
C701: 885012107015; C0805; Tolerance (%) ±20%; Voltage Rated (Volt) 25V; Manufacturer Part Number 885012107015
C702: 885012207098; C0805; Tolerance (%) ±10%; Voltage Rated (Volt) 50V; Manufacturer Part Number 885012207098
C703: 885012207047; C0805; Tolerance (%) ±10%; Voltage Rated (Volt) 16V; Manufacturer Part Number 885012207047
R701: RC0805JR-07100RL; R0805; Tolerance (%) ±5%; Manufacturer Part Number RC0805JR-07100RL
U701: ADC121S021CIMF/NOPB; SOT-23-6; Manufacturer Part Number ADC121S021CIMF/NOPB

Connections:
/Module 1/+VREF: C701.1, C702.1, U701.1 (Vs+); also elsewhere on the board
/Module 1/CELL-: C701.2, C702.2, C703.1, U701.2 (GND); also elsewhere on the board
/Module 1/CELL_Voltage: R701.1; also elsewhere on the board
/Module 1/Voltage Reading/CS: U701.6 (CS); also elsewhere on the board
/Module 1/Voltage Reading/SCLK: U701.4 (SCLK); also elsewhere on the board
/Module 1/Voltage Reading/SDATA: U701.5 (SDATA); also elsewhere on the board
unnamed: C703.2, R701.2, U701.3 (Vin)

Parts of its further copies:
C1101, C1501, C1901, C2301, C2701, C3101, C3501: 885012107015; C0805; Tolerance (%) ±20%; Voltage Rated (Volt) 25V; Manufacturer Part Number 885012107015
C1102, C1502, C1902, C2302, C2702, C3102, C3502: 885012207098; C0805; Tolerance (%) ±10%; Voltage Rated (Volt) 50V; Manufacturer Part Number 885012207098
C1103, C1503, C1903, C2303, C2703, C3103, C3503: 885012207047; C0805; Tolerance (%) ±10%; Voltage Rated (Volt) 16V; Manufacturer Part Number 885012207047
R1101, R1501, R1901, R2301, R2701, R3101, R3501: RC0805JR-07100RL; R0805; Tolerance (%) ±5%; Manufacturer Part Number RC0805JR-07100RL
U1101, U1501, U1901, U2301, U2701, U3101, U3501: ADC121S021CIMF/NOPB; SOT-23-6; Manufacturer Part Number ADC121S021CIMF/NOPB

Connections of its further copies:
/Module 2/+VREF: C1101.1, C1102.1, U1101.1 (Vs+); also elsewhere on the board
/Module 2/CELL-: C1101.2, C1102.2, C1103.1, U1101.2 (GND); also elsewhere on the board
/Module 2/CELL_Voltage: R1101.1; also elsewhere on the board
/Module 2/Voltage Reading/CS: U1101.6 (CS); also elsewhere on the board
/Module 2/Voltage Reading/SCLK: U1101.4 (SCLK); also elsewhere on the board
/Module 2/Voltage Reading/SDATA: U1101.5 (SDATA); also elsewhere on the board
/Module 3/+VREF: C1501.1, C1502.1, U1501.1 (Vs+); also elsewhere on the board
/Module 3/CELL-: C1501.2, C1502.2, C1503.1, U1501.2 (GND); also elsewhere on the board
/Module 3/CELL_Voltage: R1501.1; also elsewhere on the board
/Module 3/Voltage Reading/CS: U1501.6 (CS); also elsewhere on the board
/Module 3/Voltage Reading/SCLK: U1501.4 (SCLK); also elsewhere on the board
/Module 3/Voltage Reading/SDATA: U1501.5 (SDATA); also elsewhere on the board
/Module 4/+VREF: C1901.1, C1902.1, U1901.1 (Vs+); also elsewhere on the board
/Module 4/CELL-: C1901.2, C1902.2, C1903.1, U1901.2 (GND); also elsewhere on the board
/Module 4/CELL_Voltage: R1901.1; also elsewhere on the board
/Module 4/Voltage Reading/CS: U1901.6 (CS); also elsewhere on the board
/Module 4/Voltage Reading/SCLK: U1901.4 (SCLK); also elsewhere on the board
/Module 4/Voltage Reading/SDATA: U1901.5 (SDATA); also elsewhere on the board
/Module 5/+VREF: C2301.1, C2302.1, U2301.1 (Vs+); also elsewhere on the board
/Module 5/CELL-: C2301.2, C2302.2, C2303.1, U2301.2 (GND); also elsewhere on the board
/Module 5/CELL_Voltage: R2301.1; also elsewhere on the board
/Module 5/Voltage Reading/CS: U2301.6 (CS); also elsewhere on the board
/Module 5/Voltage Reading/SCLK: U2301.4 (SCLK); also elsewhere on the board
/Module 5/Voltage Reading/SDATA: U2301.5 (SDATA); also elsewhere on the board
/Module 6/+VREF: C2701.1, C2702.1, U2701.1 (Vs+); also elsewhere on the board
/Module 6/CELL-: C2701.2, C2702.2, C2703.1, U2701.2 (GND); also elsewhere on the board
/Module 6/CELL_Voltage: R2701.1; also elsewhere on the board
/Module 6/Voltage Reading/CS: U2701.6 (CS); also elsewhere on the board
/Module 6/Voltage Reading/SCLK: U2701.4 (SCLK); also elsewhere on the board
/Module 6/Voltage Reading/SDATA: U2701.5 (SDATA); also elsewhere on the board
/Module 7/+VREF: C3101.1, C3102.1, U3101.1 (Vs+); also elsewhere on the board
/Module 7/CELL-: C3101.2, C3102.2, C3103.1, U3101.2 (GND); also elsewhere on the board
/Module 7/CELL_Voltage: R3101.1; also elsewhere on the board
/Module 7/Voltage Reading/CS: U3101.6 (CS); also elsewhere on the board
/Module 7/Voltage Reading/SCLK: U3101.4 (SCLK); also elsewhere on the board
/Module 7/Voltage Reading/SDATA: U3101.5 (SDATA); also elsewhere on the board
/Module 8/+VREF: C3501.1, C3502.1, U3501.1 (Vs+); also elsewhere on the board
/Module 8/CELL-: C3501.2, C3502.2, C3503.1, U3501.2 (GND); also elsewhere on the board
/Module 8/CELL_Voltage: R3501.1; also elsewhere on the board
/Module 8/Voltage Reading/CS: U3501.6 (CS); also elsewhere on the board
/Module 8/Voltage Reading/SCLK: U3501.4 (SCLK); also elsewhere on the board
/Module 8/Voltage Reading/SDATA: U3501.5 (SDATA); also elsewhere on the board
unnamed: C1103.2, R1101.2, U1101.3 (Vin)
unnamed: C1503.2, R1501.2, U1501.3 (Vin)
unnamed: C1903.2, R1901.2, U1901.3 (Vin)
unnamed: C2303.2, R2301.2, U2301.3 (Vin)
unnamed: C2703.2, R2701.2, U2701.3 (Vin)
unnamed: C3103.2, R3101.2, U3101.3 (Vin)
unnamed: C3503.2, R3501.2, U3501.3 (Vin)

Notes on the sheet:
16k
100nF
