EclipseETS/E10-BMS-HW/Slave/V1/Slave.kicad_pcb

## KiCad design Slave/V1/Slave.kicad_pcb (continued)

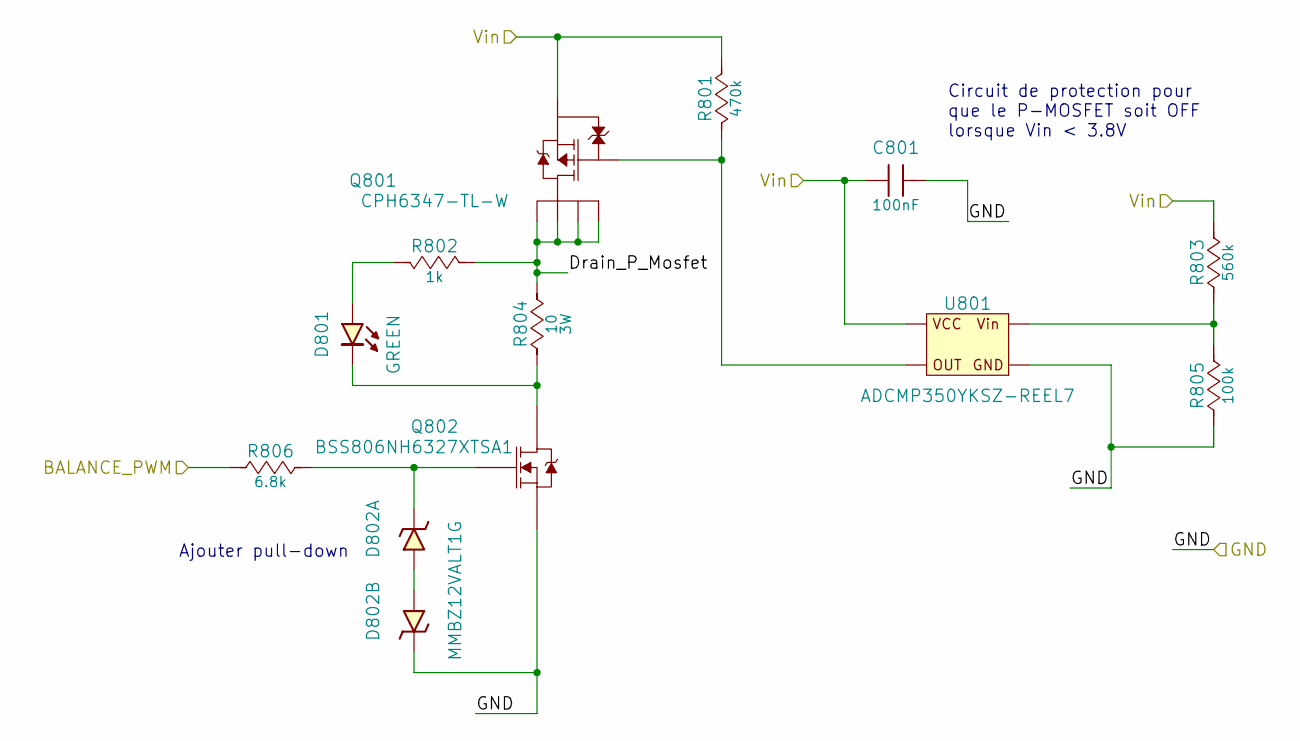
[picture p52: schematic balancing.sch, Isolated BMS Slave Front End]

Parts:
C801: 885012207098; C0805; Tolerance (%) ±10%; Voltage Rated (Volt) 50V; Manufacturer Part Number 885012207098
D801: 150080VS75000; LED_0805_GREEN; Voltage - Forward (Vf) 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 2V; Manufacturer Part Number 150080VS75000
D802: MMBZ12VALT1G; SOT-23-3; Voltage - Breakdown (Mi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 11.4V; Manufacturer Part Number MMBZ12VALT1G
Q801: CPH6347-TL-W; TSOT-23-6; Manufacturer Part Number MOSFET P-CH 20V 6A CPH6
Q802: BSS806NH6327XTSA1; SOT-23-3; Manufacturer Part Number BSS806NH6327XTSA1
R801: RC0805JR-07470KL; R0805; Tolerance (%) ±5%; Manufacturer Part Number RC0805JR-07470KL
R802: RC0805JR-071KL; R0805; Tolerance (%) ±5%; Manufacturer Part Number RC0805JR-071KL
R803: RC0805JR-07560KL; R0805; Tolerance (%) ±5%; Manufacturer Part Number RC0805JR-07560KL
R804: 352210RJT; R2512; Tolerance (%) ±5%; Manufacturer Part Number 352210RJT
R805: RC0805JR-07100KL; R0805; Tolerance (%) ±5%; Manufacturer Part Number RC0805JR-07100KL
R806: RC0805JR-076K8L; R0805; Tolerance (%) ±5%; Manufacturer Part Number RC0805JR-076K8L
U801: ADCMP350YKSZ-REEL7; SC70-4; Manufacturer Part Number ADCMP350YKSZ-REEL7

Connections:
/Module 1/BALANCE_PWM: R806.1; also elsewhere on the board
/Module 1/Balancing/Drain_P_Mosfet: Q801.1 (D), Q801.2 (D), Q801.5 (D), Q801.6 (D), R802.1, R804.2
/Module 1/CELL-: C801.2, D802.2 (Cathode), Q802.2 (S), R805.1, U801.2 (GND); also elsewhere on the board
/Module 1/CELL_Voltage: C801.1, Q801.4 (S), R801.1, R803.2, U801.4 (Vcc); also elsewhere on the board
unnamed: D801.1 (Cathode), Q802.3 (D), R804.1
unnamed: D801.2 (Anode), R802.2
unnamed: D802.1 (Cathode), Q802.1 (G), R806.2
unnamed: Q801.3 (G), R801.2, U801.3 (Output)
unnamed: R803.1, R805.2, U801.1 (Vin)

Parts of its further copies:
C1201, C1601, C2001, C2401, C2801, C3201, C3601: 885012207098; C0805; Tolerance (%) ±10%; Voltage Rated (Volt) 50V; Manufacturer Part Number 885012207098
D1201, D1601, D2001, D2401, D2801, D3201, D3601: 150080VS75000; LED_0805_GREEN; Voltage - Forward (Vf) 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 2V; Manufacturer Part Number 150080VS75000
D1202, D1602, D2002, D2402, D2802, D3202, D3602: MMBZ12VALT1G; SOT-23-3; Voltage - Breakdown (Mi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 11.4V; Manufacturer Part Number MMBZ12VALT1G
Q1201, Q1601, Q2001, Q2401, Q2801, Q3201, Q3601: CPH6347-TL-W; TSOT-23-6; Manufacturer Part Number MOSFET P-CH 20V 6A CPH6
Q1202, Q1602, Q2002, Q2402, Q2802, Q3202, Q3602: BSS806NH6327XTSA1; SOT-23-3; Manufacturer Part Number BSS806NH6327XTSA1
R1201, R1601, R2001, R2401, R2801, R3201, R3601: RC0805JR-07470KL; R0805; Tolerance (%) ±5%; Manufacturer Part Number RC0805JR-07470KL
R1202, R1602, R2002, R2402, R2802, R3202, R3602: RC0805JR-071KL; R0805; Tolerance (%) ±5%; Manufacturer Part Number RC0805JR-071KL
R1203, R1603, R2003, R2403, R2803, R3203, R3603: RC0805JR-07560KL; R0805; Tolerance (%) ±5%; Manufacturer Part Number RC0805JR-07560KL
R1204, R1604, R2004, R2404, R2804, R3204, R3604: 352210RJT; R2512; Tolerance (%) ±5%; Manufacturer Part Number 352210RJT
R1205, R1605, R2005, R2405, R2805, R3205, R3605: RC0805JR-07100KL; R0805; Tolerance (%) ±5%; Manufacturer Part Number RC0805JR-07100KL
R1206, R1606, R2006, R2406, R2806, R3206, R3606: RC0805JR-076K8L; R0805; Tolerance (%) ±5%; Manufacturer Part Number RC0805JR-076K8L
U1201, U1601, U2001, U2401, U2801, U3201, U3601: ADCMP350YKSZ-REEL7; SC70-4; Manufacturer Part Number ADCMP350YKSZ-REEL7

Connections of its further copies:
/Module 2/BALANCE_PWM: R1206.1; also elsewhere on the board
/Module 2/Balancing/Drain_P_Mosfet: Q1201.1 (D), Q1201.2 (D), Q1201.5 (D), Q1201.6 (D), R1202.1, R1204.2
/Module 2/CELL-: C1201.2, D1202.2 (Cathode), Q1202.2 (S), R1205.1, U1201.2 (GND); also elsewhere on the board
/Module 2/CELL_Voltage: C1201.1, Q1201.4 (S), R1201.1, R1203.2, U1201.4 (Vcc); also elsewhere on the board
/Module 3/BALANCE_PWM: R1606.1; also elsewhere on the board
/Module 3/Balancing/Drain_P_Mosfet: Q1601.1 (D), Q1601.2 (D), Q1601.5 (D), Q1601.6 (D), R1602.1, R1604.2
/Module 3/CELL-: C1601.2, D1602.2 (Cathode), Q1602.2 (S), R1605.1, U1601.2 (GND); also elsewhere on the board
/Module 3/CELL_Voltage: C1601.1, Q1601.4 (S), R1601.1, R1603.2, U1601.4 (Vcc); also elsewhere on the board
/Module 4/BALANCE_PWM: R2006.1; also elsewhere on the board
/Module 4/Balancing/Drain_P_Mosfet: Q2001.1 (D), Q2001.2 (D), Q2001.5 (D), Q2001.6 (D), R2002.1, R2004.2
/Module 4/CELL-: C2001.2, D2002.2 (Cathode), Q2002.2 (S), R2005.1, U2001.2 (GND); also elsewhere on the board
/Module 4/CELL_Voltage: C2001.1, Q2001.4 (S), R2001.1, R2003.2, U2001.4 (Vcc); also elsewhere on the board
/Module 5/BALANCE_PWM: R2406.1; also elsewhere on the board
/Module 5/Balancing/Drain_P_Mosfet: Q2401.1 (D), Q2401.2 (D), Q2401.5 (D), Q2401.6 (D), R2402.1, R2404.2
/Module 5/CELL-: C2401.2, D2402.2 (Cathode), Q2402.2 (S), R2405.1, U2401.2 (GND); also elsewhere on the board
/Module 5/CELL_Voltage: C2401.1, Q2401.4 (S), R2401.1, R2403.2, U2401.4 (Vcc); also elsewhere on the board
/Module 6/BALANCE_PWM: R2806.1; also elsewhere on the board
/Module 6/Balancing/Drain_P_Mosfet: Q2801.1 (D), Q2801.2 (D), Q2801.5 (D), Q2801.6 (D), R2802.1, R2804.2
/Module 6/CELL-: C2801.2, D2802.2 (Cathode), Q2802.2 (S), R2805.1, U2801.2 (GND); also elsewhere on the board
/Module 6/CELL_Voltage: C2801.1, Q2801.4 (S), R2801.1, R2803.2, U2801.4 (Vcc); also elsewhere on the board
/Module 7/BALANCE_PWM: R3206.1; also elsewhere on the board
/Module 7/Balancing/Drain_P_Mosfet: Q3201.1 (D), Q3201.2 (D), Q3201.5 (D), Q3201.6 (D), R3202.1, R3204.2
/Module 7/CELL-: C3201.2, D3202.2 (Cathode), Q3202.2 (S), R3205.1, U3201.2 (GND); also elsewhere on the board
/Module 7/CELL_Voltage: C3201.1, Q3201.4 (S), R3201.1, R3203.2, U3201.4 (Vcc); also elsewhere on the board
/Module 8/BALANCE_PWM: R3606.1; also elsewhere on the board
/Module 8/Balancing/Drain_P_Mosfet: Q3601.1 (D), Q3601.2 (D), Q3601.5 (D), Q3601.6 (D), R3602.1, R3604.2
/Module 8/CELL-: C3601.2, D3602.2 (Cathode), Q3602.2 (S), R3605.1, U3601.2 (GND); also elsewhere on the board
/Module 8/CELL_Voltage: C3601.1, Q3601.4 (S), R3601.1, R3603.2, U3601.4 (Vcc); also elsewhere on the board
unnamed: D1201.1 (Cathode), Q1202.3 (D), R1204.1
unnamed: D1201.2 (Anode), R1202.2
unnamed: D1202.1 (Cathode), Q1202.1 (G), R1206.2
unnamed: D1601.1 (Cathode), Q1602.3 (D), R1604.1
unnamed: D1601.2 (Anode), R1602.2
unnamed: D1602.1 (Cathode), Q1602.1 (G), R1606.2
unnamed: D2001.1 (Cathode), Q2002.3 (D), R2004.1
unnamed: D2001.2 (Anode), R2002.2
unnamed: D2002.1 (Cathode), Q2002.1 (G), R2006.2
unnamed: D2401.1 (Cathode), Q2402.3 (D), R2404.1
unnamed: D2401.2 (Anode), R2402.2
unnamed: D2402.1 (Cathode), Q2402.1 (G), R2406.2
unnamed: D2801.1 (Cathode), Q2802.3 (D), R2804.1
unnamed: D2801.2 (Anode), R2802.2
unnamed: D2802.1 (Cathode), Q2802.1 (G), R2806.2
unnamed: D3201.1 (Cathode), Q3202.3 (D), R3204.1
unnamed: D3201.2 (Anode), R3202.2
unnamed: D3202.1 (Cathode), Q3202.1 (G), R3206.2
unnamed: D3601.1 (Cathode), Q3602.3 (D), R3604.1
unnamed: D3601.2 (Anode), R3602.2
unnamed: D3602.1 (Cathode), Q3602.1 (G), R3606.2
unnamed: Q1201.3 (G), R1201.2, U1201.3 (Output)
unnamed: Q1601.3 (G), R1601.2, U1601.3 (Output)
unnamed: Q2001.3 (G), R2001.2, U2001.3 (Output)
unnamed: Q2401.3 (G), R2401.2, U2401.3 (Output)
unnamed: Q2801.3 (G), R2801.2, U2801.3 (Output)
unnamed: Q3201.3 (G), R3201.2, U3201.3 (Output)
unnamed: Q3601.3 (G), R3601.2, U3601.3 (Output)
unnamed: R1203.1, R1205.2, U1201.1 (Vin)
unnamed: R1603.1, R1605.2, U1601.1 (Vin)
unnamed: R2003.1, R2005.2, U2001.1 (Vin)
unnamed: R2403.1, R2405.2, U2401.1 (Vin)
unnamed: R2803.1, R2805.2, U2801.1 (Vin)
unnamed: R3203.1, R3205.2, U3201.1 (Vin)
unnamed: R3603.1, R3605.2, U3601.1 (Vin)

Notes on the sheet:
Circuit de protection pour que le P-MOSFET soit OFF lorsque Vin < 3.8V
Ajouter pull-down

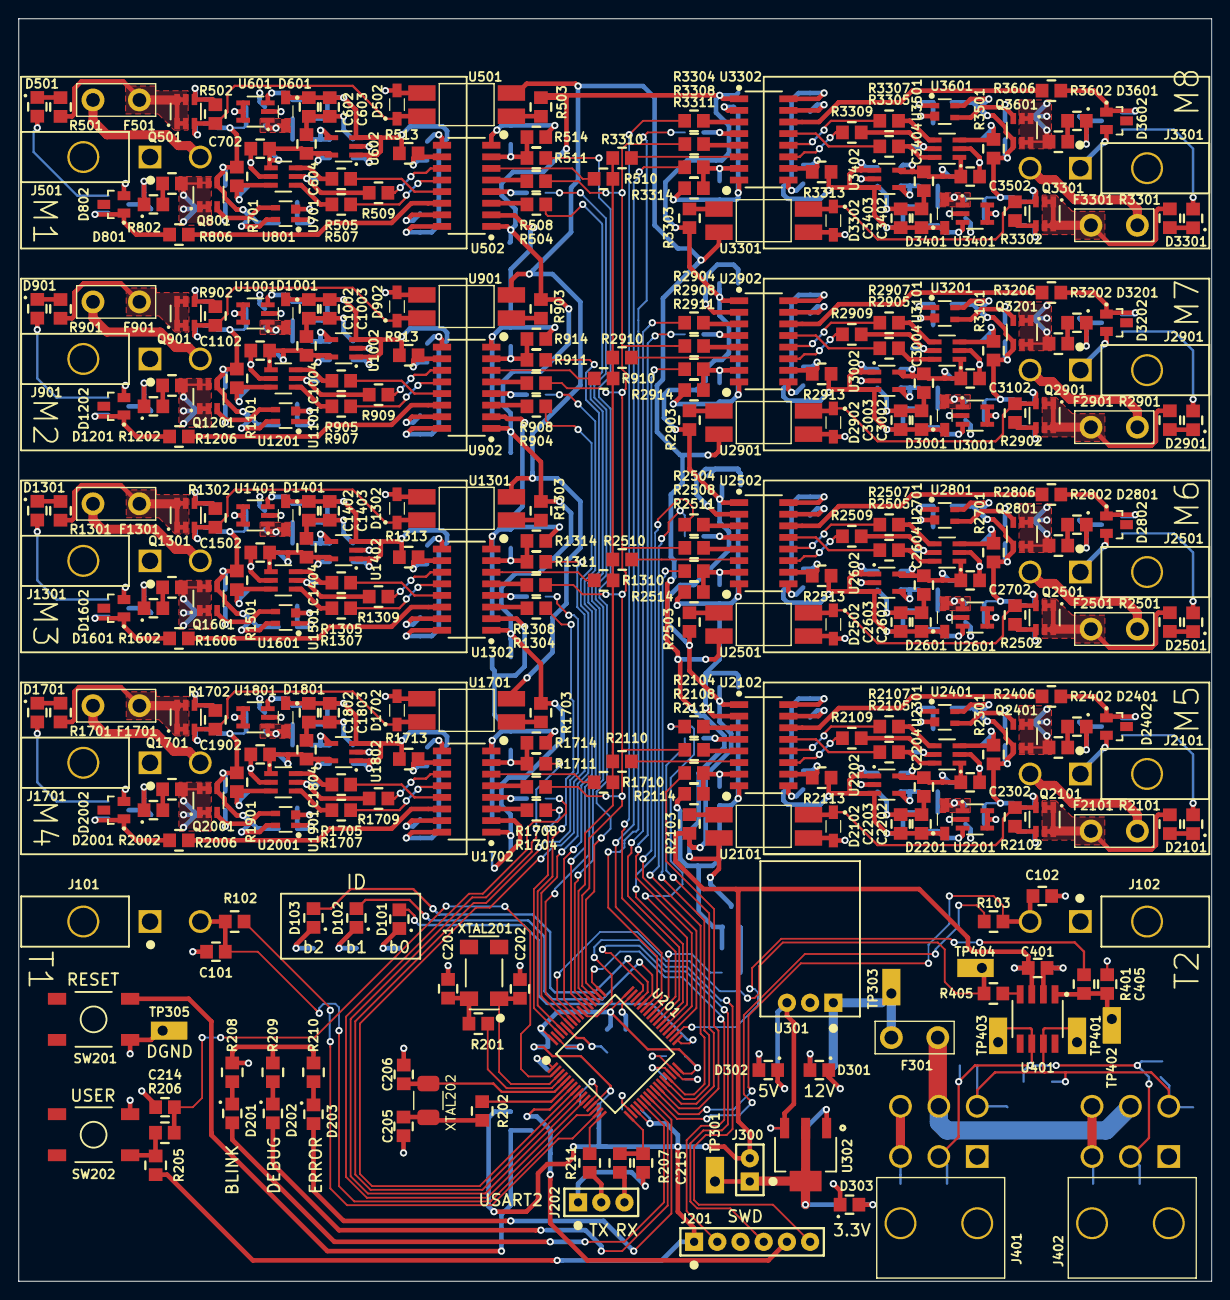
[picture p53: board Slave.kicad_pcb from above]

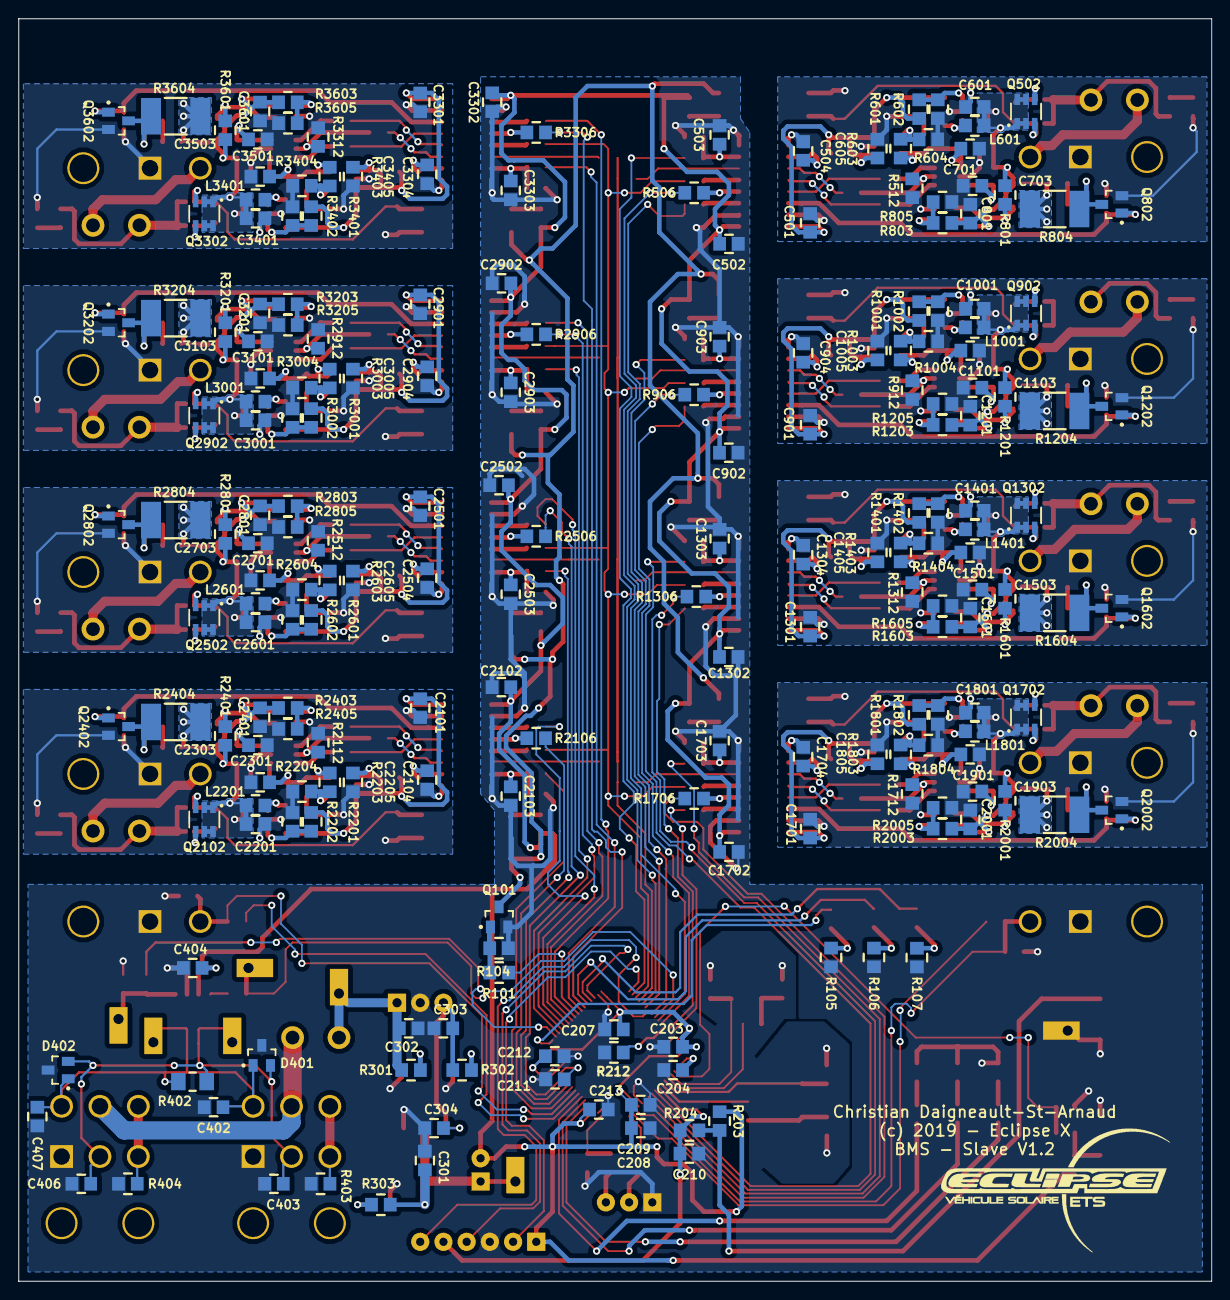
[picture p54: board Slave.kicad_pcb from below]

Board: 2 copper layers, 130.6 x 138.2 mm, 538 parts (211 on the bottom side), 346 nets.
