EclipseETS/E10-BMS-HW/Master_Board/E10/V2/Master_Board.kicad_pcb

## KiCad design Master_Board/E10/V2/Master_Board.kicad_pcb (2017-11-10, an earlier design)

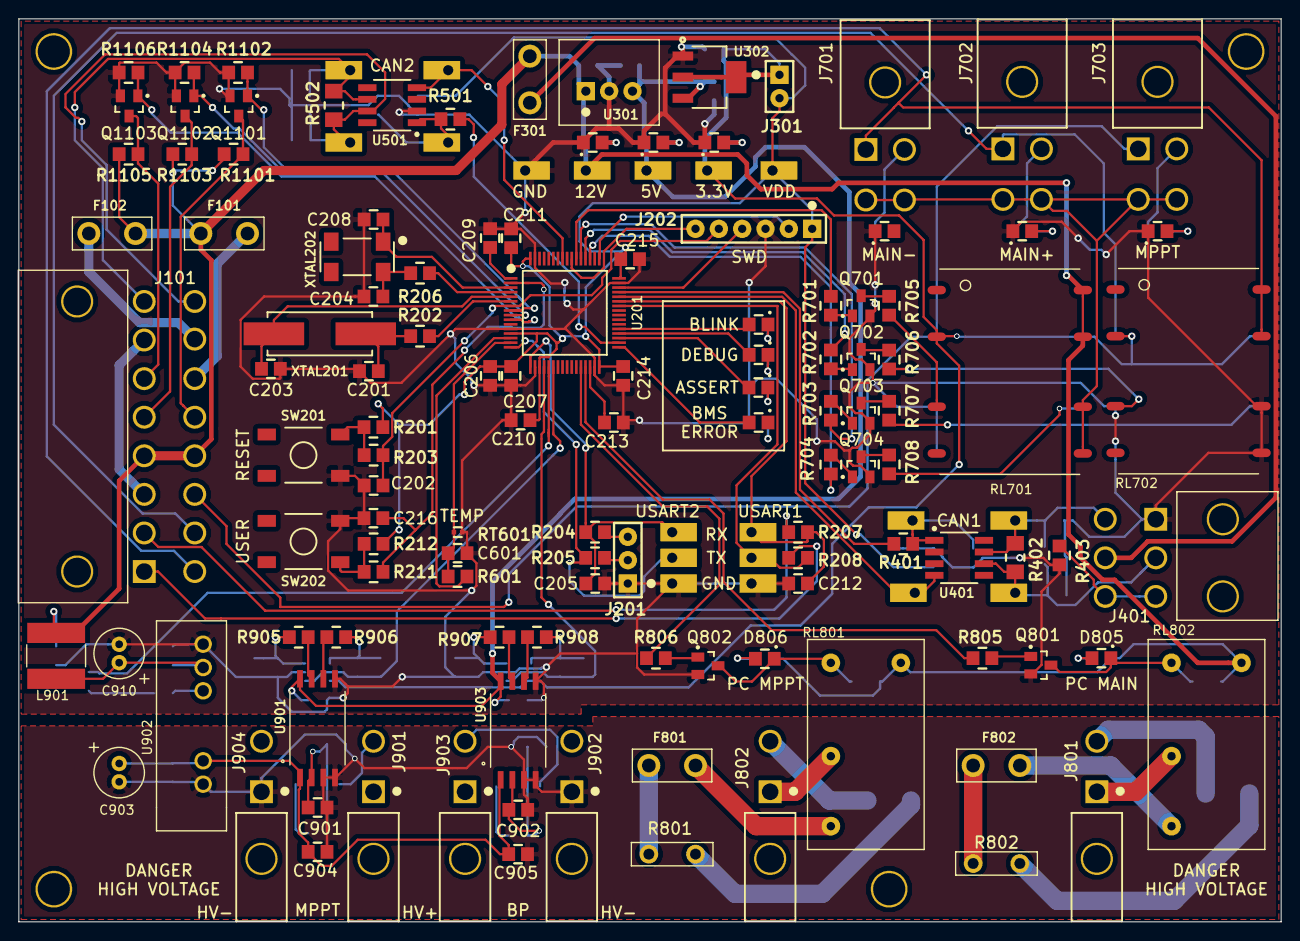
[picture p55: board Master_Board/E10/V2/Master_Board.kicad_pcb from above]

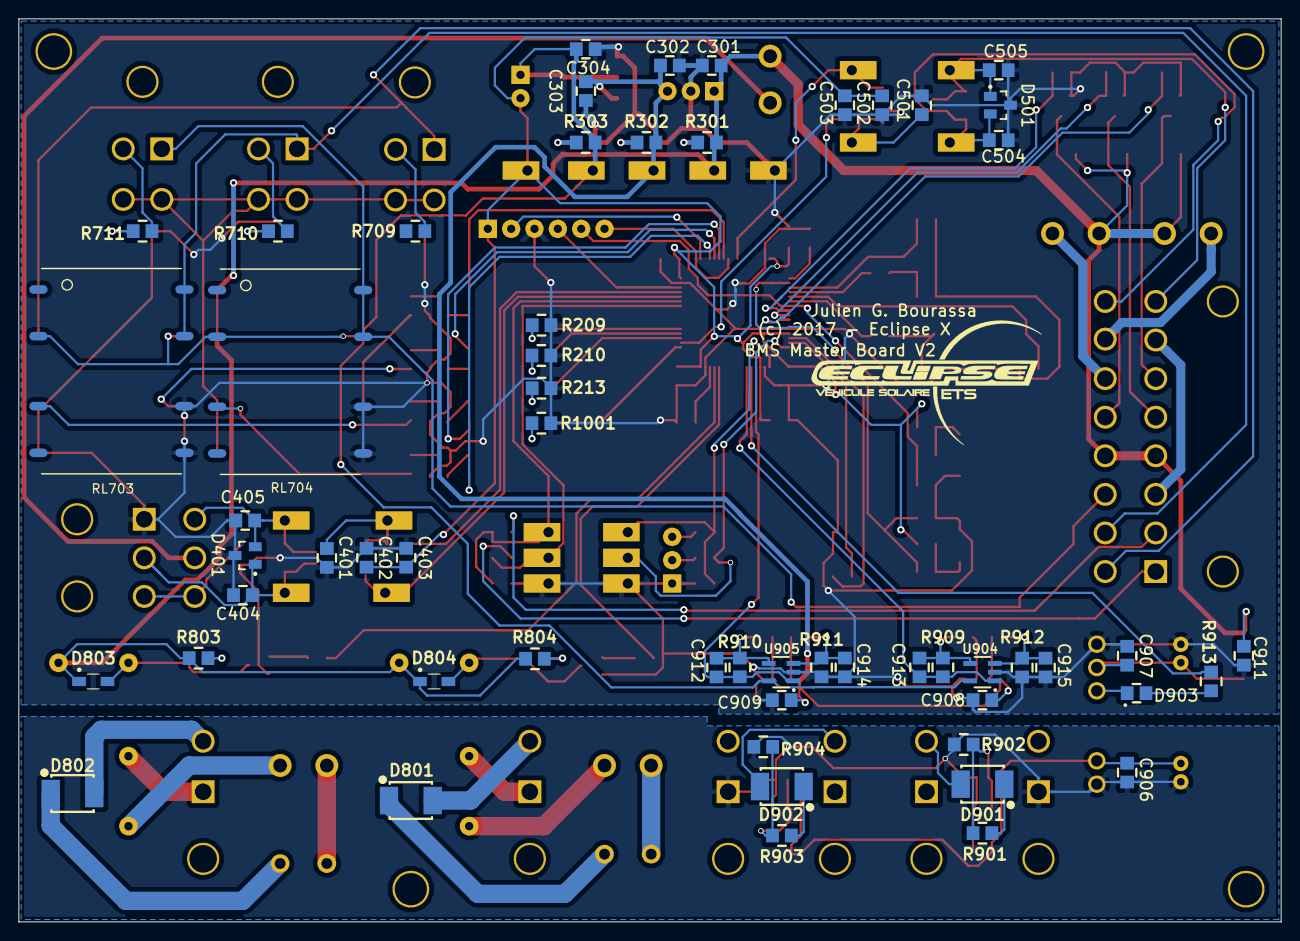
[picture p56: board Master_Board/E10/V2/Master_Board.kicad_pcb from below]

Board: 2 copper layers, 137.4 x 98.3 mm, 195 parts (57 on the bottom side), 128 nets.

Parts:
C201, C203, C205, C212, C404, C405, C504, C505: 885012007053; C0805
C202, C210, C211, C214, C215, C216, C403, C503, C904, C905, C906, C907, C908, C909: 885012207098; C0805
C204, C208: 885012007027; C0805
C206, C209, C402, C502, C601: 885012107015; C0805
C207: 885012207092; C0805
C213, C301, C302: 885012107018; C0805
C303: 885012107014; C0805
C304: 885012107005; C0805
C401, C501, C901, C902, C912, C913, C914, C915: 885012207080; C0805
C903, C910: 860020472006; Radial-Can-5_11_2
C911: 885012207075; C0805
D201, D301, D302, D303, D701, D702, D703, D805, D806: 150080VS75000; LED_0805_GREEN
D202: 150080YS75000; LED_0805_YELLOW
D203, D1001: 150080RS75000; LED_0805_RED
D401, D501: D1213A-02SOL-7; SOT-23-3
D801, D802, D901, D902: NRVBS3200T3G; DO-214AA_SMB
D803, D804: NSR0530HT1G; SOD-323
D903: SD0805S020S1R0; Diode_0805
F101, F102: 39505000440; TE5_395
F301: 39511000440; TE5_395
F801, F802: 80812000440; TE5_395
J101: 649016227222
J201: Header_Male_Pin_2.54mm_1X3_,_Unshrouded; Headers_2.54mm_1X3
J202: Header_Male_Pin_2.54mm_1X6_,_Unshrouded; Headers_2.54mm_1X6
J301: Header_Male_Pin_2.54mm_1X2_,_Unshrouded; Headers_2.54mm_1X2
J401: 649006227222
J701, J702, J703: 649004227222
J801, J802, J901, J902, J903, J904: 649002227222
L901: 744052471; WE-TPC-SMD
Q701, Q702, Q703, Q704, Q801, Q802: BC849BLT1G; SOT-23-3
Q1101, Q1102, Q1103: BSS806NH6327XTSA1; SOT-23-3
R201, R204, R207, R212, R301, R1101, R1103, R1105: RC0805JR-074K7L; R0805
R202, R206, R403: RC0805JR-070RL; R0805
R203, R211, R401, R501: RC0805JR-07100RL; R0805
R205, R208, R302, R709, R710, R711, R803, R804: RC0805JR-071KL; R0805
R209, R210, R213, R303, R913: RC0805JR-07470RL; R0805
R402, R502: RC1206JR-07120RL; R1206
R601: RC0805JR-0733KL; R0805
R701, R702, R703, R704, R805, R806, R902, R904, R905, R906, R907, R908: RC0805JR-0710KL; R0805
R705, R706, R707, R708: RC0805JR-072K2L; R0805
R801, R802: TR50JBC100R; TR50
R901, R903: RC0805JR-071ML; R0805
R909, R910, R911, R912: RC0805JR-0715KL; R0805
R1001: RC0805JR-07330RL; R0805
R1102, R1104, R1106: RC0805JR-07100KL; R0805
RL701, RL702, RL703, RL704: CPC1907B
RL801, RL802: ALQ312
RT601: NCP15WB473F03RC; R0402
SW201, SW202: PTS645SM43SMTR92; PTS645_6X6X4_SMD
TP201, TP202, TP203, TP204, TP205, TP206, TP301, TP302, TP303, TP304, TP305, TP401, TP402, TP403, TP404, TP501, TP502, TP503, TP504: Test_Point_THM; Keystone_5001
U201: STM32F446RE; LQFP-64
U301: OKI-78SR-5/1.5-W36-C; OKI-78SR_Vertical
U302: AZ1117IH-3.3TRG1; SOT-223-3
U401, U501: SN65HVD232DR; SOIC-8
U901, U903: ACPL-C87A-500E; SSO-8
U902: NCS1S2405SC
U904, U905: LMV321RILT; SOT-23-5
XTAL201: ABLS-8.000MHZ-D-T; HC49_US
XTAL202: ABS25-32.768KHZ-6-T; ABS25

Connections:
3.3V: C304.2, J301.1, R303.2, RL701.2, RL702.2, RL703.2, RL704.2, TP304.1, U302.2, U302.4, U904.5, U905.5
5V: C302.2, C303.2, C908.2, C909.2, R302.2, TP303.1, U301.3, U302.3, U901.8, U903.8
12V: C301.2, C911.1, D803.1, D804.1, F101.2, F102.2, F301.2, J101.4, J101.12, L901.2, R301.2, R803.1, R804.1, R1101.1, R1103.1, R1105.1, RL701.7, RL701.8, RL801.1, RL802.1, TP301.1, U301.1
/12V_IN1: F101.1, J101.14
/12V_IN2: F102.1, J101.15
/CAN1/CAN_N: C404.1, D401.1, J401.2, R402.2, TP404.1, U401.6
/CAN1/CAN_P: C405.1, D401.2, J401.4, R402.1, TP403.1, U401.7
/CAN1/Shield1: J401.3, J401.6, R403.1
/CAN2_H: C504.1, D501.2, J101.16, R502.1, TP503.1, U501.7
/CAN2_L: C505.1, D501.1, J101.8, R502.2, TP504.1, U501.6
/GND: J101.3, J101.7
/IO1: J101.10, J702.1, RL703.7, RL703.8
/IO2: J101.9, J701.1, RL702.7, RL702.8
/IO3: J101.11, J703.1, RL704.7, RL704.8
/IO5: J101.13, Q1101.3, R1101.2
/IO7: J101.5, Q1102.3, R1103.2
/IO8: J101.6, Q1103.3, R1105.2
/NRST: C202.1, J202.5, R203.2, U201.7
/NTC_1_ADC: C601.1, R601.1, RT601.2, U201.15
/NTC_1_GPIO: R601.2, U201.14
/PA4: C912.1, R910.2, U201.20, U905.1
/PA5: R913.2, U201.21
/PA6: C913.2, R909.2, U201.22, U904.1
/PA11: TP402.1, U201.44, U401.4
/PA12: R401.1, U201.45
/PB2: R806.2, U201.28
/PB5: TP502.1, U201.57, U501.4
/PB10: R805.2, U201.29
/PB12: D1001.2, U201.33
/PB13: R501.1, U201.34
/PB14: D203.2, U201.35
/PB15: D202.2, U201.36
/PC0: Q1101.1, R1102.2, U201.8
/PC1: Q1102.1, R1104.2, U201.9
/PC2: Q1103.1, R1106.2, U201.10
/PC6: D201.2, U201.37
/PC10: R704.1, U201.51
/PC11: R702.1, U201.52
/PC12: R703.1, U201.53
/PD2: R701.1, U201.54
/RS232_RX: J101.2, R207.1
/RS232_TX: J101.1, R208.1
/STM32F446/PA2_TX: R205.2, TP201.1, U201.16
/STM32F446/PA3_RX: C205.2, R204.2, TP202.1, U201.17
/STM32F446/PA9_TX: R208.2, TP205.1, U201.42
/STM32F446/PA10_RX: C212.2, R207.2, TP204.1, U201.43
/STM32F446/SWCLK: J202.2, U201.49
/STM32F446/SWDIO: J202.4, U201.46
/STM32F446/SWO: J202.6, U201.55
/STM32F446/USART2_RX: J201.3, R204.1
/STM32F446/USART2_TX: J201.2, R205.1
/STM32F446/USER_BTN: C216.1, R211.2, U201.2
/VBat: C209.2, U201.1
/Voltage Sense/5V_ISO: C903.1, C904.2, C905.2, C906.1, U901.1, U902.6, U903.1
/Voltage Sense/BP-HV+: D902.1, R903.1
/Voltage Sense/MPPT-HV+: D901.1, R901.1
AGND: C901.2, C902.2, C903.2, C904.1, C905.1, C906.2, J902.1, J904.1, R902.2, R904.2, U901.3, U901.4, U902.7, U903.3, U903.4
CAN_PWR: F301.1, J401.5
DGND: C201.1, C202.2, C203.2, C204.1, C205.1, C206.1, C207.1, C208.2, C209.1, C210.2, C211.1, C212.1, C213.1, C214.2, C215.2, C216.2, C301.1, C302.1, C303.1, C304.1, C401.1, C402.1, C403.1, C404.2, C405.2, C501.2, C502.1, C503.1, C504.2, C505.2, C601.2, C907.2, C908.1, C909.1, C910.2, C911.2, C914.1, C915.1, D301.1, D302.1, D303.1, D401.3, D501.3, D701.1, D702.1, D703.1, J201.1, J202.3, J401.1, Q701.2, Q702.2, Q703.2, Q704.2, Q801.2, Q802.2, Q1101.2, Q1102.2, Q1103.2, R209.1, R210.1, R213.1, R403.2, R911.2, R912.2, R1001.1, R1102.1, R1104.1, R1106.1, RL702.5, RL702.6, RL703.5, RL703.6, RL704.5, RL704.6, RT601.1, SW201.4, SW202.3, TP203.1, TP206.1, TP302.1, U201.12, U201.18, U201.31, U201.47, U201.63, U301.2, U302.1, U401.2, U501.2, U901.5, U902.1, U903.5, U904.2, U905.2
unnamed: C201.2, R202.2, XTAL201.1
unnamed: C203.1, U201.5, XTAL201.2
unnamed: C204.2, R206.2, XTAL202.4
unnamed: C208.1, U201.3, XTAL202.1
unnamed: C213.2, U201.30
unnamed: C401.2, R401.2, TP401.1, U401.1
unnamed: C501.1, R501.2, TP501.1, U501.1
unnamed: C901.1, R901.2, R902.1, U901.2
unnamed: C902.1, R903.2, R904.1, U903.2
unnamed: C907.1, C910.1, L901.1, U902.2
unnamed: C912.2, R908.2, R910.1, U905.4
unnamed: C913.1, R906.2, R909.1, U904.4
unnamed: C914.2, R907.2, R911.1, U905.3
unnamed: C915.2, R905.2, R912.1, U904.3
unnamed: D201.1, R209.2
unnamed: D202.1, R210.2
unnamed: D203.1, R213.2
unnamed: D301.2, R301.1
unnamed: D302.2, R302.1
unnamed: D303.2, R303.1
unnamed: D701.2, R709.2
unnamed: D702.2, R710.2
unnamed: D703.2, R711.2
unnamed: D801.1, R801.1
unnamed: D801.2, J802.2
unnamed: D802.1, R802.1
unnamed: D802.2, J801.2
unnamed: D803.2, D805.1, Q801.3, RL802.2
unnamed: D804.2, D806.1, Q802.3, RL801.2
unnamed: D805.2, R803.2
unnamed: D806.2, R804.2
unnamed: D901.2, J901.2
unnamed: D902.2, J903.2
unnamed: D903.1, U902.3
unnamed: D903.2, R913.1
unnamed: D1001.1, R1001.2
unnamed: F801.1, R801.2
unnamed: F801.2, RL801.4
unnamed: F802.1, R802.2
unnamed: F802.2, RL802.4
unnamed: J701.2, R709.1
unnamed: J701.3, J701.4, J702.3, J702.4, J703.3, J703.4, RL701.5, RL701.6
unnamed: J702.2, R710.1
unnamed: J703.2, R711.1
unnamed: J801.1, RL802.3
unnamed: J802.1, RL801.3
unnamed: Q701.1, R701.2
unnamed: Q701.3, R705.1
unnamed: Q702.1, R702.2
unnamed: Q702.3, R706.1
unnamed: Q703.1, R703.2
unnamed: Q703.3, R707.1
unnamed: Q704.1, R704.2
unnamed: Q704.3, R708.1
unnamed: Q801.1, R805.1
unnamed: Q802.1, R806.1
unnamed: R201.1, R203.1, SW201.2
unnamed: R202.1, U201.6
unnamed: R206.1, U201.4
unnamed: R211.1, R212.1, SW202.1
unnamed: R705.2, RL701.3
unnamed: R706.2, RL702.3
unnamed: R707.2, RL703.3
unnamed: R708.2, RL704.3
unnamed: R905.1, U901.7
unnamed: R906.1, U901.6
unnamed: R907.1, U903.7
unnamed: R908.1, U903.6
VDD: C206.2, C207.2, C210.1, C211.2, C214.1, C215.1, C402.2, C403.2, C502.2, C503.2, J202.1, J301.2, R201.2, R212.2, TP305.1, U201.13, U201.19, U201.32, U201.48, U201.64, U401.3, U501.3
