EclipseETS/E10-BMS-HW/Current_Sense/V1/Isolated_BMS_Slave_Current_Sense.kicad_pcb

## KiCad design Current_Sense/V1/Isolated_BMS_Slave_Current_Sense.kicad_pcb (2017-08-23)

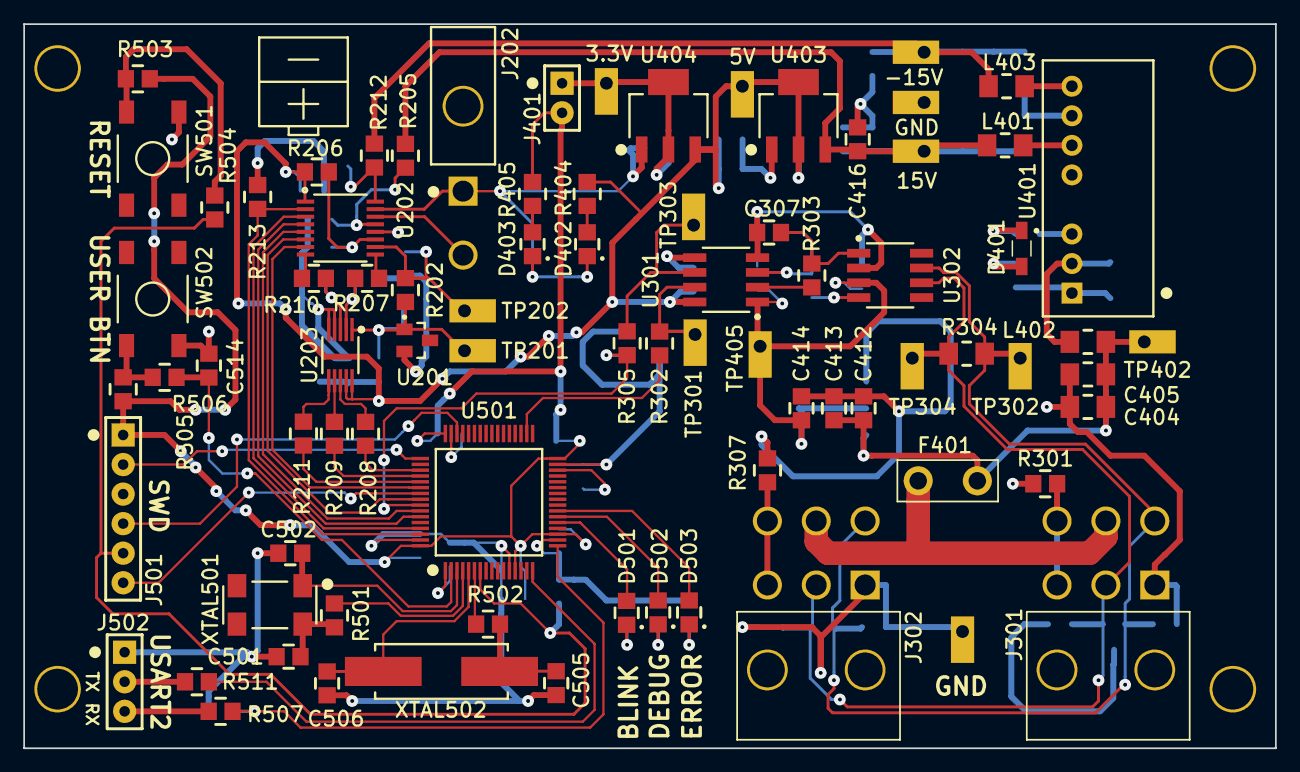
[picture p57: board Isolated_BMS_Slave_Current_Sense.kicad_pcb from above]

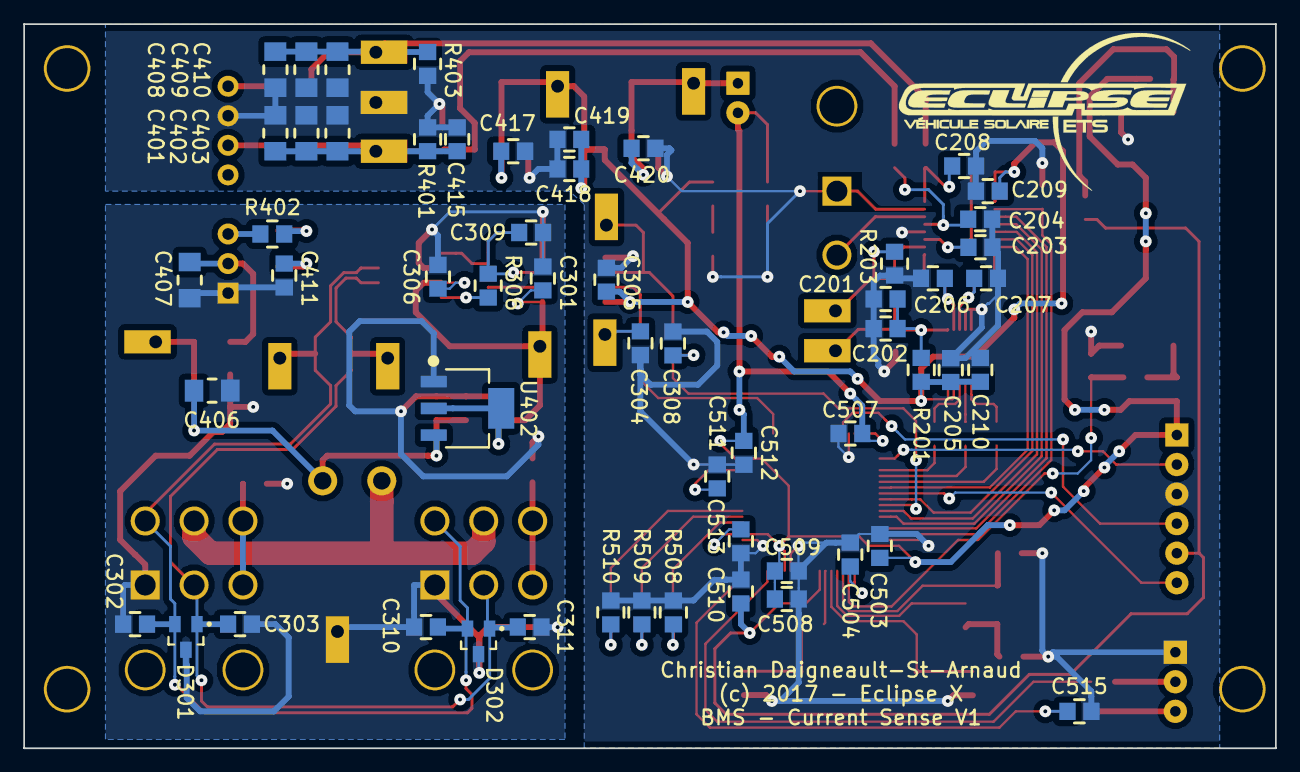
[picture p58: board Isolated_BMS_Slave_Current_Sense.kicad_pcb from below]

Board: 2 copper layers, 107.6 x 62.2 mm, 137 parts (56 on the bottom side), 77 nets.

Parts:
C201, C504, C508: 885012107015; C0805
C202, C205, C209, C301, C305, C306, C411, C503, C507, C510, C512, C513, C514: 885012207098; C0805
C203, C204, C208: 885012207102; C0805
C206, C207, C302, C303, C310, C311: Capacitor_Generic; C0805
C210, C412, C413, C415, C416, C418, C419, C511: 885012107018; C0805
C304, C307, C308, C309: 885012207080; C0805
C401, C402, C403, C404, C405, C406, C407, C408, C409, C410: C3216X5R1E336M160AC; C1206
C414, C417, C420: 885012107014; C0805
C501, C502: 885012007027; C0805
C505, C506, C515: 885012007053; C0805
C509: 885012207092; C0805
D301, D302: D1213A-02SOL-7; SOT-23-3
D401: NSR0530HT1G; SOD-323
D402, D403, D501: 150080VS75000; LED_0805_GREEN
D502: 150080YS75000; LED_0805_YELLOW
D503: 150080RS75000; LED_0805_RED
F401: 39511000440; TE5_395
J202: 649002227222
J301, J302: 649006227222
J401: Header_Male_Pin_2.54mm_1X2_,_Unshrouded; Headers_2.54mm_1X2
J501: Header_Male_Pin_2.54mm_1X6_,_Unshrouded; Headers_2.54mm_1X6
J502: Header_Male_Pin_2.54mm_1X3_,_Unshrouded; Headers_2.54mm_1X3
L401, L402, L403: LQM31PN4R7M00L; I1206
R201: RC0805JR-072K2L; R0805
R202, R203, R213: RC0805JR-0747KL; R0805
R205, R206, R212: RC0805JR-0722RL; R0805
R207, R210, R401, R403: Resistor_Generic; R0805
R208, R209, R211, R302, R303, R305, R306, R504, R506: RC0805JR-07100RL; R0805
R301, R307, R501, R502: RC0805JR-070RL; R0805
R304: RC1206JR-07120RL; R1206
R402, R511: RC0805JR-071KL; R0805
R404, R405, R508, R509, R510: RC0805JR-07470RL; R0805
R503, R505, R507: RC0805JR-074K7L; R0805
SW501, SW502: PTS645SM43SMTR92; PTS645_6X6X4_SMD
TP201, TP202, TP301, TP302, TP303, TP304, TP401, TP402, TP403, TP404, TP405, TP406, TP407, TP408: Test_Point_THM; Keystone_5001
U201: LM4040CYM3-4.1-TR; SOT-23-3
U202: PGA281AIPWR; TSSOP-16
U203: ADC141S626CIMM/NOPB; VSSOP-10
U301: SI8422AB-D-IS; SOIC-8
U302: SN65HVD232DR; SOIC-8
U401: PQMC3-D12-D15-S; PQMC3
U402, U404: NCP1117LPST33T3G; SOT-223-3
U403: NCP1117ST50T3G; SOT-223-3
U501: STM32F446RE; LQFP-64
XTAL501: ABS25-32.768KHZ-6-T; ABS25
XTAL502: ABLS-8.000MHZ-D-T; HC49_US

Connections:
3.3VA: C301.1, C306.1, C414.2, TP405.1, U301.1, U302.3, U402.2, U402.4
5VB: C205.1, C209.1, C210.1, C305.1, C417.2, C418.2, C419.2, R201.2, R206.2, R404.2, TP406.1, U202.1, U203.9, U203.10, U301.8, U403.2, U403.4, U404.3
12VA: C404.2, C405.2, C406.2, C412.2, C413.2, F401.2, L402.2, TP402.1, U402.3
15VB: C401.2, C402.2, C403.2, C415.2, C416.2, L401.1, R205.2, R401.2, TP401.1, U403.3
-15VB: C408.1, C409.1, C410.1, L403.1, R212.1, R403.1, TP408.1
/Communication Interface/CAN_N: C303.2, C311.2, D301.1, D302.1, J301.2, J302.2, R304.1, TP304.1, U302.6
/Communication Interface/CAN_P: C302.2, C310.2, D301.2, D302.2, J301.4, J302.4, R304.2, TP302.1, U302.7
/Communication Interface/RXD: R306.2, U302.4
/Communication Interface/Shield1: J301.3, J301.6, R301.1
/Communication Interface/Shield2: J302.3, J302.6, R307.1
/Communication Interface/TXD: C307.2, R303.2, U302.1
/Communication Interface/uC_CAN_RX: R305.1, TP303.1, U301.6
/Communication Interface/uC_CAN_TX: C304.1, R302.2, TP301.1, U301.7
/Current Sense/CS: R211.2, U501.53
/Current Sense/DOUT: R209.2, U501.52
/Current Sense/EF: R213.2, U202.2, U501.62
/Current Sense/G0: U202.7, U501.54
/Current Sense/G1: U202.6, U501.56
/Current Sense/G2: U202.5, U501.58
/Current Sense/G3: U202.4, U501.59
/Current Sense/G4: U202.3, U501.61
/Current Sense/SHUNT+: J202.2, U202.14
/Current Sense/VREF: C201.2, C202.2, R201.1, R202.2, TP201.1, U201.1, U203.1
/Current Sense/VREF_DIV2: R202.1, R203.2, TP202.1, U202.10
/STM32F446/NRST: C510.1, J501.5, R504.2, U501.7
/STM32F446/PA2: R511.2, U501.16
/STM32F446/PA3: C515.2, R507.2, U501.17
/STM32F446/PA5: D501.2, U501.21
/STM32F446/PA6: D502.2, U501.22
/STM32F446/PA7: D503.2, U501.23
/STM32F446/PB5: C308.1, R305.2, U501.57
/STM32F446/PB13: R302.1, U501.34
/STM32F446/PC10: R208.2, U501.51
/STM32F446/SWCLK: J501.2, U501.49
/STM32F446/SWDIO: J501.4, U501.46
/STM32F446/SWO: J501.6, U501.55
/STM32F446/USART2_RX: J502.3, R507.1
/STM32F446/USART2_TX: J502.2, R511.1
/STM32F446/USER_BTN: C514.1, R506.2, U501.2
/STM32F446/VBat: C504.2, U501.1
CAN_PWR: F401.1, J301.5, J302.5
DGND: C201.1, C202.1, C203.2, C204.1, C205.2, C206.1, C207.2, C208.1, C209.2, C210.2, C304.2, C305.2, C308.2, C401.1, C402.1, C403.1, C408.2, C409.2, C410.2, C415.1, C416.1, C417.1, C418.1, C419.1, C420.1, C501.1, C502.2, C503.1, C504.1, C505.1, C506.2, C507.2, C508.1, C509.1, C510.2, C511.1, C512.2, C513.2, C514.2, C515.1, D402.1, D403.1, J202.1, J501.3, J502.1, R203.1, R213.1, R401.1, R403.2, R508.1, R509.1, R510.1, SW501.4, SW502.3, TP403.1, U201.2, U202.12, U202.15, U203.4, U203.5, U301.5, U401.7, U403.1, U404.1, U501.12, U501.18, U501.31, U501.47, U501.63
GNDA: C301.2, C302.1, C303.1, C306.2, C307.1, C309.1, C310.1, C311.1, C404.1, C405.1, C406.1, C407.1, C411.1, C412.1, C413.1, C414.1, D301.3, D302.3, J301.1, J302.1, R301.2, R307.2, TP404.1, U301.4, U302.2, U401.1, U402.1
unnamed: C203.1, R206.1, U202.11
unnamed: C204.2, R205.1, U202.13
unnamed: C206.2, R207.2, U203.2
unnamed: C207.1, R210.2, U203.3
unnamed: C208.2, R212.2, U202.16
unnamed: C309.2, R306.1, U301.3
unnamed: C407.2, L402.1, U401.2
unnamed: C411.2, D401.2
unnamed: C420.2, J401.1, TP407.1, U404.2, U404.4
unnamed: C501.2, R501.2, XTAL501.4
unnamed: C502.1, U501.3, XTAL501.1
unnamed: C505.2, R502.2, XTAL502.1
unnamed: C506.1, U501.5, XTAL502.2
unnamed: C511.2, U501.30
unnamed: D401.1, R402.2
unnamed: D402.2, R404.1
unnamed: D403.2, R405.1
unnamed: D501.1, R508.2
unnamed: D502.1, R509.2
unnamed: D503.1, R510.2
unnamed: L401.2, U401.6
unnamed: L403.2, U401.8
unnamed: R207.1, U202.9
unnamed: R208.1, U203.8
unnamed: R209.1, U203.7
unnamed: R210.1, U202.8
unnamed: R211.1, U203.6
unnamed: R303.1, U301.2
unnamed: R402.1, U401.3
unnamed: R501.1, U501.4
unnamed: R502.1, U501.6
unnamed: R503.1, R504.1, SW501.2
unnamed: R505.1, R506.1, SW502.1
VDD: C503.2, C507.1, C508.2, C509.2, C512.1, C513.1, J401.2, J501.1, R405.2, R503.2, R505.2, U501.13, U501.19, U501.32, U501.48, U501.64
