EclipseETS/E10-BMS-HW/Current_Sense/V1/Current_sense/Current_sense.ioc

Mcu.UserName=STM32F446RETx
PA0-WKUP.GPIO_Label=NTC_ADC
PA0-WKUP.Signal=ADCx_IN0
PA1.GPIO_Label=NTC_GPIO
PA1.Signal=GPIO_Output
PA13.Signal=SYS_JTMS-SWDIO
PA14.Signal=SYS_JTCK-SWCLK
PA2.Signal=USART2_TX
PA3.Signal=USART2_RX
PA5.GPIO_Label=BLINK
PA5.Signal=GPIO_Output
PA6.GPIO_Label=DEBUG
PA6.Signal=GPIO_Output
PA7.GPIO_Label=ERROR
PA7.Signal=GPIO_Output
PB13.Signal=CAN2_TX
PB3.Signal=SYS_JTDO-SWO
PB4.GPIO_Label=G1_GPIO
PB4.Signal=GPIO_Output
PB5.Signal=CAN2_RX
PB6.GPIO_Label=G2_GPIO
PB6.Signal=GPIO_Output
PB7.GPIO_Label=G3_GPIO
PB7.Signal=GPIO_Output
PB8.GPIO_Label=G4_GPIO
PB8.Signal=GPIO_Output
PC10.Signal=SPI3_SCK
PC11.Signal=SPI3_MISO
PC12.GPIO_Label=CS
PC12.Signal=GPIO_Output
PC13.GPIO_Label=USER_BTN
PC13.Signal=GPIO_Input
PC14-OSC32_IN.Signal=RCC_OSC32_IN
PC15-OSC32_OUT.Signal=RCC_OSC32_OUT
PD2.GPIO_Label=G0_Output
PD2.Signal=GPIO_Output
PH0-OSC_IN.Signal=RCC_OSC_IN
PH1-OSC_OUT.Signal=RCC_OSC_OUT
