EclipseETS/E10-BMS-HW/(commit log)

2017-06-08 Start sch of slave
    [CAN.sch, Isolated_BMS_Slave_Front_End.sch, Power Supply.sch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]
2017-06-08 clear annotation
    [CAN.sch, Isolated_BMS_Slave_Front_End.sch, Power Supply.sch, STM32F446.sch, balancing.sch, power_supply_front_end.sch, voltage_reading.sch]
2017-06-08 add notes
    [Isolated_BMS_Slave_Front_End.sch, balancing.sch]
2017-06-08 add LED to reverse protection + balancing
    [Isolated_BMS_Slave_Front_End.sch, Slave.sch, balancing.sch]
2017-06-11 placing components
    [CAN.sch, Isolated_BMS_Slave_Front_End.sch, Power Supply.sch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]
2017-06-11 Add file Master_Board
    [CAN.sch, Master_Board.kicad_pcb, Master_Board.sch, Power Supply.sch, STM32F446.sch]
2017-06-11 placing component on front end
    [Isolated_BMS_Slave_Front_End.sch, Slave.kicad_pcb, Slave.sch, balancing.sch, power_supply_front_end.sch]
2017-06-11 adding 8 front end
    [CAN.sch, Isolated_BMS_Slave_Front_End.sch, Power Supply.sch, STM32F446.sch, Slave.kicad_pcb, Slave.sch, balancing.sch, power_supply_front_end.sch]
2017-06-11 placed front end 1 to 5
    [CAN.sch, Isolated_BMS_Slave_Front_End.sch, Power Supply.sch, STM32F446.sch, Slave.kicad_pcb, Slave.sch, balancing.sch, power_supply_front_end.sch]
2017-06-11 placed front end nb 8
    [Slave.kicad_pcb]
2017-06-12 front end done
    [Isolated_BMS_Slave_Front_End.sch, Slave.kicad_pcb, balancing.sch, power_supply_front_end.sch, voltage_reading.sch]
2017-06-12 place connector
    [CAN.sch, Isolated_BMS_Slave_Front_End.sch, Power Supply.sch, Slave.kicad_pcb, Slave.sch, balancing.sch]
2017-06-12 Add Master_Board files
    [CAN1.sch, CAN2.sch, ContactorControl.sch, Isolated.sch, Precharge.sch, TempSens.sch, VoltageSense.sch]
2017-06-15 Place front end to fit battery pack
    [Slave.kicad_pcb]
2017-06-16 Routing signals
    [CAN.sch, Isolated_BMS_Slave_Front_End.sch, Power Supply.sch, STM32F446.sch, Slave.kicad_pcb, Slave.sch, power_supply_front_end.sch]
2017-06-16 Routing signals 2
    [Isolated_BMS_Slave_Front_End.sch, Slave.kicad_pcb, Slave.sch]
2017-06-17 Routing done, DRC almost clean
    [Slave.kicad_pcb, Slave.sch]
2017-06-17 add cutout next to crystals, DRC clean
    [Slave.kicad_pcb]
2017-06-17 DRC Clean
    [Slave.kicad_pcb]
2017-06-17 add capacitor to Temperature reading
    [Slave.kicad_pcb, Slave.sch]
2017-06-17 Add Master_Board modules
    [CAN.sch, ContactorControl.sch, Isolated.sch, Master_Board.sch, Power Supply.sch, Precharge.sch, STM32F446.sch, TempSens.sch]
2017-06-18 add SWD silkscreen
    [Slave.kicad_pcb]
2017-06-18 add silkscreen USART2
    [Slave.kicad_pcb]
2017-06-18 ioc: add spi3_mosi and set pwm mode for tim8 channels
2017-06-18 generate gerber
    [Slave-B.Cu.gbl, Slave-B.Mask.gbs, Slave-B.SilkS.gbo, Slave-Edge.Cuts.gm1, Slave-F.Cu.gtl, Slave-F.Mask.gts, Slave-F.SilkS.gto, Slave.drl]
2017-06-18 git modify Master_board
    [CAN1.sch, ContactorControl.sch, Isolated.sch, Master_Board.sch, STM32F446.sch, TempSens.sch, VoltageSense.sch]
2017-06-19 Add filter in VoltageSense
    [CAN2.sch, Precharge.sch, TempSens.sch, VoltageSense.sch]
2017-06-21 fix library LED issue
    [Isolated_BMS_Slave_Front_End.sch]
2017-06-21 Add page LedDriver
    [CAN1.sch, CAN2.sch, ContactorControl.sch, Isolated.sch, LedDriver.sch, Master_Board.sch, Power Supply.sch, Precharge.sch]
2017-06-21 schematic small fix
    [CAN.sch, Power Supply.sch, STM32F446.sch, Slave.sch]
2017-06-21 Modify MasterBoard.sch
    [CAN1.sch, CAN2.sch, ContactorControl.sch, Isolated.sch, LedDriver.sch, Master_Board.sch, Power Supply.sch, Precharge.sch]
2017-06-23 Add page LEDDriver.sch
    [CAN1.sch, CAN2.sch, ContactorControl.sch, Isolated.sch, LedDriver.sch, Master_Board.sch, Power Supply.sch, Precharge.sch]
2017-06-23 Create Master board PCB
    [Master_Board.kicad_pcb, Precharge.sch, STM32F446.sch, VoltageSense.sch]
2017-06-26 Modify Master_board PCB
    [CAN1.sch, CAN2.sch, ContactorControl.sch, Isolated.sch, LedDriver.sch, Master_Board.kicad_pcb, Master_Board.sch, Power Supply.sch]
2017-06-26 Routing Master PCB
    [Master_Board.kicad_pcb]
2017-06-27 add resistor to op amp power
    [STM32F446.sch, current_sense.sch]
2017-06-27 update component
    [Isolated_BMS_Slave_Front_End.sch]
2017-06-27 Routing BmsMasterBoard
    [ContactorControl.sch, LedDriver.sch, Master_Board.kicad_pcb, Precharge.sch, TempSens.sch, VoltageSense.sch]
2017-06-28 add comment
    [current_sense.sch]
2017-06-28 Release1 MasterBoard PCB
    [CAN1.sch, CAN2.sch, ContactorControl.sch, Isolated.sch, LedDriver.sch, Master_Board.kicad_pcb, Master_Board.sch, Power Supply.sch]
2017-06-29 Fix some routing on MasterBoard
    [CAN1.sch, CAN2.sch, ContactorControl.sch, Isolated.sch, LedDriver.sch, Master_Board.kicad_pcb, Master_Board.sch, Power Supply.sch]
2017-07-03 Move precharge resistor
    [CAN1.sch, CAN2.sch, ContactorControl.sch, LedDriver.sch, Master_Board.kicad_pcb, Master_Board.sch, Power Supply.sch, Precharge.sch]
2017-07-03 Modify silk screen
    [Master_Board.kicad_pcb]
2017-07-03 Add polarity safety
    [CAN1.sch, CAN2.sch, ContactorControl.sch, Isolated.sch, LedDriver.sch, Master_Board.kicad_pcb, Master_Board.sch, Power Supply.sch]
2017-07-03 Modify schematic wire in precharge
    [CAN1.sch, CAN2.sch, ContactorControl.sch, Isolated.sch, LedDriver.sch, Master_Board.kicad_pcb, Master_Board.sch, Power Supply.sch]
2017-07-03 Add gain in analog out
    [Master_Board.kicad_pcb, Master_Board.sch]
2017-07-03 Generate Gerber files
    [Master_Board-B.Cu.gbl, Master_Board-B.Mask.gbs, Master_Board-B.SilkS.gbo, Master_Board-Edge.Cuts.gm1, Master_Board-F.Cu.gtl, Master_Board-F.Mask.gts, Master_Board-F.SilkS.gto, Master_Board.drl]
2017-07-03 Add gerber files .zip
    [Master_Board.kicad_pcb]
2017-07-04 add Slave BOM
    [Slave_bom_montage.ods]
2017-07-04 start to place pin on uC
    [Isolated_BMS_Slave_Current_Sense.sch, STM32F446.sch, communication.sch, current_sense.sch, power_supply.sch]
2017-07-04 Generate BOM for slave and master
    [CAN1.sch, CAN2.sch, ContactorControl.sch, LedDriver.sch, MasterBom_Order.xlsx, Master_Board.sch, Master_Digikey.xlsx, Master_Wurth.xlsx]
2017-07-05 placing power supply
    [Isolated_BMS_Slave_Current_Sense.kicad_pcb, Isolated_BMS_Slave_Current_Sense.sch, STM32F446.sch, power_supply.sch]
2017-07-05 remove NTC, place component on PCB
    [Isolated_BMS_Slave_Current_Sense.kicad_pcb, Isolated_BMS_Slave_Current_Sense.sch, STM32F446.sch, communication.sch, current_sense.sch, power_supply.sch]
2017-07-05 routing uC
    [Isolated_BMS_Slave_Current_Sense.kicad_pcb, STM32F446.sch, communication.sch, current_sense.sch]
2017-07-05 board done, DRC clean
    [Isolated_BMS_Slave_Current_Sense.kicad_pcb, STM32F446.sch, _saved_power_supply.sch, communication.sch]
2017-07-06 minor fix
    [Isolated_BMS_Slave_Current_Sense.kicad_pcb, STM32F446.sch, _saved_power_supply.sch, communication.sch, current_sense.sch, power_supply.sch]
2017-07-10 Add Current Sense BOM
    [Master_Digikey.xlsx]
2017-07-10 Add bom for digikey/wurth
    [BMS_CurrentSense_BOM.xlsx, BMS_CurrentSense_BOM_Wurth.xlsx, BMS_CurrentSense_Bom_Digikey.xlsx]
2017-07-18 Add Master_Bom_All
    [Master_Bom_All.xlsx]
2017-07-18 Modify Master_Bom_All
    [Master_Bom_All.xlsx]
2017-07-20 add note
    [current_sense.sch]
2017-08-02 Added V2 of Master Board
    [CAN1.sch, CAN2.sch, ContactorControl.sch, LedDriver.sch, LithiumBalance_Legacy.sch, MasterBom_Order.xlsx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]
2017-08-05 Add comment for V2
    [LedDriver.sch, Master_Board.sch, VoltageSense.sch]
2017-08-22 add comment with new ADC RC filter values
    [voltage_reading.sch]
2017-08-22 Changed CAN to CAN2, add LED ID
    [CAN.sch, Isolated_BMS_Slave_Front_End.sch, Power Supply.sch, STM32F446.sch, Slave.kicad_pcb, Slave.sch, balancing.sch, power_supply_front_end.sch]
2017-08-22 add drill map
2017-08-22 Add Module and thermistor ID
    [Slave-B.Cu.gbl, Slave-B.Mask.gbs, Slave-B.SilkS.gbo, Slave-Edge.Cuts.gm1, Slave-F.Cu.gtl, Slave-F.Mask.gts, Slave-F.SilkS.gto, Slave.drl]
2017-08-22 Add Eclipse Logo, generate Gerber
    [Isolated_BMS_Slave_Current_Sense-B.Cu.gbl, Isolated_BMS_Slave_Current_Sense-B.Mask.gbs, Isolated_BMS_Slave_Current_Sense-B.SilkS.gbo, Isolated_BMS_Slave_Current_Sense-Edge.Cuts.gm1, Isolated_BMS_Slave_Current_Sense-F.Cu.gtl, Isolated_BMS_Slave_Current_Sense-F.Mask.gts, Isolated_BMS_Slave_Current_Sense-F.SilkS.gto, Isolated_BMS_Slave_Current_Sense.drl]
2017-08-22 Place part in PCB
    [CAN1.sch, CAN2.sch, ContactorControl.sch, LedDriver.sch, LithiumBalance_Legacy.sch, MasterBom_Order.xlsx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]
2017-08-23 Move CAN to CAN2, Generate GERBER
    [Isolated_BMS_Slave_Current_Sense-B.Cu.gbl, Isolated_BMS_Slave_Current_Sense-B.Mask.gbs, Isolated_BMS_Slave_Current_Sense-B.SilkS.gbo, Isolated_BMS_Slave_Current_Sense-Edge.Cuts.gm1, Isolated_BMS_Slave_Current_Sense-F.Cu.gtl, Isolated_BMS_Slave_Current_Sense-F.Mask.gts, Isolated_BMS_Slave_Current_Sense-F.SilkS.gto, Isolated_BMS_Slave_Current_Sense.drl]
2017-08-23 Fix funky trace, Generate GERBER
    [Isolated_BMS_Slave_Current_Sense-B.Cu.gbl, Isolated_BMS_Slave_Current_Sense-B.Mask.gbs, Isolated_BMS_Slave_Current_Sense-B.SilkS.gbo, Isolated_BMS_Slave_Current_Sense-Edge.Cuts.gm1, Isolated_BMS_Slave_Current_Sense-F.Cu.gtl, Isolated_BMS_Slave_Current_Sense-F.Mask.gts, Isolated_BMS_Slave_Current_Sense-F.SilkS.gto, Isolated_BMS_Slave_Current_Sense.drl]
2017-08-23 Done placing parts on PCB
    [LedDriver.sch, Master_Board.kicad_pcb, VoltageSense.sch]
2017-08-29 Route small traces
    [Master_Board.kicad_pcb, Master_Board.sch, STM32F446.sch, VoltageSense.sch]
2017-09-06 Finish routing
    [Master_Board.kicad_pcb]
2017-09-11 Add project preview
    [Master_Board.kicad_pcb]
2017-11-02 Added BOM files
    [Master_BOM.xlsx, Master_Digikey.xlsx, Master_Wurth.xlsx]
2018-02-14 schematic master V3
    [CAN1.sch, CAN2.sch, ContactorControl.sch, LedDriver.sch, LithiumBalance_Legacy.sch, Master_BOM.xlsx, Master_Board.kicad_pcb, Master_Board.sch]
2018-02-18 Rooting Master V3
    [ContactorControl.sch, LedDriver.sch, LithiumBalance_Legacy.sch, Master_Board.kicad_pcb, Master_Board.sch, Precharge.sch, VoltageSense.sch]
2018-02-18 Silkscreen Master V3
    [Master_Board.kicad_pcb]
2018-02-18 Schematic was unsaved
    [ContactorControl.sch, LedDriver.sch, LithiumBalance_Legacy.sch, Master_Board.sch, Precharge.sch, VoltageSense.sch]
2018-02-24 Correction of kill switch circuit
    [ContactorControl.sch, LedDriver.sch, LithiumBalance_Legacy.sch, Master_Board.kicad_pcb, Precharge.sch, VoltageSense.sch]
2018-04-13 Changed values of optocoupler resistor
    [CAN1.sch, CAN2.sch, ContactorControl.sch, LedDriver.sch, LithiumBalance_Legacy.sch, Master_Board.kicad_pcb, Master_Board.sch, Power Supply.sch]
2018-05-02 Add the do not install mark to the fan resistor
    [LithiumBalance_Legacy.sch]
2018-08-02 add master V4 base on the V3
    [CAN1.sch, CAN2.sch, ContactorControl.sch, LedDriver.sch, LithiumBalance_Legacy.sch, Master_BOM.xlsx, Master_Board.kicad_pcb, Master_Board.sch]
2018-08-02 Reparation of the fan circuit -no more patch require on the PSU
    [CAN1.sch, CAN2.sch, ContactorControl.sch, LedDriver.sch, LithiumBalance_Legacy.sch, Master_Board.kicad_pcb, Master_Board.sch, Power Supply.sch]
2018-09-20 Repair broken librairy references
    [CAN1.sch, CAN2.sch, ContactorControl.sch, LedDriver.sch, LithiumBalance_Legacy.sch, Master_Board.sch, Power Supply.sch, Precharge.sch]
2018-09-20 Add pull-up and connector to Master V4 circuit
    [CAN1.sch, Master_Board.sch, Power Supply.sch, Precharge.sch, STM32F446.sch, VoltageSense.sch]
2018-09-21 Remove big crappy connector and remap 12V
    [CAN1.sch, CAN2.sch, ContactorControl.sch, Master_Board.sch, Power Supply.sch, Precharge.sch, STM32F446.sch, VoltageSense.sch]
2018-09-21 Change name of schematic Fan Control
    [CAN1-2018-09-17-20-30-19.sch, CAN1-2018-09-17-20-49-49.sch, CAN1-2018-09-17-20-55-31.sch, CAN1-2018-09-17-21-05-54.sch, CAN1-2018-09-17-21-07-35.sch, CAN1-2018-09-17-21-08-32.sch, CAN1-2018-09-17-21-09-01.sch, CAN1-2018-09-17-21-10-31.sch]
2018-09-21 clean schematic
    [Master_Board.sch]
2018-09-21 add usb schematic
    [CAN1.sch, CAN2.sch, ContactorControl.sch, Fan Control.sch, Master_Board.sch, Power Supply.sch, Precharge.sch, STM32F446.sch]
2018-10-07 add negative contactor reading and start USB feature
    [ContactorControl.sch, Master_Board.sch, Precharge.sch, USB.sch, VoltageSense.sch]
2018-10-08 Add ESD Protection and filtering to the USB circuit
    [Master_Board.sch, USB.sch]
2018-10-08 add gpio to negative contactor reading
    [Master_Board.sch]
2018-10-12 Update of schematic for master E10.1
    [ContactorControl.sch, Fan Control.sch, Master_Board.sch, Power Supply.sch, Precharge.sch, STM32F446.sch, USB.sch, VoltageSense.sch]
2018-10-27 Master V4 routed
    [ContactorControl.sch, Fan Control.sch, Master_Board.kicad_pcb, Power Supply.sch, Precharge.sch, STM32F446.sch, VoltageSense.sch, _saved_Master_Board.sch]
2018-10-27 Repair USB ESD protection net
    [Master_Board.kicad_pcb, Master_Board.sch, USB.sch, _saved_Master_Board.sch, _saved_USB.sch]
2018-10-27 Reanotate all schematic and finish routing
    [ContactorControl.sch, Fan Control.sch, Master_Board.kicad_pcb, Master_Board.sch, Power Supply.sch, Precharge.sch, STM32F446.sch, USB.sch]
2018-10-27 Make E10 & E10.1 Folder for Master
    [CAN1-2018-09-17-20-30-19.sch, CAN1-2018-09-17-20-49-49.sch, CAN1-2018-09-17-20-55-31.sch, CAN1-2018-09-17-21-05-54.sch, CAN1-2018-09-17-21-07-35.sch, CAN1-2018-09-17-21-08-32.sch, CAN1-2018-09-17-21-09-01.sch, CAN1-2018-09-17-21-10-31.sch]
2018-10-28 align fuse
    [Master_Board.kicad_pcb]
2018-10-28 Add info silkscreen on the board
    [Master_Board.kicad_pcb]
2018-10-29 Refresh footprint for newer 3D model
    [Master_Board.kicad_pcb]
2018-11-10 Modification after review
    [Master_Board.kicad_pcb, _saved_CAN2.sch, _saved_ContactorControl.sch, _saved_Master_Board.sch]
2018-11-13 Beef that trace
    [CAN2.sch, ContactorControl.sch, Master_Board.kicad_pcb, Master_Board.sch, _saved_CAN2.sch, _saved_ContactorControl.sch, _saved_Master_Board.sch]
2018-12-06 add Vusb_sense
    [Master_Board.kicad_pcb, Master_Board.sch, STM32F446.sch, USB.sch]
2019-01-12 last minute change
    [Master_Board.kicad_pcb, USB.sch, VoltageSense.sch]
2019-01-19 fix symbol mapping
    [CAN-2019-01-18-20-08-57.sch, Isolated_BMS_Slave_Front_End-2019-01-18-20-08-57.sch, Power Supply-2019-01-18-20-08-57.sch, STM32F446-2019-01-18-20-08-57.sch, Slave-2019-01-18-20-08-57.sch, balancing-2019-01-18-20-08-57.sch, power_supply_front_end-2019-01-18-20-08-57.sch, voltage_reading-2019-01-18-20-08-57.sch]
2019-01-19 Generate Gerber and bom
    [Master_BOM.xlsx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]
2019-01-19 fix cristal, OKI-H, boot0, silk align and create BOM and gerber files
    [CAN.sch, Isolated_BMS_Slave_Front_End.sch, Power Supply.sch, STM32F446.sch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]
2019-04-20 patch problem of V1
    [CAN1-2018-09-17-20-30-19.sch, CAN1-2018-09-17-20-49-49.sch, CAN1-2018-09-17-20-55-31.sch, CAN1-2018-09-17-21-05-54.sch, CAN1-2018-09-17-21-07-35.sch, CAN1-2018-09-17-21-08-32.sch, CAN1-2018-09-17-21-09-01.sch, CAN1-2018-09-17-21-10-31.sch]
2019-04-20 Routing of the patch
    [Master_Board.kicad_pcb, VoltageSense.sch]
2019-05-10 Update repo
    [CAN1.sch, CAN2.sch, ContactorControl.sch, Fan Control.sch, Master_Board.kicad_pcb, Master_Board.sch, Power Supply.sch, Precharge.sch]
2019-05-10 Modification after review of @gabChouin - Gabriel Chouinard
    [CAN1.sch, CAN2.sch, ContactorControl.sch, Master_Board.sch]
2019-05-10 Replace mounting hole
    [Master_Board.kicad_pcb]
2019-05-10 Little tweak for beauty reason
    [Master_Board.kicad_pcb]
2019-05-31 Gerber Generation Master E10.1 V2
    [Master_Board-B.Cu.gbr, Master_Board-B.Mask.gbr, Master_Board-B_Cu.gbr, Master_Board-B_Mask.gbr, Master_Board-B_Paste.gbr, Master_Board-B_SilkS.gbr, Master_Board-Edge_Cuts.gbr, Master_Board-F.Cu.gbr]
2019-12-04 BMS master board V3 added. Increased track width to allow more current for fans. No other major modifications.
    [CAN1-2018-09-17-20-30-19.sch, CAN1-2018-09-17-20-49-49.sch, CAN1-2018-09-17-20-55-31.sch, CAN1-2018-09-17-21-05-54.sch, CAN1-2018-09-17-21-07-35.sch, CAN1-2018-09-17-21-08-32.sch, CAN1-2018-09-17-21-09-01.sch, CAN1-2018-09-17-21-10-31.sch]
2019-12-14 2 new fuses added. PCB traces overhaul to support more current. Some small layout changes.
    [CAN1.sch, CAN2.sch, ContactorControl.sch, Fan Control.sch, Master_Board.kicad_pcb, Master_Board.sch, Power Supply.sch, Precharge.sch]
2019-12-14 Minor adjustments to trace routes
    [Master_Board.kicad_pcb]
2020-01-15 Update based on peer review. Missing text added, block diagram fixed.
    [Master_Board.kicad_pcb]
2020-01-25 Small layout adjustments for clarity and visibility.
    [Master_Board.kicad_pcb]
2020-02-22 moved some vias
    [Master_Board.kicad_pcb]
