EclipseETS/E10-BMS-HW/(notices)

Notices in the files:
Slave/V1/Slave.kicad_pcb:
(c) 2019 - Eclipse X
Current_Sense/V1/Isolated_BMS_Slave_Current_Sense.kicad_pcb:
(c) 2017 - Eclipse X
Master_Board/E10/V3/Master_Board.kicad_pcb:
(c) 2018 - Eclipse X
